nikolajevs/MicroGarden_V1/hardware/PCB_EU_LITE/DESIGN.md

# EU-LITE — решения, расчёты и открытые вопросы

Состояние на 26.10.2026: силовые пути L501/Q501/D501 перенесены на F.Cu, LED_OUT/LED_POS — на внешнюю медь; у F101 установлен массив 10 переходных 0,8/0,4 мм. Отверстия не пересекают окна пасты. Текущие проверки и ограничения — в [README](README.md#проверки). Gerber r2 предшествуют этим изменениям. Ток 9 А, тепловой режим, Kelvin-съёмы, работа LED-регулятора и корпус требуют стендового подтверждения.

## Решения владельца (24.10.2026)

| Вопрос | Решение |
|---|---|
| Контроллер | ESP32-WROOM-32E-N4 из базы (7,48 €), как у EU-0.1: те же GPIO; адаптация прошивки для INA238 и минимума nDIM находится в `firmware/`. ESP32-C3 Super Mini со склада не взят |
| LED-часть | **Один канал** LM3429, 69 Вт / ≈1,444 А при 48 В суммарно на трёх параллельных выходах. Линейки (0,465 А) этим каналом не питаются |
| Упрощения | Убраны тахометры вентиляторов. SD-карта, RTC и измерение мощности сохранены |
| Индикатор | **OPTOSUPPLY OSTAPA57E2A**, 5 мм, диффузный, общий анод; цена по карточке Electrobase, присланной владельцем 25.10.2026 |
| Результат | Текущая медь проверена полным профилем KiCad 10.0.7; после исправления подписи F103 осталось текстовое расхождение с платой. Статус выпуска — в README |
| Стороны монтажа (25.10.2026) | Высокие компоненты сверху; BT301 и 37 SMD, включая RTC с обвязкой, снизу; силовые детали сверху |
| Разъёмы (25.10.2026) | KF2510/KF2540 4P — угловые 90°. SHT4x сверху справа над вентиляторами; поплавок, PTC и помпа снизу; вход 24 В слева. UART на месте, microSD слева под ним |
| Плата | **100×100 мм, 4 слоя меди**, стек как у EU-0.1 (JLCPCB JLC04161H-7628) — решение владельца 25.10.2026. Размер не уменьшен, несмотря на меньшее число деталей (158 против 188+ у EU-0.1): проще уложить дроссель DTMSS-27 (≈35 мм стоймя) и силовую медь без риска |

Остальное (защита от переполюсовки, предохранители, INA, RTC, SD, SHT4x, поплавок, помпа, PTC, два вентилятора) сохранено по EU-0.1; каждое отличие — в таблице ниже.

## Отличия от EU-0.1

| Узел | EU-0.1 | EU-LITE | Уходит из закупки EU-0.1 |
|---|---|---|---:|
| 12 В | L7987 + электролит 1000 мкФ, дроссель 33 мкГн | **ST1S14PHR (склад)**, электролит 820 мкФ (склад), дроссель 22 мкГн JNRH1207 | 4,93 € |
| 3,3 В | AP63203 + SRN6045 | **ST1S10PHR и SRN2512-2R2M (склад)** | 1,52 € |
| LED | два LM3429, TK22E10N1 на радиаторе, CSD19534KCS, два SS8PH10, четыре дросселя, пять электролитов 63 В, радиатор с набором изоляции, четыре токовых шунта | **один LM3429**, BSC146N10LS5, SBRT15U100SP5, дроссель 47 мкГн/15 А, электролит 470 мкФ/63 В и шесть керамических 4,7 мкФ/100 В — всё со склада; без радиатора. Докупаются LM3429 (4,86 €), два шунта и мелочь (6,06 € вместе) | 18,29 € (24,35 € → 6,06 €) |
| Блокировка LED | LM2903 + BAT54 + делители (UVLO 19,7 В, PGOOD 12 В) | **нет**; EN2 регулятора 12 В отключает вспомогательное питание; точный порог с учётом тока EN2 не квалифицирован. При потере 3,3 В ESP32 сбрасывается, nDIM удерживает 10 кОм | 0,43 € (+ резисторы) |
| Переполюсовка | FDB5800 + делитель 5,6k/5,6k/10k | **IRL2505 (склад)** + 10 кОм + стабилитрон 12 В (предел Vgs у IRL2505 16 В) | 1,82 € (1,98 € → 0,16 €) |
| Ключ PTC | FDB5800 | **CSD19531KCS, TO-220** (Salvats, каталог), драйвер NPN+PNP как у EU-0.1 | 2,95 € |
| Измерение мощности | INA226 + два шунта 0R01 + стабилитрон 33 В + резистор | **INA238 (склад)** + два металлических шунта 7 мОм (склад); VBUS без резистора и стабилитрона (предел 85 В) | 4,55 €; другие регистры в прошивке |
| Вентиляторы | тахо на GPIO34/35, подтяжки, ESDA6V1L ×2 | **без тахо**, без ESD-диодов; контакт 3 разъёма свободен | 0,52 € |
| Поплавок | USBLC6 на входе | **без USBLC6** (1 кОм + 100 нФ + подтяжка) | 0,67 € |
| Предохранители | семь (F101–F106, F401) | **шесть**: F104 канала LED2 убран | 0,78 € |
| Входные электролиты | шесть UPW1H221MPD | два UPW1H221MPD + керамика 10 мкФ/50 В (склад) | 2,52 € |
| Клеммы и кнопки | DG301R/DG306, SMD-кнопки TACTB | **KF301-5.0-2P и кнопки 6×6×10 THT (склад)** | 2,97 € |
| Прочее | керамика и резисторы упаковками, SS510 | детали со склада, SS56 | ≈ 5,7 € |
| RGB-индикатор | нет | **D901 OSTAPA57E2A + три BC847B + 9 резисторов** (резисторы со склада) | +0,18 € + 0,85 € |
| Деталей на плате | 188 + 8 контрольных площадок | **158 + 5 контрольных площадок** | — |
| Закупка (деталь + НДС + доставка) | 81,17 € по строкам `BOM_allocated.csv` (в README EU-0.1 заявлено 81,25 €) | **38,49 €** (32,62 € + 5,87 €), включая OSTAPA57E2A и CSD19531KCS | **42,68 €** |

Закупка EU-LITE (38,49 €) включает OSTAPA57E2A по карточке Electrobase с ценой 0,85 € с НДС, присланной владельцем 25.10.2026, и CSD19531KCS по снимку локального каталога от 23.10.2026 (2,95 €, 7 шт.); наличие не проверялось через корзину. Остальные цены взяты из снимка каталога 23.10.2026; доставка 2,99 € + 2,88 € — из README EU-0.1 и не перепроверена. Это не оферта и не заказ.

## Питание

### 24 В → 12 В, ST1S14PHR

Вход 5,5–48 В, 3 А, 850 кГц, VFB 1,222 В, не синхронный (диод SS56). Выводы: 1 BOOT, 2 PG (не используется), 3 EN1 (активный низкий — на GND), 4 FB, 5 EN2 (активный высокий), 6 GND, 7 VIN, 8 SW, площадка — GND. Делитель 82 кОм + 6,2 кОм / 10 кОм: **12,00 В** номинально; оценка по VFB 1,196–1,245 В и резисторам 1 % — примерно **11,54–12,45 В**, без отдельного учёта тока FB и динамики.

EN2 питается от +24V_AUX через R104–R106 (3×150 кОм, 5 %) и R107 (47 кОм, 1 %). Расчёт без нагрузки делителя: 2,04 В при 21,6 В и 3,97 В при 42 В; худший резисторный угол при 21,6 В — около 1,94 В. **15,9 В — пересечение идеального делителя с уровнем гарантированного включения 1,5 В, а не гарантированный порог UVLO.** Эквивалентное сопротивление около 42,6 кОм делает напряжение чувствительным к току EN2. Даташит задаёт 2,7/5,8/10 мкА при EN2=12 В, но не гарантированный ток около 2 В; переносить эти числа в строгий расчёт порога нельзя. Включение и отключение на медленном изменении входа и под нагрузкой проверить на стенде. Источник: [ST1S14, Rev 3, таблицы 2/6](https://www.st.com/resource/en/datasheet/st1s14.pdf).

Дроссель 22 мкГн (JNRH1207-220M-A: Isat 5,6 А по названию карточки Electrobase) даёт пульсацию 0,33 А; выходной электролит 820 мкФ (ESR ≈60 мОм) с керамикой 10 мкФ. Устойчивость контура с таким электролитом **не рассчитана**: внутренняя компенсация, модели нет (как в cheap-version, проверка на макете).

### 12 В → 3,3 В, ST1S10PHR

Вход 2,5–18 В, синхронный, 900 кГц при SYNC на GND, VFB 0,8 В. Выводы: 1 VIN_A, 2 INH (к VIN — включён), 3 VFB, 4 AGND, 5 SYNC, 6 VIN_SW, 7 SW, 8 PGND, площадка — GND. Делитель 100 кОм / (47 кОм ‖ 100 кОм = 31,97 кОм): **3,30 В** номинально. Оценка по VFB 0,776–0,824 В (−25…+125 °C) и резисторам 1 % — примерно **3,16–3,45 В**, без отдельного учёта тока FB и динамики; прежние 3,24–3,37 В не были полным бюджетом допусков.

Дроссель — склад SRN2512-2R2M вместо 4,7 мкГн у cheap-version: пульсация 1,2 А (верхний край окна даташита 0,6–1,2 А для 3 А), пик 1,6 А при 1 А нагрузки при Isat 2,7 А; частота LC 19–22 кГц ближе к расчёту даташита (18,7 кГц), чем у 4,7 мкГн (11,6 кГц). Это выбор «из склада», а не рекомендация даташита: нагрев L201 и шум на +3V3 проверяются на макете.

Рабочий предел VIN ST1S10 — 18 В, абсолютный — 20 В: проверить выбросы +12V при пуске, сбросе и скачках нагрузки. По [ST1S10, Rev 7, разделу 5.3](https://www.st.com/resource/en/datasheet/st1s10.pdf) рекомендовано минимум 22 мкФ керамики с короткими соединениями; пример настройки LC — 3,3 мкГн / 22 мкФ. Для установленных 22 мкФ учитывать DC-bias и допуск; удалённые конденсаторы нельзя автоматически считать эквивалентными локальному на частоте переключения.

### Вход 24 В и измерение мощности

**Защита входа.** J101 (KF301) → F101 15 А → +24V_FUSED, TVS SMBJ26A (ограничение ≈42 В). Минус входа проходит через Q102 (IRL2505, TO-220 стоймя без радиатора, оценка до ≈1 Вт при проектных 9 А, нагрев требует проверки), затвор подтянут к +24V_FUSED через 10 кОм (1206) и ограничен стабилитроном 12 В: Vgs ≈11–12 В при 21,6–25 В и не выше 12,6 В при ограничении TVS. При обратной полярности Q102 закрыт. Ветви 24 В: F102 8 А (PTC), F103 6,3 А USI fast (LED, 3413.0224.11), F104 2 А (регулятор 12 В), F105 1 А (помпа); на шине 12 В — F401 2 А (вентиляторы). Избирательность и I²t не квалифицированы.

**Измерение мощности.** INA238 (VSSOP-10, выводы 1 A1, 2 A0, 3 ALERT, 4 SDA, 5 SCL, 6 VS, 7 GND, 8 VBUS, 9 IN−, 10 IN+) на 0x40; шунт — два MSMA1206R0070FCM параллельно = **3,5 мОм** в минусе между GND платы и истоком Q102 (IN+ Kelvin к GND-площадке R111). ADCRANGE=1 (±40,96 мВ): полная шкала **11,7 А** при расчётном токе платы до 8,7 А и проектном пределе 9 А; каждый шунт рассеивает 0,1–0,24 Вт. Напряжение +24V_FUSED подаётся на VBUS напрямую. Выводы, адрес и шкала INA238 сверены по первичному PDF TI 24.10.2026 (пункт 1 ниже); работа драйвера на плате не проверена.

## LED-канал

Один LM3429 (HTSSOP-14), выход **класса 69 Вт при 48 В**. R505=4,7 кОм и R506=1 кОм, оба 1% в 1206; RCSH=5,7 кОм, R503=R504=1 кОм, R502=0,15 Ом/2 Вт. По формуле ILED=VCSH×RHSP/(RCSH×RSNS): типовое VCSH=1,235 В из электрической таблицы даёт **1,444 А и 69,3 Вт** при 48 В; округлённое 1,24 В из формулы TI — 1,450 А/69,6 Вт. Это суммарный ток всех выходов. Прежняя комплектация R506=620 Ом (1,548 А / 74,3 Вт) заменена вместе с переходом частоты на 283,45 кГц: при меньшей частоте ток через дроссель растёт, и запас по порогу IS восстановлен снижением уставки LED.

**J501/J502/J503** — три параллельных KF301-2P справа: (94;61), (94;74), (94;87) мм, 90°, сверху. Pin 1 LED_POS подключён **после** R502, pin 2 — GND. Общий плюс разведен дорожкой 1 мм по F.Cu. Ток на каждый разъём отдельно не регулируется: подключаемые LED-ветви должны иметь согласованные Vf; распределение тока проверяется измерением.

**Запас по току.** По [TI LM3429 Rev. H, электрическая таблица и разделы 7.3.4/7.3.6](https://www.ti.com/lit/ds/symlink/lm3429.pdf): VCSH=1,21/1,235/1,26 В и IS=215/245/275 мВ min/typ/max. Старые 200 мВ для IS заменены данными первичного даташита. Модель верхнего тока с VCSH=1,26 В и тремя резисторными допусками 1% даёт 1,519 А. При 21,6 В, Vf=48 В, КПД 90%, L=43,5 мкГн и 283,45 кГц пик входного тока — **4,23 А**. Минимум IS с R501+1%: 0,215/(0,04×1,01)=**5,32 А**, отношение 1,26×, то есть около **25,8% запаса**; при L=42 мкГн (значение L501 под током 5 А) — 4,25 А и 25,3%. Это расчёт при указанных предположениях; полный разброс индуктивности, смещения усилителя, шум и нагрев не квалифицированы. Предохранитель F103 3413.0224.11 сохранён: это USI 1206 fast, а не time-lag; исправлена только подпись. Пуск и согласование I²t остаются непроверенными.

**Периодическая модель силового каскада.** [Воспроизводимый расчёт](review/LED_boost_simulation.md) интегрирует фазы PWM и решает периодическое состояние L501/C508 с уточнением шага примерно с 25 до 12,5 нс. Приняты L501 43,5 мкГн, DCR 30 мОм, R501 40,4 мОм, Q501 20,8 мОм, D501 0,60 В + 20 мОм и выходной банк 498,3 мкФ с условным ESR 60 мОм. LED-нагрузка заменена суммарным сопротивлением для 48 В после R502. При заданных 1,444 А и Vin 21,6/24/25 В пики L501 — 3,796/3,464/3,343 А; при 1,519 А и 21,6 В — 3,969 А (IS 160,4 мВ). Частота модели — номинал RCT 283,45 кГц. Ограничитель тока в модели отсутствует, 215 мВ используется только как справочный порог. Duty подбирается к току, поэтому регулирование LM3429 не подтверждено. Проверены баланс энергии и возврат состояния за период; идеальный boost и перегрузка проверяются независимыми тестами. Потери переключения, сердечника и нагрева не включены: модель не заменяет консервативную оценку 4,23 А с КПД 90%. Пуск, PRO/COMP, OVP/КЗ, nDIM, EMI, выбросы и токовое деление LED-ветвей остаются вне расчёта.

- **Дроссель** — Feryster DTMSS-27/0.047/15-V со склада (47 мкГн, 15 А, около 45,5 мкГн при 1 А и 42 мкГн при 5 А по cheap-version), тороид высотой около 35 мм. Реальную индуктивность, нагрев и корпус проверить физически.
- **Ключ Q501** — BSC146N10LS5. [Infineon Rev. 2.3](https://www.infineon.com/assets/row/public/documents/24/49/infineon-bsc146n10ls5-datasheet-en.pdf): 100 В; RDS(on) максимум 14,6 мОм при 10 В и 20,8 мОм при 4,5 В. Драйвер LM3429 около 7 В; прежняя оценка потерь 0,6 Вт для меньшего тока не применяется к 69 Вт. Ориентир при новой нагрузке — порядка 1 Вт с учётом переключения и роста RDS(on), требуется тепловая медь и измерение температуры. Силовой путь трёх истоков к R501 усилен до **0,8 мм по F.Cu без силовых vias**; измерительные ветви U501.12/TP04 сохранены у R501.1. Прямое соединение затвора с R512/R513 сохранено; ветвь подтяжки R514 перепроложена.
- **Диод** — SBRT15U100SP5, PowerDI5: pad 1 катод, pads 2 анод. Нагрев на 69 Вт проверить на стенде.
- **Выход:** 470 мкФ/63 В и шесть 4,7 мкФ/100 В X7R, 100 нФ/100 В — до R502. Потери R502 около 0,36 Вт номинально и 0,40 Вт в модели верхнего тока при номинале 2 Вт.
- **OVP** — около 54,6 В; RCT=82 кОм+6,2 кОм и CT=1 нФ: по формуле 6 LM3429 f=25/(88,2 кОм×1 нФ)=**283,45 кГц** (ранее 56 кОм = 402 кГц). COMP=22 мкФ, VCC=4,7 мкФ сохранены. Изготовитель L501 (Feryster DTMSS-27) указывает накопительные применения DC–300 кГц; номинал ниже 300 кГц не гарантирует верхнюю границу с полным разбросом таймера и RC — измерить.

**Минимальный PWM-импульс.** Модель старта 2×ILED×Vo×L/Vin² при верхнем токе, 48 В, 47 мкГн и 21,6 В даёт **14,69 мкс** (было 15,74 мкс при уставке 75 Вт). Для 1 кГц/8 бит установлен минимум **5 отсчётов = 19,53 мкс** в [прошивке](../../firmware/Board.h). До испытания малой яркости проверить импульсы осциллографом.

**Бюджет всей платы:** с PTC 100 Вт, помпой, 12-вольтовыми нагрузками и LED-моделью верхнего тока — около 8,69 А при 21,6 В и 8,67 А при 25 В. Принят проектный предел **9 А**, БП **24 В / 10 А**. Практический запас источника по току около 13–15%, токи пуска и фактический КПД требуют измерения. Существующие тепловые и Kelvin-узлы ещё дорабатываются.

## Нагреватель, помпа, вентиляторы

- **PTC 100 Вт (до 4,34 А при предельном входе 25 В).** GPIO32 → 10 кОм → NPN BC847B → PNP BC857B → 100 Ом → затвор CSD19531KCS (≈11,4 В). По [даташиту TI](https://www.ti.com/lit/ds/symlink/csd19531kcs.pdf): 100 В, TO-220, ±20 В затвор–исток, RDS(on) 7,7 мОм макс. при VGS=10 В; сток — вывод 2 и металлический фланец. Оценка проводимых потерь при 4,34 А — 0,15 Вт при комнатном RDS(on) и 0,22 Вт с запасом ×1,5 на нагрев. Это ниже прежнего BSC146N10LS5, но не заменяет измерение температуры на собранной плате. Фланец электрически соединён с PTC_DRAIN; заземлённый радиатор требует изоляционной прокладки. 4,7 кОм база–GND держит NPN закрытым даже при внутренней подтяжке ESP32 (0,40 В < 0,45 В). Драйвер IRS4427S со склада не используется: порог входа оставлял запас 0,14 В при 3,3 В (решение владельца в cheap-version от 04.10.2026). Внешний термовыключатель PTC обязателен.
- **Помпа.** AO3422 с 1 кОм и 100 кОм, SS56 — обратный диод.
- **Вентиляторы.** Два AO3422 на PWM (25 кГц, инверсия duty, как в EU-0.1), 12 В через F401. Контакт тахо (3) разъёма свободен.

## RGB-индикатор статуса

**Схема.** D901 — OPTOSUPPLY OSTAPA57E2A, 5 мм, диффузный RGB-светодиод с **общим анодом**. По даташиту выводы 1 G, 2 B, 3 общий анод, 4 R. Анод на шине +12V; каждый катод — через 2 кОм (1206, склад) на коллектор своего BC847B. База — через 4,7 кОм от GPIO (красный GPIO4, зелёный GPIO16, синий GPIO17), 100 кОм на GND держат светодиод тёмным при сбросе. Выбрана шина 12 В, а не 3,3 В: у зелёного и синего кристаллов Vf 3,0–3,3 В, и от 3,3 В через резистор ток не определён. Ток при Vf 2,0/3,1/3,1 В — **4,9/4,4/4,4 мА** (красный/зелёный/синий), резистор рассеивает 49 мВт, ток базы 0,55 мА насыщает ключ. Общая нагрузка на +12V — до 15 мА. Нагрузка на GPIO — 0,55 мА на канал.

GPIO4, GPIO16 и GPIO17 — не strapping-выводы и не заняты flash/PSRAM у WROOM-32E-N4 (модуль без PSRAM). Управление — LEDC PWM (рекомендация: 1–5 кГц, 8 бит), HIGH включает канал. Синий и зелёный кристаллы обычно ярче красного: яркость и гамма подбираются в прошивке; ориентир по току — до 20 мА на канал по даташиту типовых 5 мм RGB, здесь он в 4 раза ниже.

**Артикул и цена** — OSTAPA57E2A, Electrobase EB1854986288, 0,85 € с НДС за штуку и 99 шт. по карточке, присланной владельцем 25.10.2026. Источник изготовителя: [даташит OSTAPA57E2A](https://www.optosupply.com/uppic/2020811188683.pdf). В карточке магазина корпус назван выпуклым, даташит производителя указывает плоский верх; посадку следует делать по данным изготовителя.

**Индикация прошивки.** Один RGB-светодиод показывает фон состояния и короткие вспышки процессов. Реализация находится в `firmware/LiteControl.h`; приоритет фона сверху вниз:

Индикатор светится ровно, без мигания, и показывает только состояние платы.
Каждый канал либо полностью включён, либо выключен.

| Цвет (постоянный) | Условие |
|---|---|
| Синий | идёт инициализация в `setup()` |
| Красный | критическая ошибка: нет ответа SHT4x (прошивка уходит в аварийное отключение), RTC не выставлен или не отвечает |
| Фиолетовый | низкое напряжение питания (`bus_low`, ниже 21,6 В по INA238) |
| Жёлтый | предупреждение: нет SD-карты, INA238 не отвечает |
| Зелёный | норма |

Ход работы (PTC, помпа, запись на SD) и связь с роутером индикатором не
показываются — это видно в веб-интерфейсе.

Яркость индикатора и поведение ночью (вне расписания света: как днём, только неисправности или выключен) задаются на странице настроек платы, вкладка «Общее»; по умолчанию яркость прежняя (19 %, 48 из 255).

Индикатор гаснет вместе с шиной 12 В; точное входное напряжение отключения требует измерения EN2. Собственную потерю питания индикатор не показывает.

## GPIO

Раскладка EU-0.1 без тахо: I²C 21/22, SD SCK/MOSI/MISO/CS 18/23/19/13, LED nDIM 25, PWM вентиляторов 26/27, PTC 32, помпа 33, поплавок 14, UART 1/3, BOOT 0. **Добавлено: RGB-индикатор — красный GPIO4, зелёный GPIO16, синий GPIO17** (выводы модуля 26/27/28). GPIO34 и 35 (выводы модуля 6 и 7) — только подтяжки R206/R207.

GPIO34 и 35 подтянуты к +3V3 резисторами 10 кОм и ни с чем не соединены; тахометры прошивкой не опрашиваются. Драйвер INA238 и программное отключение LED при низком измеренном `bus_v` реализованы в `firmware/`. Это единственная защита LED при низком входном напряжении в диапазоне 16–19,7 В; она требует работоспособных ESP32 и INA238. Если INA238 не отвечает, свет по решению владельца (27.10.2026, 28.10.2026) не гасится, пока есть время; при молчащем SHT4x он идёт на минимальном уровне: в этом состоянии защиты нет. Остальные GPIO сохранены по EU-0.1.

## Склад: сколько осталось

Использованы 38 строк склада (115 шт.). Без запаса остаются: INA238, IRL2505, дроссель DTMSS-27, электролиты EEVFK1J471M и EEEFT1E821AP. Для BSC146N10LS5 (Q501) остаётся один экземпляр; Q703 теперь CSD19531KCS из каталога. Ошибка монтажа или повреждение позиций без остатка означает поиск замены. По остальным складским позициям запас есть (`BOM_allocated.csv`, колонка `Stock_left`).

## Текущее состояние платы

Kelvin-ветви INA238 геометрически изолированы от одноимённой меди до площадок R111. C107 находится на B.Cu у U101 (28,25;70,5 мм). Возвратный GND-переход U101 перенесён из вывода 6 в **(26,65;70,05 мм)**; прежнее замечание о переходном (26,65;67,95) закрыто. Под тепловыми площадками U101/U201 массива переходных нет; ближайший GND-переход U201 — (42;40,5 мм). Теплоотвод обоих регуляторов требует проверки и при необходимости доработки внешней GND-меди с переходными вне пасты.

Под U501 удалены четыре отверстия из окна пасты, GND-переходные расположены снаружи. +24V_RAW подключён к F101 через 10 переходных 0,8/0,4 мм с шагом 1,1 мм. Подача к L501 и LED_SW проходят по F.Cu; внутренний крючок LED_SW удалён, LED_OUT/LED_POS используют внешнюю медь. PSU_RTN усилен внешней заливкой, у ESP32 установлены 7 локальных GND-переходных. 32 переходных с кольцом 0,10 мм остаются в стеснённых местах. Площадка Q501 относится к LED_SW: соединять её с GND нельзя.

Подключения четырёх ключей в схеме и на плате совпадают; перенумерация и перестановка проводов не требуются:

| Деталь | Вывод 2 | Вывод 3 |
|---|---|---|
| Q102 IRL2505 | D → PSU_RTN | S → RTN_SHUNT |
| Q703 CSD19531KCS | D → PTC_DRAIN | S → GND |
| Q701 BC847B | E → GND | C → PTC_NPN_C |
| Q702 BC857B | E → +12V | C → PTC_DRV |

Последний полный профиль KiCad 10.0.7 и CAM-импорт — в [review/power-copper-2026-10-26/](review/power-copper-2026-10-26/). Он предшествует исправлению текста F103. Текущий `fabricate.py` останавливается на старом Value F103 в плате; старые Gerber r1/r2 не соответствуют текущей меди. Новый комплект требует согласования поля и полного повторного прогона. Статус и команды — в [README](README.md#проверки).

## Открытые вопросы

1. **Выводы по даташитам — сверено 24.10.2026 и 25.10.2026.** Для CSD19531KCS по [даташиту TI](https://www.ti.com/lit/ds/symlink/csd19531kcs.pdf) проверены TO-220, номера 1=G, 2=D, 3=S, VDS=100 В, VGS=±20 В и RDS(on) до 7,7 мОм при VGS=10 В. Остальные проверенные источники: ST1S14 (STMicroelectronics, DocID17977 Rev 3), ST1S10 (STMicroelectronics, DocID13844 Rev 7), INA238 (Texas Instruments, SLYS025B, Rev B), BSC146N10LS5 (Infineon, Rev 2.3) и SBRT15U100SP5 (Diodes Incorporated, DS36524 Rev 9-2). Для них совпали таблицы выводов и параметры, перечисленные выше: ST1S14 (1 BOOT, 2 PG, 3 EN1, 4 FB, 5 EN2, 6 GND, 7 VIN, 8 SW, площадка — GND; вход 5,5–48 В, предел тока 3,7–5,2 А); ST1S10 (1 VIN_A, 2 INH, 3 VFB, 4 AGND, 5 SYNC, 6 VIN_SW, 7 SW, 8 PGND, площадка — GND; вход 2,5–18 В, VFB 0,8 В, SYNC на GND → 900 кГц); INA238 (1 A1, 2 A0, 3 ALERT, 4 SDA, 5 SCL, 6 VS, 7 GND, 8 VBUS, 9 IN−, 10 IN+), адрес 0x40, полная шкала ADCRANGE=1: 40,96 мВ / 3,5 мОм = 11,70 А; BSC146N10LS5 RDS(on) 12,2 мОм тип. / 14,6 мОм макс. при VGS=10 В и Qg 7,6 нКл / Qgd 2,8 нКл; SBRT15U100SP5 (PowerDI5) — площадка катод, два боковых вывода анод. Расчёты устойчивости контуров и проверка фактического нагрева остаются открытыми.
2. **Выпуск файлов.** Согласовать только поле Value F103 платы с `6.3 A fast` в схеме, не меняя MPN, номинал, выводы и соединения, затем повторить полный профиль KiCad 10.0.7 и сформировать новый производственный комплект. В этой редакции документации плата оставлена без изменений. Сохранённые отчёты не считать свежим прогоном после исправления F103.
3. **Посадки.** Для деталей без чертежа в репозитории (SOIC-8-1EP для ST1S14/ST1S10, TDSON-8-1, 1008 для SRN2512, PowerDI5, DTMSS-27) назначены стандартные имена KiCad или посадки cheap-version; физическая примерка и сверка не выполнялись. Размеры DTMSS-27 взяты из cheap-version, реальный дроссель замерить.
4. **Карточка Electrobase.** Цена 0,85 € с НДС и наличие 99 шт. для OSTAPA57E2A взяты из карточки, присланной владельцем 25.10.2026; корзина магазина отдельно не проверялась. Формовка выводов до шага 2,54 мм ещё не опробована на образце (см. пункт 10).
5. **Устойчивость и нагрев.** Пуск и отключение EN2; контур ST1S14 с электролитом 820 мкФ; ST1S10 с 2,2 мкГн, эффективная ёмкость локальных MLCC и выбросы +12V; теплоотвод U101/U201 без массива тепловых переходных; нагрев Q501 BSC146N10LS5 без радиатора, нового ключа PTC Q703 и IRL2505, а также дросселя JNRH1207-220M-A (по названию карточки Electrobase Ioper 5,4 А, Isat 5,6 А, выше предела тока ST1S14 3,7–5,2 А; даташит Jantek не перечитывался) требуют проверки на макете ([чек-лист](review/Bench_checklist.md)).
6. **Потеря защиты.** Аппаратный UVLO 19,7 В и блокировка по PGOOD убраны. Прошивка запрещает LED при измеренном напряжении ниже 21,6 В и повторно разрешает его от 22,5 В (`firmware/LiteControl.h`). Если INA238 не отвечает совсем, свет по решению владельца (27.10.2026) остаётся включённым при известном времени (при молчащем SHT4x на минимальном уровне), а плата пишет об этом в журнал. Программная блокировка зависит от исправности ESP32 и INA238; она не заменяет аппаратную защиту, а без INA238 не действует вовсе. Проверить пороги, время реакции и поведение при brownout на стенде. При необходимости вернуть LM2903 + BAT54 из EU-0.1 (≈0,7 €).
7. **Терминалы и предохранители.** Для KF301 cheap-version приводит 17 А по данным LCSC; номинал купленной партии сверить. Расчётный ток платы с LED 69 Вт до 8,44 А (проектный предел 9 А) (9,3 А у EU-0.1 с двумя LED-каналами). F103 — USI fast 6,3 А; F101/F102 — UST time-lag 15/8 А, F104/F105/F401 — UMT time-lag. Селективность и I²t не проверены. PTC — нагреватель, F102 — одноразовый предохранитель; измерить холодный пусковой ток нагревателя и пуск LED, сопоставить с времятоковыми кривыми и I²t конкретных артикулов.
8. **Цены.** Каталог от 23.10.2026, доставка — из README EU-0.1; перед заказом перепроверить наличие (AO3422 продаётся пачками по 5, два лишних).
9. **Разводка платы и корпус.** Плата 100×100 мм, 163 позиции, четыре монтажных отверстия и четыре медных слоя. После обновления 26.10.2026 силовая подача F103–L501 и L501–Q501–D501 проходит по F.Cu; LED_OUT/LED_POS — по внешним слоям. У F101 установлен массив 10 переходных 0,8/0,4 мм. PSU_RTN усилен внешней медью, возле ESP32 добавлены GND-vias; переходные не пересекают окна пасты. 23 малых кольца увеличены до 0,15 мм, 28 с кольцом 0,10 мм оставлены для дальнейшей доработки. 28.10.2026 GND-сторона шунтов R111/R112 соединена с плоскостью 19 переходными. Коммутационная петля LED сжата: D501 стоит на стоке Q501, а C515/C514/C513 включены между катодом и землёй R501. Подробности — в README, раздел «Разводка (28.10.2026)». Сохраняются короткий LOGIC_SW, Kelvin-ветви INA238 и U501.12/TP04 у R501.1. Высота L501, батарейный держатель, корпус, тепловая медь и температурные испытания остаются открытыми. Полная проверка текущей меди и ограничения — в README; Gerber r2 устарели.
10. **Формовка выводов D901.** Даташит OSTAPA57E2A задаёт ширину вывода 0,5 ±0,1 мм и шаг 1,25 мм. Для ряда отверстий 2,54 мм сделана отдельная посадка с отверстиями 1,0 мм и площадками 1,8 мм. Перед пайкой нужно проверить формовку на фактическом светодиоде. Даташит изготовителя указывает плоский верх, карточка Electrobase — выпуклый корпус. DRC кольца D901 проходит без ошибок.
11. **3D-визуализация.** Пути общих моделей EU-0.1 исправлены для папки EU-LITE. Стандартная модель `SOIC-8-1EP_3.9x4.9mm_P1.27mm_EP2.41x3.3mm.step` для U101/U201 отсутствует в локальной KiCad 10.0.5; их вид в 3D не подтверждён. Посадки остаются в проекте и участвуют в проверке куртяров/DRC. Механическая примерка всех деталей и доступ для монтажа остаются стендовыми вопросами.

## Расположение внешних подключений

SHT4x J401 справа сверху над вентиляторами J411/J421; ниже расположены параллельные LED-выходы J501/J502/J503. Поплавок J403, PTC J701 и помпа J702 выведены вниз. Вход 24 В J101 находится слева. UART J201 не перемещался: x=4, y=9,75 мм, угол 0°. MicroSD J301: x=16,5, y=27,5 мм, угол −90°, выход влево под UART. Держатель батареи остаётся снизу платы. Координаты и проверяемые коридоры подключения — в `placement.json`; `check_placement.py` запрещает изменение UART, разворот портов внутрь и перекрытие доступа. Для кабелей и карты заложен проектный коридор 20 мм; конкретные ответные части и корпус ещё не проверены.

Посадка вентиляторов заменена с вертикальной Molex на локальную `KF2510_1x04_P2.54mm_RightAngle`. Она создана по габаритам [LHE A2543-WR04 / 2510-4AW, стр. 14](https://www.lhecn.com/wp-content/uploads/2019/01/a25432510.pdf); ряд отверстий 2,54 мм, площадки 1,8 мм, сверление 1,0 мм. Положение габаритного прямоугольника относительно ряда — по номинальным размерам чертежа, с запасом куртяра 0,5 мм. Условная VRML-модель показывает направление подключения и габарит, не заменяет модель изготовителя. Точная марка складской партии неизвестна: необходимо физически сверить угловое исполнение, выступы/ключ, нумерацию и выводы. Это не новая закупка и не подтверждение совместимости конкретной партии. Пины схемы сохранены (GND / +12V / NC / PWM).
