nikolajevs/MicroGarden_V1/hardware/PCB_EU_LITE/review/LED_frequency_283kHz.md

# Переход LED-канала на 283,45 кГц и 69,3 Вт

Записка описывает фактическое состояние исходников после перехода. Стендовых
измерений нет; всё ниже — расчёт и программные проверки.

## Что изменено

| Позиция | Было | Стало |
|---|---|---|
| R507 (RCT) | 56 кОм 1% 1206 | **82 кОм 1% 1206** (`CRCW120682K0FKTABC`, тот же артикул, что у R101) |
| R506 (уставка тока) | 620 Ом 1% 1206 | **1 кОм 1% 1206** (`SMD1206-1K-1%`) |
| Частота по формуле 6 LM3429 | 25/(62,2 кОм × 1 нФ) = 402 кГц | **25/(88,2 кОм × 1 нФ) = 283,45 кГц** |
| Ток LED (VCSH 1,235 В) | 1,548 А / 74,3 Вт при 48 В | **1,444 А / 69,3 Вт при 48 В** |

R505 4,7 кОм, R508 6,2 кОм, C506 1 нФ C0G, R501 0,040 Ом и R502 0,15 Ом не
менялись. На плате изменены только поля Value R506 и R507: геометрия, цепи и
шелкография не тронуты (шелкография несёт только обозначения).

Снижение уставки тока — не отдельное пожелание, а условие перехода: на меньшей
частоте пульсация тока дросселя растёт, и запас до порога IS восстановлен
уменьшением тока LED.

## Расчёт и запас по току

Консервативная модель `verify.py` (21,6 В, Vf 48 В, КПД 90%, VCSH 1,26 В,
допуски резисторов 1%): верхний ток 1,519 А, пик входного тока **4,23 А** при
L = 43,5 мкГн. Минимум порога IS: 0,215/(0,040 × 1,01) = **5,32 А**, запас
**25,8%** при требовании 20%. При L = 42 мкГн (значение L501 под током 5 А) —
пик 4,25 А и запас 25,3%.

Периодическая модель силового каскада (`tools/led_boost_simulation.py`,
частота взята из номинала RCT): пики L501 3,796/3,464/3,343 А при 21,6/24/25 В и
3,969 А в углу верхнего тока. Модель не включает потери переключения и
сердечника, динамику контроллера и нагрев.

Расчётный минимальный импульс старта стал 14,69 мкс (было 15,74 мкс). Минимум
nDIM в прошивке оставлен прежним — 5 отсчётов при 1 кГц/8 бит = 19,53 мкс, он
по-прежнему выше расчёта; `LED_MIN_PULSE_US` не менялся, обновлён только
комментарий.

## Закупка

Блокер снят без изменения итога: 82 кОм уже есть в снимке каталога от
23.10.2026 и теперь покупается в количестве 2 шт. (R101 + R507), строка 56 кОм
ушла. Строка 1 кОм 1206 добавлена в `procurement_lite.json` и в
`snapshot_prices.py` (`SITE_QUOTES`) по странице товара Salvats, прочитанной
27.10.2026: 0,03 EUR, остаток 490. Это не снимок `catalog.db`, цена и наличие
без подтверждения оформлением заказа. Итог закупки прежний: 32,62 EUR + 5,87
EUR доставки = **38,49 EUR**, непрайсованных позиций нет.

## Что прошло и что не прошло

Пройдено в этой среде: `generate.py` (схемы, `design.json`, BOM),
`verify.py` — 58 проверок, мутационные тесты `test_verify.py`,
`test_led_boost_simulation.py`, `test_snapshot_prices.py`,
`check_schematics.py` (447 выводов, 0 проблем), `tools/check_standalone.py`.

Не выполнялось: полный профиль KiCad 10.0.7 с `pcbnew`, Shapely 2 и gerbonara
(в среде их нет), поэтому DRC, паритет платы, `fabricate.py` и новый комплект
Gerber **не прогонялись**. Gerber r3 от 27.10.2026 относится к прежней
комплектации 402 кГц / 75 Вт и остаётся историческим.

Стендовая часть не закрыта: пуск при 21,6/24/25 В, устойчивость COMP, короткие
импульсы nDIM, OVP и КЗ, фактическая частота на SW, пульсации, нагрев Q501,
D501, R501/R502 и L501, деление тока между LED-ветвями. План — в
[Bench_checklist.md](Bench_checklist.md).

Источник: [TI LM3429 Rev. H](https://www.ti.com/lit/ds/symlink/lm3429.pdf)
