nikolajevs/MicroGarden_V1/IMPORT.md

# Импорт EU-LITE в MicroGarden_V1

Дата: 26.10.2026. Источник: [nikolajevs/PCB_EU, 7bdf28109dd0b46dcb12c7556a6aa5835d1a3d35](https://github.com/nikolajevs/PCB_EU/tree/7bdf28109dd0b46dcb12c7556a6aa5835d1a3d35).
Финальная документация включена из [PR №27](https://github.com/nikolajevs/PCB_EU/pull/27).

Схемы, проект KiCad, BOM, design.json и placement.json сохранены побайтово.
В плате изменены только пути локальных 3D-моделей; медь, цепи, площадки,
расположение компонентов и подписи сохранены. Имена PCB_EU_LITE и UUID оставлены
для совместимости схемы, платы, генераторов и сохранённых отчётов.

В комплект включены локальные зависимости: используемые общие посадки и модели,
контур с четырьмя отверстиями, функции стека/шелкографии/разбора KiCad и резервная
цена C1206C100J5GACTU. Сборка не обращается к соседнему PCB_EU или репозиторию ai.

Обновление цен дополнено тремя пропущенными позициями текущего BOM и защитой от
неполного снимка. Для Windows добавлен запуск скриптов через встроенный Python
KiCad с явным каталогом зависимостей. Результаты проверок — в [VALIDATION.md](VALIDATION.md).

Не включены: EU-0.1, его неадаптированная прошивка, старые производственные
архивы r1/r2, временные выгрузки, кэши и пользовательские настройки KiCad.
Исторические аппаратные отчёты оставлены как доказательства предыдущих прогонов;
они не заменяют проверку текущей версии. Архивы доступны через [индекс](hardware/PCB_EU_LITE/fabrication/README.md).

До нового производственного выпуска остаётся исправить текст Value F103 и
выполнить полный профиль на KiCad 10.0.7. Стендовые испытания и адаптация прошивки
под INA238 и минимальный nDIM остаются отдельными задачами.
