nikolajevs/MicroGarden_V1/firmware/README.md

# Прошивка MicroGarden V1 / EU-LITE

Адаптация прошивки контроллера EU-0.1 для автономного проекта MicroGarden V1.
Исходник скетча — `firmware.ino`; файлы веб-интерфейса и настроек лежат в `data/`.
Плата использует ESP32-WROOM-32E-N4 и совместимую с классическим ESP32 плату
Arduino ESP32.

## Изменения для Lite

- INA238 по I²C `0x40`; драйвер проверяет производителя/модель, конфигурацию и
  ошибку памяти регистра перед использованием измерений. Масштаб шунта — 3,5 мΩ.
- Только один LED канал на GPIO25. Минимум PWM — 5 отсчётов при 1 кГц/8 бит
  (19,53 мкс), чтобы соответствовать расчётному минимальному импульсу силового
  каскада (14,69 мкс при уставке 69 Вт и 283,45 кГц). Порог не менялся: он
  по-прежнему выше расчёта.
- Тахометров вентиляторов нет. API сохраняет поля `fan1_rpm` и `fan2_rpm` со
  значением `null` и сообщает `fan_tach_available: false`.
- RGB-индикатор на GPIO4/16/17 показывает неисправности самой платы: датчики,
  RTC, питание и SD. Светится ровно, без мигания; каждый канал либо полностью
  включён, либо выключен — смешанных оттенков и промежуточных яркостей нет.
  Ход работы (помпа, нагреватель, отправка телеметрии) и связь с роутером
  индикатором не показываются, это видно в веб-интерфейсе.

  | Цвет | Значение |
  |---|---|
  | Синий | идёт инициализация в `setup()` |
  | Красный | SHT4x не отвечает или времени RTC нет доверия |
  | Пурпурный | просадка шины: подача на LED заблокирована |
  | Жёлтый | нет SD-карты или нет данных INA238 |
  | Зелёный | норма |

  Проверки идут сверху вниз: более тяжёлая неисправность перекрывает более лёгкую.
  Синий гаснет, как только `loop()` впервые обновляет индикатор, поэтому
  задержавшийся синий означает, что плата не дошла до рабочего цикла.
  Та же расшифровка цветов есть на странице настроек (вкладка «Общее», под настройками индикатора);
  тест `tests/settings.test.cjs` следит, чтобы список цветов на странице совпадал с `StatusColor`
  в `LiteControl.h`.

  **Настройки** (страница настроек, вкладка «Общее», раздел «RGB-индикатор»), применяются сразу:
  - *Яркость, %* — от 0 до 100; 0 выключает индикатор совсем (неисправности тогда видны только на
    странице). По умолчанию 19 %, это прежняя постоянная яркость (48 из 255).
  - *Ночью* — «как днём» (по умолчанию), «только неисправности» (зелёный гаснет, красный,
    пурпурный и жёлтый остаются) или «выключен». Ночь — время вне расписания света на вкладке
    «Освещение»: индикатор светит в тёмный период растений, поэтому его можно приглушить.
    Синий при запуске (`setup()`) настройки не учитывает. Пока время не выставлено, день и ночь
    неизвестны, и ночной режим не действует: красный индикатор часов виден всегда.
- LED блокируется, если измеренное напряжение шины ниже 21,6 В. Повторное разрешение
  происходит при достоверном напряжении от 22,5 В. Одиночный пропущенный отсчёт INA238
  решение не меняет, а холодный пуск ждёт первого измерения. Если измеритель не отвечает
  совсем (не впаян, отказал, три чтения подряд неудачны), свет **не гасится**, пока плата
  знает время (RTC или программный таймер): без времени неизвестно, день сейчас или ночь,
  и свет выключается. Датчик SHT4x условием не является: если он тоже молчит, свет идёт на
  минимальном уровне (настройка «Мин. мощность лампы», по аварийному режиму климата).
  Решение владельца от 27.10.2026 и 28.10.2026: отказ измерителя и датчика не должен
  оставлять растения без света. Плата пишет в журнал «[Power] Нет связи с измерителем питания»,
  страница показывает предупреждение, RGB остаётся жёлтым.
  В Lite нет аппаратной UVLO/PGOOD-блокировки: **пока измеритель молчит, защиты от
  просадки питания нет**, она зависит от ESP32 и исправного INA238.

## Климат в Growing: лампа, вентиляторы и обогрев

Каждые 10 с плата пересчитывает лампу, вентиляторы и обогреватель от одной цели: днём (по расписанию
света) — дневной, ночью — ночной. Общая настройка «Гистерезис (Дельта ±)» задаёт обе стороны от цели.
По умолчанию днём 25 °C, ночью 17 °C, дельта 2 °C; в сушке цель 16 °C, гистерезис 0,5 °C.

| Температура | Лампа (днём) | Вентиляторы по температуре | Обогреватель |
|---|---|---|---|
| ниже цели − дельта | максимум | минимум | включается |
| от цели − дельта до цели | максимум | минимум | греет до цели |
| от цели до цели + дельта | плавно к минимуму | плавно к максимуму | выключен |
| выше цели + дельта | минимум | максимум | выключен |

Обогреватель лампу не приглушает, а только добавляет тепло, пока температура ниже цели. Вентиляторы
ниже цели не разгоняются, поэтому не выдувают тепло ни во время нагрева, ни сразу после него.
Решение владельца от 28.10.2026: днём лампа главная, и влажность при ней проблем не создаёт.
Раньше лампа и вентиляторы меняли мощность уже от «цели − дельта». При нагреве лампа тускнела, а в
момент выключения обогревателя вентиляторы выходили на середину диапазона.

**Ночью** вентиляторы следят и за влажностью. Выше настройки «Ночью: влажность» они разгоняются и к
верхней границе диапазона (не выше 100 %) выходят на максимум. Из требований по температуре и по
влажности берётся большее. Влажность учитывается и пока греет обогреватель: сырой воздух всё равно
нужно сменить, а нагрев сам снижает относительную влажность. По умолчанию 55 % и диапазон 10 %;
значение 100 % отключает слежение за влажностью. Днём влажность не учитывается.

Обогреватель включается только по расписанию на вкладке «Обогрев» и при 40 °C выключается при любых
настройках (программный предел, решение владельца от 28.10.2026; было 60 °C). Поэтому целевые
температуры (дневная, ночная и сушки) ограничены 40 °C. Значение выше, сохранённое прежней прошивкой,
при загрузке срезается до 40 °C. Внешний термовыключатель PTC остаётся обязательным.
При отказе SHT4x он выключен, вентиляторы стоят на середине диапазона, лампа днём на минимуме. В
сушке действует свой профиль: свет выключен, вентиляторы управляются по влажности сушки.

## Время: RTC и программный таймер

Свет и расписание полива работают, пока у платы есть время:
либо RTC отвечает и время в нём достоверно, либо **программный таймер** выставлен настоящим
источником с момента запуска: чтением RTC (потом RTC отказал) или временем, которое владелец ввёл
на странице настроек. Таймер идёт по `millis()` и уходит порядка секунд в сутки; до перезагрузки
этого хватает для света и полива. Дефолтная дата, с которой плата стартует при мёртвом RTC,
источником не считается. Пока время не выставлено, свет и полив выключены, климат держится по
ночным настройкам: без лампы в боксе ночь, а включать её по выдуманным часам нельзя. Решение
владельца от 28.10.2026: свету достаточно хотя бы введённого вручную времени. На главной странице
вместо «День»/«Ночь» показывается «Нет времени».

- RTC не отвечает, но время есть: RGB красный, в колокольчике на главной странице жёлтое оповещение
  «Часы RTC не отвечают: время идёт по программному таймеру до перезагрузки, свет и полив работают», в
  журнале при старте полива появляется пометка «(время по программному таймеру, RTC не отвечает)». Если
  времени нет совсем, оповещение красное: «свет и полив выключены, пока время не выставлено». Отдельной полосы про часы
  в шапке главной страницы больше нет, всё собрано в колокольчике.
- После перезагрузки при мёртвом RTC таймер теряется: время нужно ввести снова (вкладка
  «Общее»), иначе полив не начнётся. Замените или проверьте RTC: [стендовый список](../hardware/PCB_EU_LITE/review/Bench_checklist.md).
- Дата в шапке и карточках («День 160», день/ночь) считается по тому же времени. При невыставленном
  времени она не соответствует действительности.

## Оповещения на главной странице

Колокольчик в шапке главной страницы показывает число активных оповещений, по нажатию открывает
их список. Это **текущие неисправности**, а не журнал: оповещение пропадает, когда причина
устранена; история событий остаётся на вкладке «Консоль». Цвет колокольчика и счётчика — по
самому тяжёлому оповещению: серый (нет оповещений), жёлтый (предупреждения), красный
(что-то не работает); при росте числа оповещений колокольчик качается. В заголовке вкладки
браузера тоже стоит число, например «(2) MicroGarden V1».

| Оповещение | Уровень | Условие в `/api/status` |
|---|---|---|
| Датчик SHT4x не отвечает | красный | `sht_online = false` |
| Часы RTC не отвечают или не выставлены | красный без времени, жёлтый на программном таймере | `clock_trusted = false`, `clock_usable` |
| Свет выключен: питание ниже 21,6 В | красный | `power_ok` и `led_supply_blocked` |
| Свет выключен: нет данных питания и нет времени или датчика | красный | `power_ok = false` и `led_supply_blocked` |
| Измеритель питания не отвечает, свет работает без защиты | жёлтый | `power_ok = false`, свет не заблокирован |
| В баке нет воды | жёлтый | `water_sensor_enabled` и `water_present = false` |
| Последний полив пропущен | жёлтый | `last_water_skipped` |
| SD-карта не обнаружена | жёлтый | `sd_ok = false` |
| Нет связи с платой (показания страницы устарели) | красный | страница не получила ответ 10 с |

В режиме сушки оповещения про свет и полив не показываются. Правила лежат в
`firmware/data/alerts.js` и проверяются `tests/alerts.test.cjs`.

## Шапка главной страницы

Шапка занимает **одну строку на любой ширине экрана**. Слева время платы, значок цикла и адрес платы в сети
роутера, справа колокольчик оповещений и круглая кнопка-шестерёнка «Настройки» (у неё есть подпись для
чтения с экрана и подсказка, слова на кнопке нет).

| Значок цикла | Когда |
|---|---|
| ☀️ День 160 | выращивание, сейчас день; число — день цикла |
| 🌙 День 160 | выращивание, сейчас ночь |
| ☀️ или 🌙 Цикл не начат | на странице настроек не задана дата начала цикла |
| 🕓 Нет времени | время не выставлено: день и ночь неизвестны, номер дня не показывается |
| 🍂 Сушка | режим сушки |

Фазу суток передаёт сам значок (☀️ или 🌙), поэтому слово «День» в тексте всегда значит день цикла.
Подсказка при наведении расшифровывает значок («Сейчас день, день цикла 160»). Текст и значок выбирает
`Format.cycleView()` из `format.js`, его проверяет `tests/format.test.cjs`.

На телефоне (до 600 px) значки сжаты и выровнены по высоте, у адреса нет значка 📶. Контейнер значков высотой
в одну строку: если места не хватает, первым пропадает адрес платы, а значок цикла остаётся целым. Обычный адрес
вида `192.168.1.57` рядом с «День 160» виден от ширины около 350 px, длинный (`192.168.31.254`) от 360 px;
рядом с широкими значками ему нужно больше места: около 375 px при «Нет времени» и около 395 px при
«Цикл не начат». Адрес всегда есть на вкладке «WiFi» страницы настроек. Если страница перестала получать
ответы платы, вместо времени стоит красное «Нет связи», а адрес убирается. Ширины измерены в Edge на макете
платы, на настоящих телефонах не проверялись.

## Время работы обогревателя

Карточка «Обогреватель» на главной странице показывает, сколько нагреватель проработал **за сутки
платы** («Сегодня: 2 ч 05 мин», «не включался»). Счёт идёт на каждом проходе `loop()` по реальному
времени между проходами и начинается заново в полночь по часам платы (и при переводе часов на
другой день). Как и энергия за сутки, он не хранится в NVS: после перезагрузки платы или потери
питания счёт идёт заново с запуска, поэтому в середине суток значение может быть меньше настоящего.
Значение отдаёт `/api/status` в поле `heater_today_s`.

## Адрес платы в сети роутера

На странице настроек, вкладка «WiFi», раздел «WiFi роутера» показывает состояние подключения и
IP-адрес, который роутер выдал плате. Рядом ссылка «открыть интерфейс по этому адресу» и уровень
сигнала. Страница опрашивает плату раз в 4 секунды, пока открыта именно эта вкладка.

| Состояние | Точка | Что видно |
|---|---|---|
| Подключено | зелёная | «Подключено к роутеру», IP-адрес, сигнал: отличный (от −60 дБм и выше), хороший (до −70), слабый (до −80), плохой |
| Идёт попытка | жёлтая | «Подключаюсь к роутеру…», адреса пока нет |
| Нет связи | красная | «Нет подключения к роутеру»; плата повторяет попытку раз в 2 минуты, новые имя сети или пароль запускают её сразу |
| Сеть не задана | серая | «Сеть роутера не задана: введите имя сети и пароль ниже» |

- **Шапка главной страницы.** Тот же адрес стоит значком в шапке (см. раздел «Шапка главной страницы»), только
  пока плата подключена к роутеру: при попытке подключения, обрыве и незаданной сети его нет. Если страница
  перестала получать ответы платы, адрес тоже убирается (он мог смениться). Адрес выделяется целиком
  и без значка (`user-select: all`), чтобы его было удобно скопировать. Выбирает адрес
  `Format.routerAddress()` из `format.js`, его проверяет `tests/format.test.cjs`.
- Адрес платы **в её собственной сети** (точка доступа, по умолчанию `192.168.4.1`) показан в описании
  раздела «Точка доступа» там же.
- `/api/status` отдаёт `wifi_state` (`not_configured`, `connecting`, `connected`, `disconnected`),
  `wifi_ip` и `wifi_rssi` (оба `null`, пока нет подключения) и `ap_ip`. Состояние выбирает
  `wifiState()` из `LiteControl.h`, таблица истинности проверяется в `SafetyTests.h`. Адрес
  попадает в ссылку только после проверки, что это четыре числа через точки.
- Тот же адрес остаётся в журнале: «Роутер: подключено, веб-интерфейс на http://…/» (вкладка
  «Консоль» и USB).
- Роутер может выдать плате другой адрес после перезапуска или по окончании аренды. Чтобы
  адрес не менялся, закрепите его за платой в настройках роутера (резервирование DHCP по MAC).
- Страницы лежат в SPIFFS, поэтому после обновления нужно прошить и скетч, и образ `firmware/data`.

## Сила сигнала WiFi платы

На странице настроек, вкладка «WiFi», в форме «Точка доступа платы» есть список «Сила сигнала»: слабый,
средний, сильный. Он задаёт мощность передатчика ESP32, то есть как далеко и как уверенно телефон слышит
точку доступа платы.

| Уровень | Мощность | Значение `wifi_power` |
|---|---|---|
| Слабый | 7 дБм | 0 |
| Средний | 13 дБм | 1 |
| Сильный | 19,5 дБм | 2 (по умолчанию) |

Ступени отличаются примерно на 6 дБм: в свободном пространстве это около двух раз по дальности, в помещении
меньше. Сильный уровень равен значению SDK по умолчанию, поэтому у прошитых плат ничего не меняется, пока
настройку не тронули.

- **Радио одно.** ESP32 не умеет задавать мощность отдельно для точки доступа и для подключения к роутеру:
  выбранный уровень действует на обе. При слабом сигнале хуже может стать и связь платы с далёким роутером,
  а с ней отправка телеметрии. Разделить их нельзя.
- **Применяется сразу** после сохранения, без перезагрузки; точка доступа не перезапускается и клиенты не
  отключаются (пока не менялись имя сети или пароль). Плата сверяет мощность при запуске, при сохранении и
  в каждом проходе задачи WiFi (раз в 2 минуты и после попытки подключиться к роутеру): драйвер может вернуть
  своё значение при перезапуске точки доступа или подключении.
- **Как убедиться.** Под списком страница пишет «Сейчас на плате: 13 дБм» (поле `wifi_tx_dbm` из
  `/api/status`, это значение держит драйвер). Если там не то, что выбрано, драйвер настройку не принял.
  При смене уровня в журнале (вкладка «Консоль» и USB) появляется строка «WiFi: мощность средняя, 13.0 дБм.».
- **Если страница перестала открываться** после смены, подойдите ближе к плате или откройте её по адресу в
  сети роутера (раздел выше), если плата к нему подключена.
- **Не проверено на плате:** держит ли драйвер значение после подключения к роутеру, какая дальность и какой
  уровень сигнала на телефоне получаются на каждой ступени. Уровни взяты из таблицы мощностей SDK.
- **Где в коде.** `wifiPowerQuarterDbm()` и уровни в `LiteControl.h` (проверка `static_assert` в
  `SafetyTests.h` и сверка с `wifi_power_t` SDK в `firmware.ino`), `applyWifiPower()` в `firmware.ino`,
  настройка `wifi_power` в таблице `SETTING_DEFS` (ключ NVS `wifi_power`), тесты в `tests/settings.test.cjs`.

## Отправка телеметрии

Раз в минуту плата отправляет показания и новые строки журнала (то же, что идёт в Serial и во
вкладку «Консоль») на сервер панели из [dashboard/](../dashboard/README.md), по умолчанию
`https://dash.dvinsk.lat/api/ingest`. Формат запроса — в [dashboard/README.md](../dashboard/README.md#что-присылает-плата).

- **Включение.** Пока токен приёма не задан, плата ничего не отправляет. Адрес, имя платы и токен
  вводятся на странице настроек, вкладка «WiFi», раздел «Телеметрия». Плату нужно сначала
  зарегистрировать в панели: зарегистрируйтесь на сайте панели (страница `/register`, регистрация открыта
  для всех), затем на странице «Платы» кнопка «Добавить плату» один раз показывает адрес приёма, имя платы
  и токен (подробнее в [dashboard/README.md](../dashboard/README.md#люди-и-регистрация)). Плата и её
  токен принадлежат вашей записи: чужие люди их не видят.
  Имя платы в настройках должно совпадать с зарегистрированным, иначе сервер ответит отказом (403).
  Токен обратно через интерфейс платы не возвращается. Нужен WiFi роутера и выход в интернет.
- **Безопасность.** Только `https`. Сертификат сервера проверяется по закреплённому корню ISRG Root X1
  ([DashCA.h](DashCA.h), действует до 2035 года); для проверки срока сертификата плата получает время UTC
  по NTP (`pool.ntp.org`, `time.cloudflare.com`), RTC платы это не меняет. Пароли точки доступа и
  администратора печатаются только в USB и в журнал для отправки не попадают.
- **Журнал.** Плата отправляет только целые строки, а смещение в байтах и случайный номер запуска
  позволяют серверу принять повтор безопасно и пометить пропуск или перезагрузку. Если кольцевой
  буфер (4 КБ) переполнился между отправками, пропущенная часть помечается на странице.
- **Для колокольчика панели.** Кроме показаний плата присылает три поля, по которым панель считает
  те же оповещения, что и главная страница платы: `clock_usable` (есть время, которому можно верить),
  `water_skipped` (последний запланированный полив пропущен) и `op_mode` (0 выращивание, 1 сушка).
  Правила на плате (`firmware/data/alerts.js`) и на панели (`dashboard/static/alerts.js`) совпадают,
  это проверяет `tests/dashboard-alerts-parity.test.cjs`.
- **Влияние на работу.** Задача работает на Core 0 только на чтение снимков состояния и настроек.
  Недоступность сети, сервера или сертификата на свет, вентиляторы, нагрев и полив не влияет.
  Итог отправки пишется в журнал при смене результата и раз в полчаса при затянувшейся ошибке.
- **Память.** HTTPS (mbedTLS) возвращает в прошивку задачу со стеком 12 КБ и около 130 КБ флеша:
  образ вырос с 84 % до 94 % раздела приложения (1 237 230 из 1 310 720 байт, свободно около 73 КБ),
  оперативная память — с 17 % до 19 %. Для новых функций запас небольшой.

Остальные функции унаследованы от EU-0.1. Сохраняются имена настроек и NVS,
поэтому существующие параметры не нужно мигрировать.

## Настройки из панели

Страница «Настройки платы» на сервере панели ([dashboard/README.md](../dashboard/README.md#настройки-платы-из-панели))
позволяет изменить настройки платы из браузера. Плата принимает такие изменения, только если владелец
разрешил их на самой плате.

- **Разрешение.** Страница настроек платы, вкладка «WiFi», раздел «Телеметрия», галочка «Разрешить менять настройки
  платы из панели» и «Сохранить телеметрию». **По умолчанию выключено** (настройка `cloud_control`, ключ NVS
  `cloud_ctl`): у уже работающих плат после перепрошивки ничего не меняется, пока галочку не поставят. Снять её
  можно в любой момент. Саму галочку из панели изменить нельзя. Страницы платы (`firmware/data/*`) загружаются
  отдельно от прошивки: без новой страницы галочки не будет.
- **Обмен.** В каждой отправке телеметрии плата добавляет раздел `cfg`: разрешение, номер последнего
  обработанного запроса с итогом и текущие значения настроек. В ответе на отправку сервер может приложить запрос
  `"cfg":{"id":"1a2b3c4d","set":{"temp_target":24.5}}`. Формат — в
  [dashboard/README.md](../dashboard/README.md#что-присылает-плата). Запрос приходит с отправкой, то есть плата
  применяет его не позже чем через минуту.
- **Что можно менять.** `CLOUD_PARAMS` в [CloudSettings.h](CloudSettings.h): режим, климат, свет, вентиляторы,
  обогреватель, полив (длительность не больше 300 с, на плате до 3600 с), индикатор, дата начала цикла. Не входят WiFi
  и точка доступа, адрес и токен панели, имя платы, поправка тока, датчик уровня воды и сама галочка: из панели
  нельзя отрезать плату от сети, снять защиту насоса от пустого бака или исказить замеры.
- **Как проверяется запрос.** Разбор ответа строгий (`parseCloudReply()`): порядок полей, имена из строчных
  латинских букв, цифр и `_`, числа без порядка, не больше 32 настроек; любое отступление отклоняет запрос целиком.
  Значения проверяются по таблице `SETTING_DEFS` (границы те же, что у формы, у полива жёстче), целые настройки
  должны быть целыми, минимум не больше максимума (форма молча меняет перевёрнутые границы местами, запрос из
  панели с такой ошибкой отклоняется). Применяется всё или ничего. Тот же номер запроса дважды не применяется
  (номер применённого запроса хранится в NVS, ключ `cloud_id`).
- **Запись.** Принятый запрос идёт тем же путём, что сохранение формы: копия настроек, запись в NVS только
  изменившихся полей (`saveChangedSettings()`), публикация целиком (`publishSettings()`); `loop()` подхватывает новые
  значения не позже чем через секунду. Двое пишут настройки (форма `/save-settings` и задача телеметрии), поэтому
  оба берут общий замок `settingsWriteMutex`: изменения не затирают друг друга. Итог каждого запроса пишется в
  консоль и уходит на панель: `[Cloud] Настройки из панели применены (…)` или `… отклонён (…)`.
- **Где в коде.** [CloudSettings.h](CloudSettings.h) (список, разбор и проверка значений, тесты `static_assert` в
  `SafetyTests.h`), `handleCloudReply()`, `applyCloudPatch()` и `appendCloudReport()` в `firmware.ino`, галочка на
  странице платы в `firmware/data/settings.html` и `settings.js`.
- **Память.** Образ вырос примерно на 6 КБ: с 1 241 754 до 1 247 878 из 1 310 720 байт (95 % раздела приложения),
  свободно около 62 КБ; оперативная память 65 856 байт (20 %); сборка с `--warnings all` без предупреждений.
  Запас для новых функций ещё меньше прежнего.
- **Не проверено на плате.** Разбор и правила проверены при сборке и тестами на компьютере, а применение
  на настоящей плате не проверялось. Перед первым использованием загрузите новую прошивку и страницы (SPIFFS), поставьте
  галочку и начните с безопасной настройки, например яркости индикатора.

## Сборка

Установите Arduino CLI и ESP32 Arduino Core 3.x, затем из корня репозитория:

```sh
arduino-cli compile --fqbn esp32:esp32:esp32 firmware
```

Нужные сторонние библиотеки: `RTClib`, `Adafruit SHT4x`, `ESPAsyncWebServer`
и её зависимость `AsyncTCP`. Установите их через Library Manager или Arduino
CLI. Остальные компоненты в `#include` предоставляет ESP32 Arduino Core.
INA238 реализована локально в `Ina238.h` и внешней библиотекой не требует.

После прошивки скетча отдельно соберите и загрузите файловую систему SPIFFS из
каталога `firmware/data` для того же ESP32. В ней хранятся веб-страницы и
JavaScript; одна сборка скетча их не загружает. Перед выпуском проверьте объём
раздела файловой системы и выберите ту же схему разделов при загрузке.

В исходниках есть compile-time проверки минимального LED импульса и INA238;
запустите также host-регрессии:

```sh
node --test tests/settings.test.cjs
python tools/check_standalone.py
```

## Первое включение

Сборка исходника не является квалификацией устройства. До подключения LED,
нагревателя и помпы пройдите [стендовый список](../hardware/PCB_EU_LITE/review/Bench_checklist.md):
проверьте выходы без нагрузки, аварийное отключение, показания INA238,
просадку питания, RTC, SD и работу датчиков. Для проверки порога отключения
света используйте ограниченный лабораторный источник и безопасную тестовую
нагрузку. Физическую защиту и температурные пределы подтвердите измерениями.
