nikolajevs/MicroGarden_V1/hardware/PCB_EU_LITE/fabrication/README.md

# Производственные файлы

Актуальный выпуск: [2026-10-28-r4](2026-10-28-r4/README.md). Полный профиль `fabricate.py`
пройден на KiCad 10.0.5 (`--allow-other-version`); целевая 10.0.7 этим выпуском не перепроверена.
Gerber, сверловка, manifest и отчёты проверок находятся в каталоге выпуска.

[2026-10-27-r3](2026-10-27-r3/README.md) — исторический, **не заказывать**: в нём GND-сторона
шунтов R111/R112 не соединена переходными с плоскостью GND, а коммутационная петля LED больше.
