nikolajevs/MicroGarden_V1/hardware/PCB_EU_LITE/fabrication/2026-10-28-r4/README.md

# EU-LITE — Gerber для изготовления прототипа

Архив: [PCB_EU_LITE_Gerber_072590c3.zip](PCB_EU_LITE_Gerber_072590c3.zip). SHA-256: `0c4d6348f006c9b7151384b78108e41324ddecd1e1989330ac66d21927395df2`.
Исходная плата: `072590c3533815e9163235b8b2c22f88f5bc998bcb9561c395b8729297c56faf`; исходная ревизия: `d9dca763499d178fb58c650f2a04610f95fbd849`.

100 × 100 мм, четыре медных слоя: F.Cu → In1.Cu → In2.Cu → B.Cu.
FR-4, номинально 1,6 мм; внешняя медь 1 oz, внутренняя 0,5 oz;
зелёная маска, белая шелкография. Сквозные переходы, маска на обеих сторонах.
В архиве отдельные PTH/NPTH Excellon в мм и абсолютные координаты;
платы не панелизированы, контролируемый импеданс не заявлен.

Проверки: свежие ERC, DRC с паритетом схемы, netlist, размещение,
съёмы INA238 Kelvin и производственная геометрия. Электрических и
геометрических DRC-проблем, неподключённых цепей и расхождений со схемой: 0.
Сохранено 35 предупреждений о библиотеке: независимо проверено,
что они относятся исключительно к печатным контурам, обрезанным возле площадок.
Правила DRC не отключались. Полные исходные отчёты находятся в `checks/`.

Gerber и Excellon повторно прочитаны независимым CAM-парсером: 4 слоя,
контур 100.10 × 100.10 мм. Обзоры CAM_top.svg/CAM_bottom.svg получены
из производственных файлов. Контрольные суммы всех файлов — в manifest.json.

Часть позиционных надписей имеет высоту 0,8 мм при штрихе 0,15 мм — абсолютный
минимум из рекомендаций JLCPCB; рекомендуемая высота 1 мм. При заказе сверить
предпросмотр шелкографии. [Источник](https://jlcpcb.com/blog/character-design-specifications).

Это первый прототип. Корпус, формовка выводов RGB, фактические разъёмы,
нагрев, минимальный PWM и прошивка INA238 требуют стендовых проверок.
Плату подключать сначала к лабораторному БП с ограничением тока;
см. ../../review/Bench_checklist.md. Это не заказ и не оплата производства.

## Отличия от r3 и версия KiCad

- **Земля шунтов.** GND-сторона шунтов INA238 R111/R112 соединена с внутренней плоскостью 19 переходными. В r3 обратный ток платы поднимался на F.Cu через вывод кнопки SW201.
- **Коммутационная ячейка LED.** D501 стоит на стоке Q501. C515 и два 4,7 мкФ/100 В включены между катодом D501 и землёй R501.
- **C508.** Подводка увеличена с 0,25 мм до 1 мм.
- **Поля.** Поля R505/R506/R507 на плате совпадают со схемой.
- **Версия KiCad.** Профиль выполнен на KiCad 10.0.5 с явным `--allow-other-version`. В manifest записано `target_version_verified: false`; целевая 10.0.7 этим выпуском не перепроверена. При заказе выбрать покрытие ENIG: батарея CR2032 прижимается к открытой площадке BT301.
