nikolajevs/MicroGarden_V1/VALIDATION.md

# Проверка самостоятельного импорта

Дата: 26.10.2026. Проверен импорт из PCB_EU `7bdf28109dd0b46dcb12c7556a6aa5835d1a3d35`.
Среда: Windows, Python 3.14 для проверки спецификации; KiCad/pcbnew **10.0.5**,
Shapely 2.2.0 для аппаратных проверок. Целевой профиль 10.0.7 здесь не запускался.

| Проверка | Результат |
|---|---|
| Самостоятельность | Локальные таблицы библиотек, посадки и модели разрешаются внутри проекта; ссылок на соседний PCB_EU нет; Markdown-ссылки на файлы проверены |
| Сохранность аппаратных исходников | Схемы, `.kicad_pro`, design.json, placement.json и BOM совпадают с источником; в плате заменён только префикс путей 3D-моделей |
| Регенерация в отдельной копии | Генератор воспроизводит схемы, проект, design.json и BOM без содержательных изменений; таблица библиотек остаётся локальной и без повторов |
| Спецификация и BOM | 58 проверок пройдены |
| Мутации спецификации | 29 преднамеренных дефектов отклонены; исходный проект проходит |
| Записанные листы схемы | 173 символа с учётом флагов питания, 447 выводов, 1517 UUID; 0 проблем |
| Свежий netlist и ERC | Экспорт выполнен; ERC — 0 нарушений |
| DRC с паритетом | 0 электрических/геометрических проблем, 0 неподключённых цепей; 35 библиотечных предупреждений подтверждены независимой проверкой как отличия только шелкографии; **1 расхождение Value F103** |
| Проверка готовой платы по netlist | Ожидаемо отклонена: `F103: value differs`; проверка не ослаблена |
| Стек и производственная геометрия | Пройдены: четыре слоя, 100 × 100 мм, толщина 1,6062 мм; проверены обе изолированные Kelvin-ветви INA238 |
| Силовые пути | Пройдены: 10 входных переходных, внешняя силовая LED-медь, отсутствие переходных в пасте, 7 GND-переходных ESP32 |
| Шелкография | Пройдена проверка сохранённого файла, без перезаписи платы |
| Новая неразведённая заготовка | Собрана только из локальных библиотек и механического шаблона; 163 электрические/контрольные посадки и 4 крепёжных отверстия; 18 792 проверки размещения пройдены |
| Регрессионные тесты | 3 LED-модели, 3 Kelvin-изоляции, 1 ограничений переходных — пройдены |
| Обновление цен | 2 теста пройдены: все строки актуального BOM сохраняются, одинаковый SKU двух резисторов не смешивается; отсутствие строки каталога не портит существующий снимок |

Временные отчёты создавались вне публикуемого дерева. Исторический
`hardware/PCB_EU_LITE/review/` сохранён отдельно и не подменён новым частичным
прогоном. Полный `fabricate.py`, новый Gerber/CAM-выпуск и физические испытания
**не выполнены**. До изготовления требуется согласовать поле F103 и повторить
полный профиль на целевой версии; далее пройти [план первого включения](hardware/PCB_EU_LITE/review/Bench_checklist.md).

Команды проверки и требования к окружению — в [README](README.md).
