nikolajevs/MicroGarden_V1/hardware/PCB_EU_LITE/PCB_EU_LITE.kicad_pcb

## KiCad design hardware/PCB_EU_LITE/PCB_EU_LITE.kicad_pcb (2026-10-28)

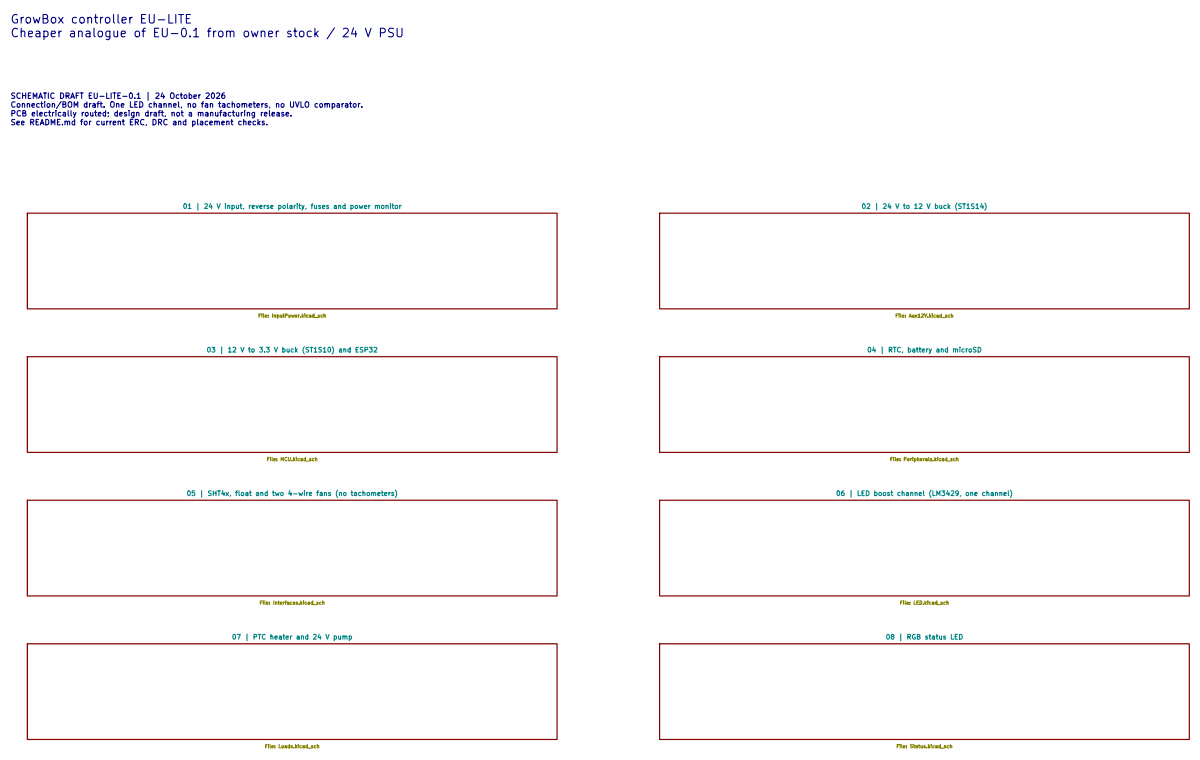
[picture p1: schematic PCB_EU_LITE.kicad_sch, GrowBox | EU-LITE | schematic review]

Notes on the sheet:
GrowBox controller EU-LITE Cheaper analogue of EU-0.1 from owner stock / 24 V PSU
SCHEMATIC DRAFT EU-LITE-0.1 | 24 October 2026 Connection/BOM draft. One LED channel, no fan tachometers, no UVLO comparator. PCB electrically routed; design draft, not a manufacturing release. See README.md for current ERC, DRC and placement checks.

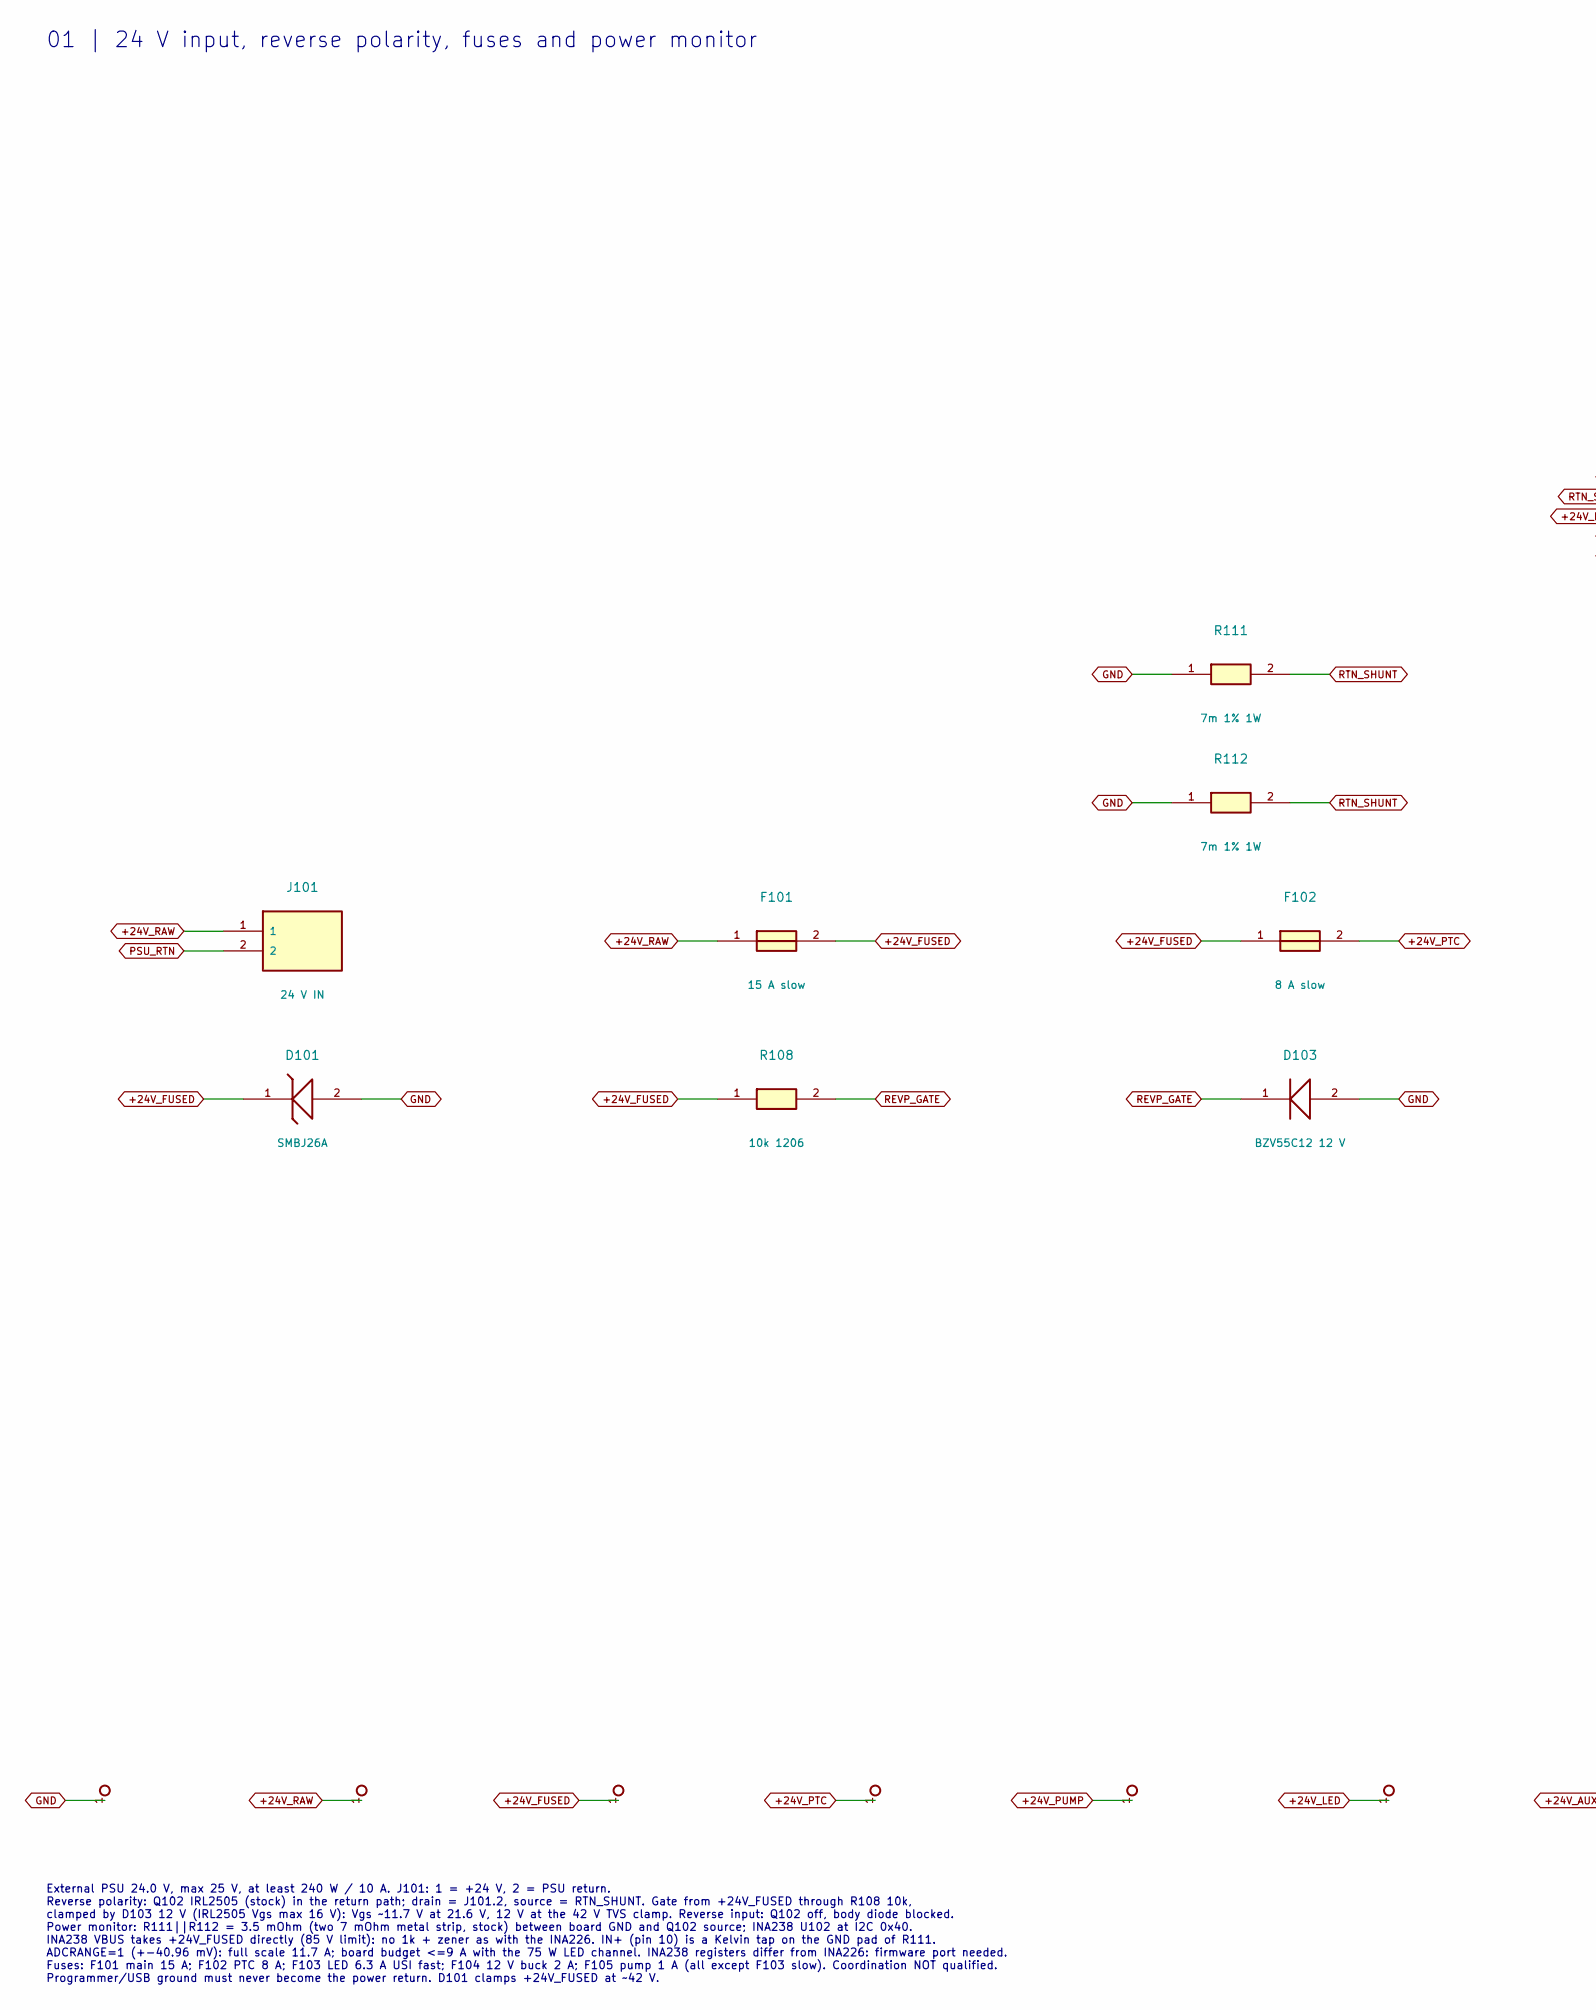
[picture p2: schematic InputPower.kicad_sch, 01 | 24 V input, reverse polarity, fuses and power monitor, part in row 1, column 1]

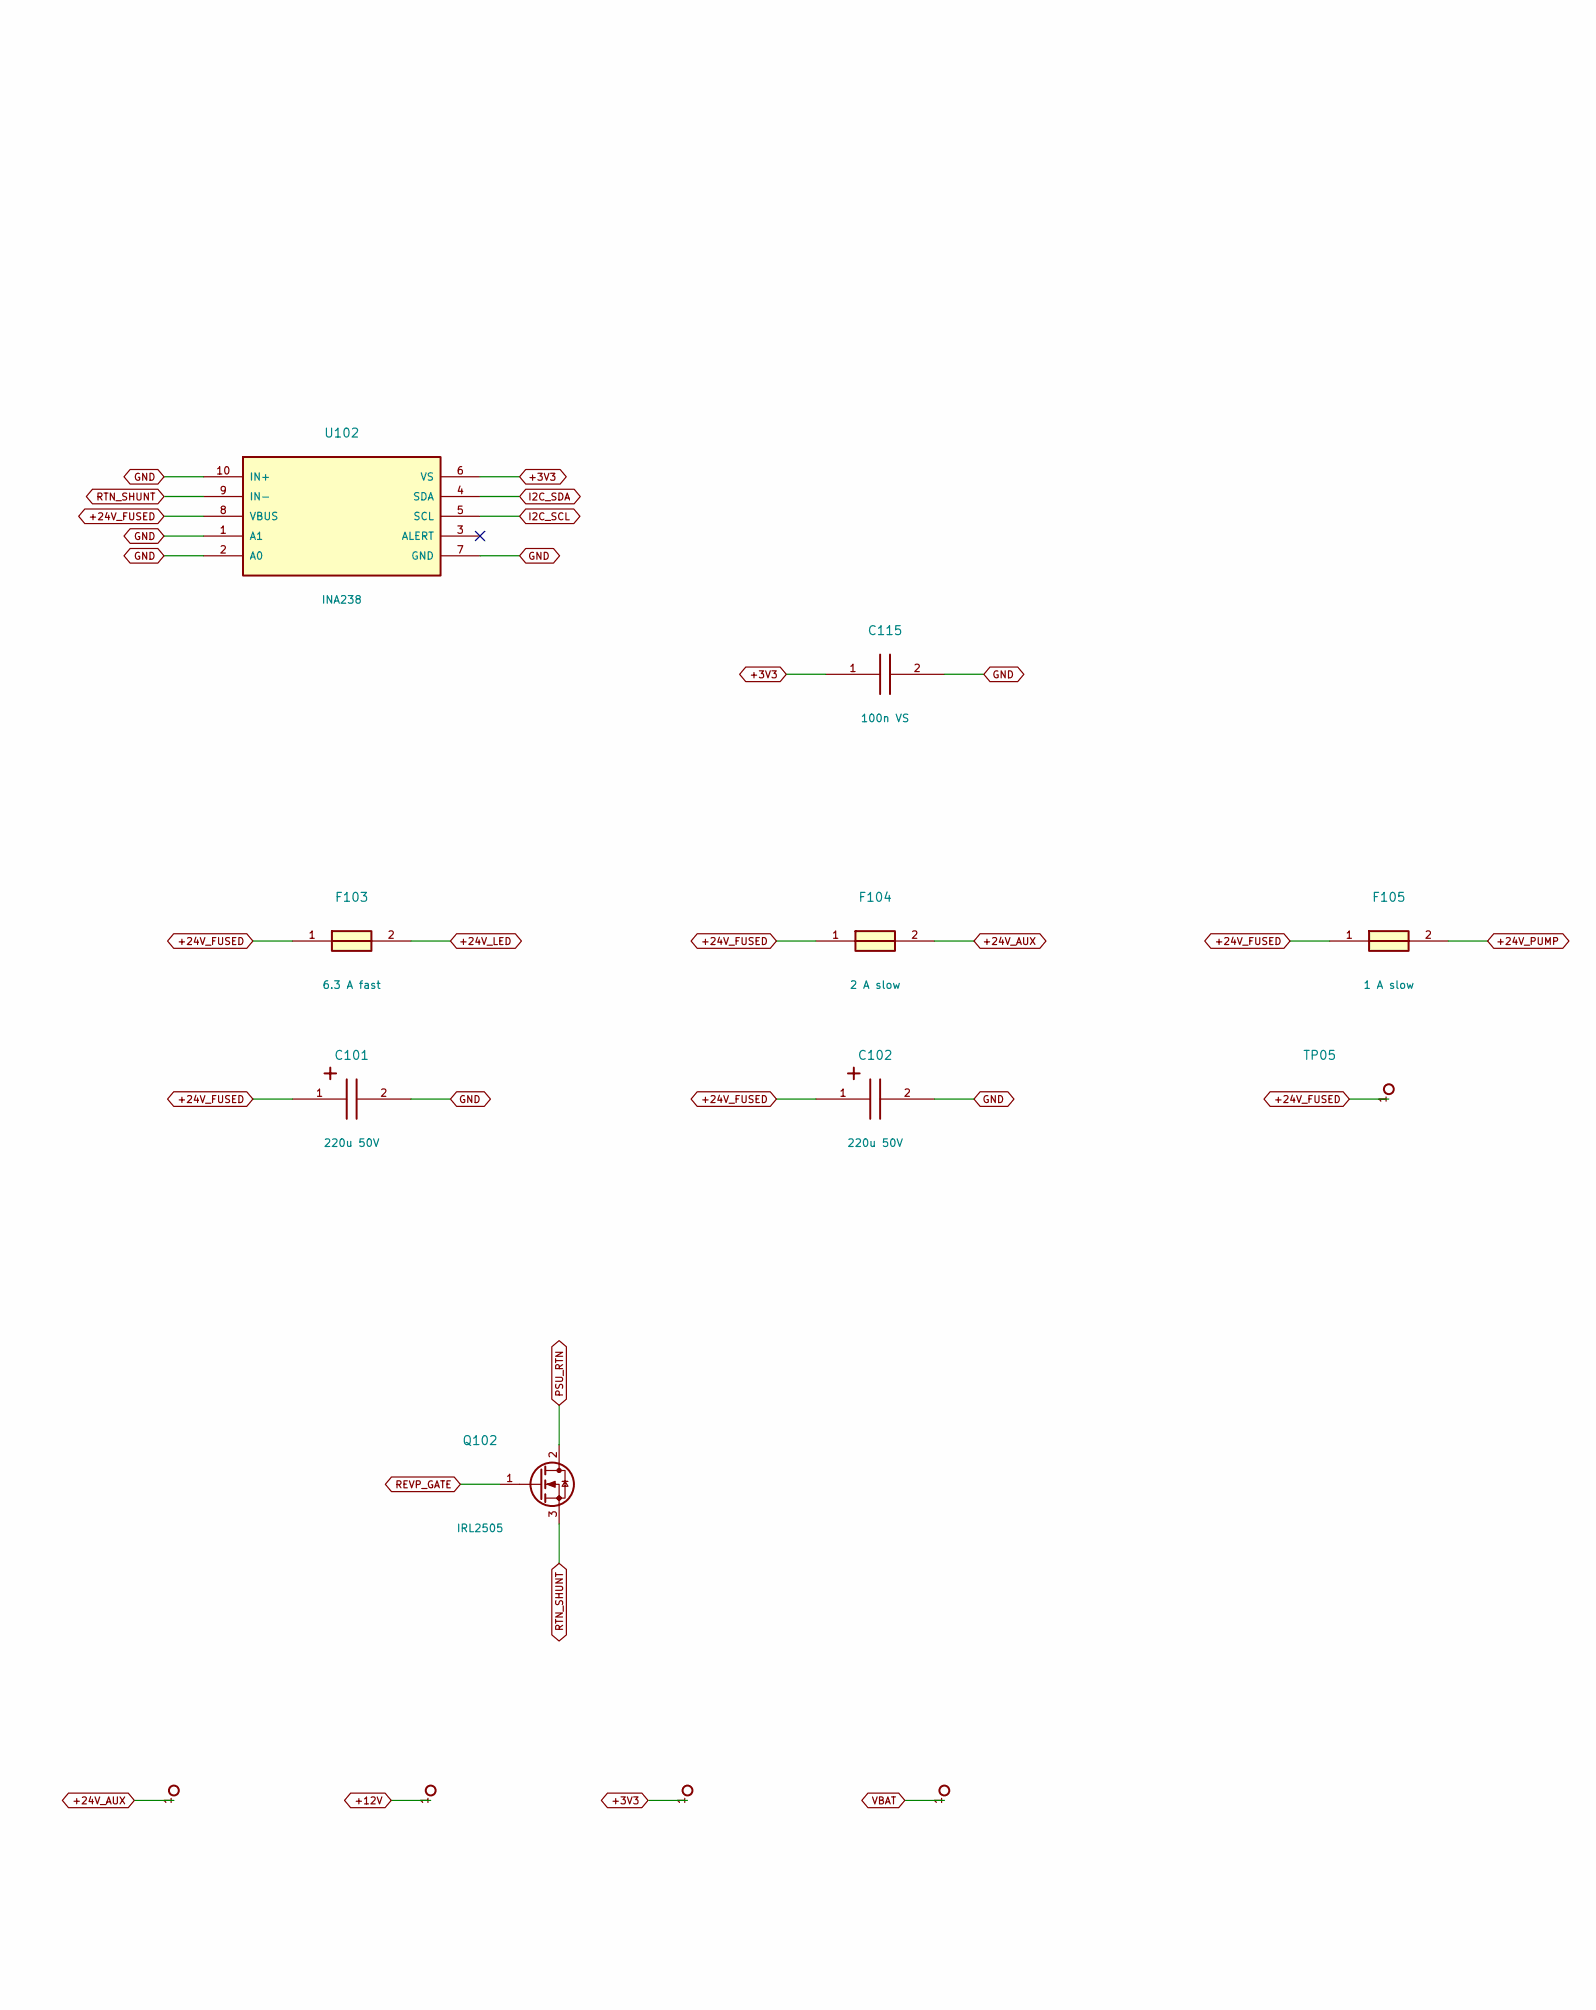
[picture p3: schematic InputPower.kicad_sch, 01 | 24 V input, reverse polarity, fuses and power monitor, part in row 1, column 2]

Parts:
C101, C102: 220u 50V; CP_Radial_D10.0mm_P5.00mm; MPN UPW1H221MPD
C115: 100n VS; C_0603_1608Metric; MPN CL10B104KB8NNNC
D101: SMBJ26A; D_SMB; MPN SMBJ26A-E3/52
D103: BZV55C12 12 V; D_MiniMELF; MPN BZV55C12
F101: 15 A slow; Fuse_Schurter_UST_USI1206_Reflow; MPN 3413.0330.11
F102: 8 A slow; Fuse_Schurter_UST_USI1206_Reflow; MPN 3413.0327.11
F103: 6.3 A fast; Fuse_Schurter_UST_USI1206_Reflow; MPN 3413.0224.11
F104: 2 A slow; Fuse_Schurter_UMT250; MPN 3403.0169.11
F105: 1 A slow; Fuse_Schurter_UMT250; MPN 3403.0166.11
J101: 24 V IN; TerminalBlock_Phoenix_MKDS-1,5-2_1x02_P5.00mm_Horizontal; MPN KF301-5.0-2P
Q102: IRL2505; TO-220-3_Vertical; MPN IRL2505
R108: 10k 1206; R_1206_3216Metric; MPN SMD1206-10K-1%
R111, R112: 7m 1% 1W; R_1206_3216Metric; MPN MSMA1206R0070FCM
TP05: +24V_FUSED; TestPoint_Pad_D1.0mm
U102: INA238; VSSOP-10_3x3mm_P0.5mm; MPN INA238AIDGSR

Connections:
+3V3: C115.1, U102.6 (VS); also elsewhere on the board
+24V_AUX: F104.2; also elsewhere on the board
+24V_FUSED: C101.1, C102.1, D101.1 (K), F101.2, F102.1, F103.1, F104.1, F105.1, R108.1, TP05.1, U102.8 (VBUS)
+24V_LED: F103.2; also elsewhere on the board
+24V_PTC: F102.2; also elsewhere on the board
+24V_PUMP: F105.2; also elsewhere on the board
+24V_RAW: F101.1, J101.1
GND: C101.2, C102.2, C115.2, D101.2 (A), D103.2 (A), R111.1, R112.1, U102.1 (A1), U102.2 (A0), U102.7 (GND), U102.10 (IN+); also elsewhere on the board
I2C_SCL: U102.5 (SCL); also elsewhere on the board
I2C_SDA: U102.4 (SDA); also elsewhere on the board
PSU_RTN: J101.2, Q102.2 (D)
REVP_GATE: D103.1 (K), Q102.1 (G), R108.2
RTN_SHUNT: Q102.3 (S), R111.2, R112.2, U102.9 (IN-)

Notes on the sheet:
01 | 24 V input, reverse polarity, fuses and power monitor
External PSU 24.0 V, max 25 V, at least 240 W / 10 A. J101: 1 = +24 V, 2 = PSU return. Reverse polarity: Q102 IRL2505 (stock) in the return path; drain = J101.2, source = RTN_SHUNT. Gate from +24V_FUSED through R108 10k, clamped by D103 12 V (IRL2505 Vgs max 16 V): Vgs ~11.7 V at 21.6 V, 12 V at th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

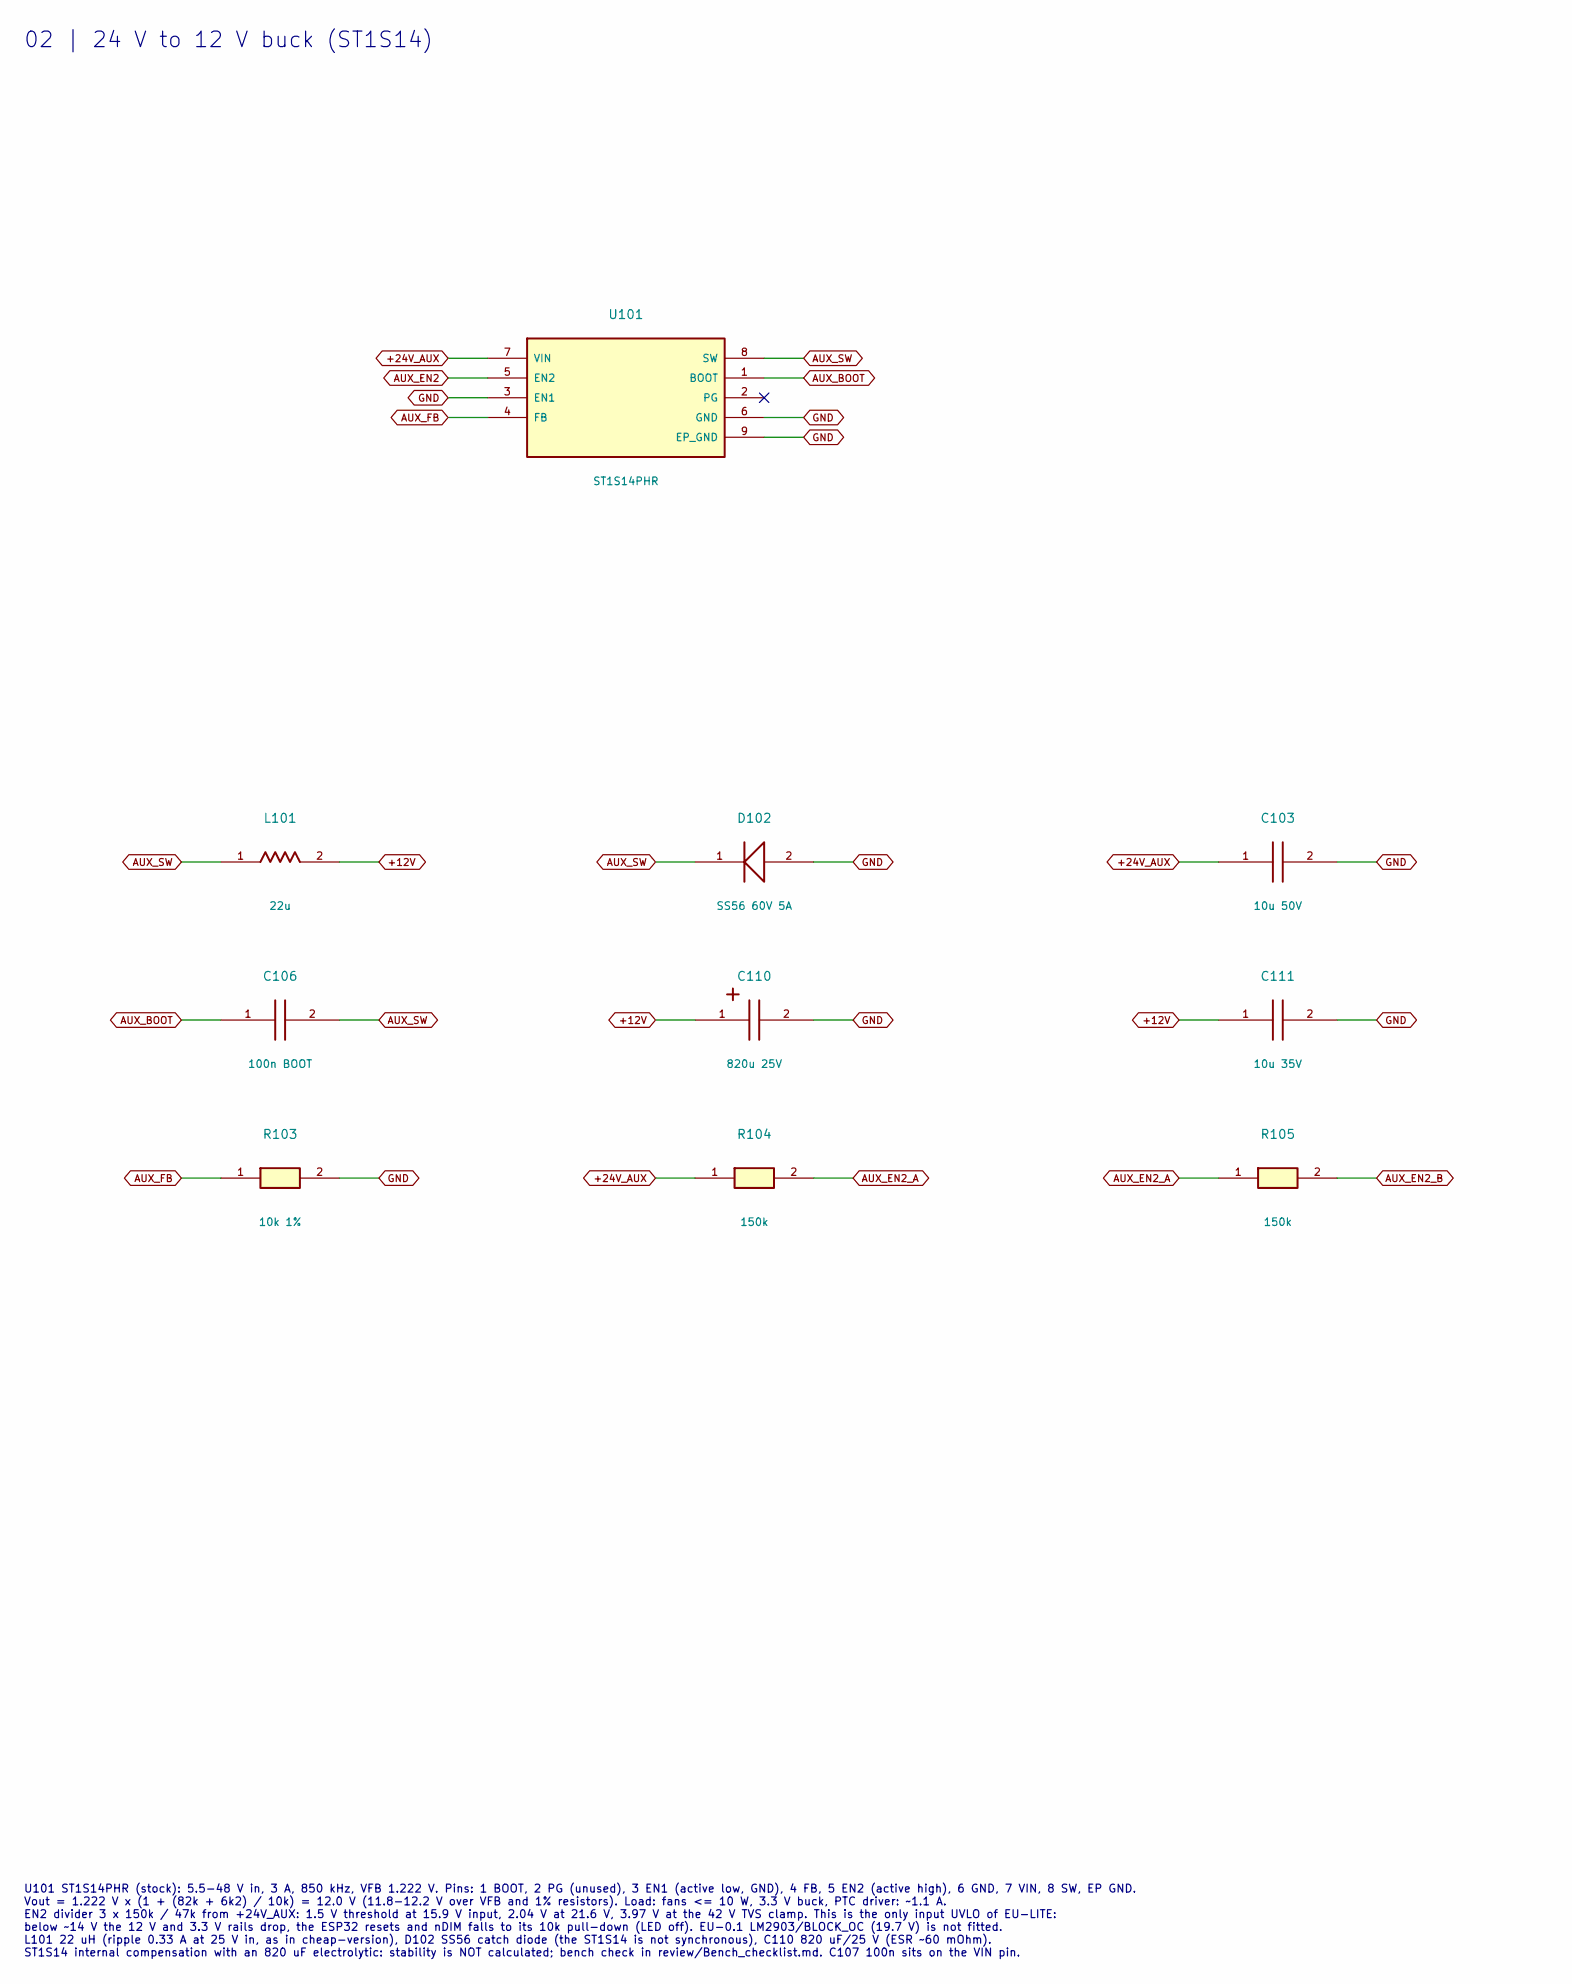
[picture p4: schematic Aux12V.kicad_sch, 02 | 24 V to 12 V buck (ST1S14), part in row 1, column 1]

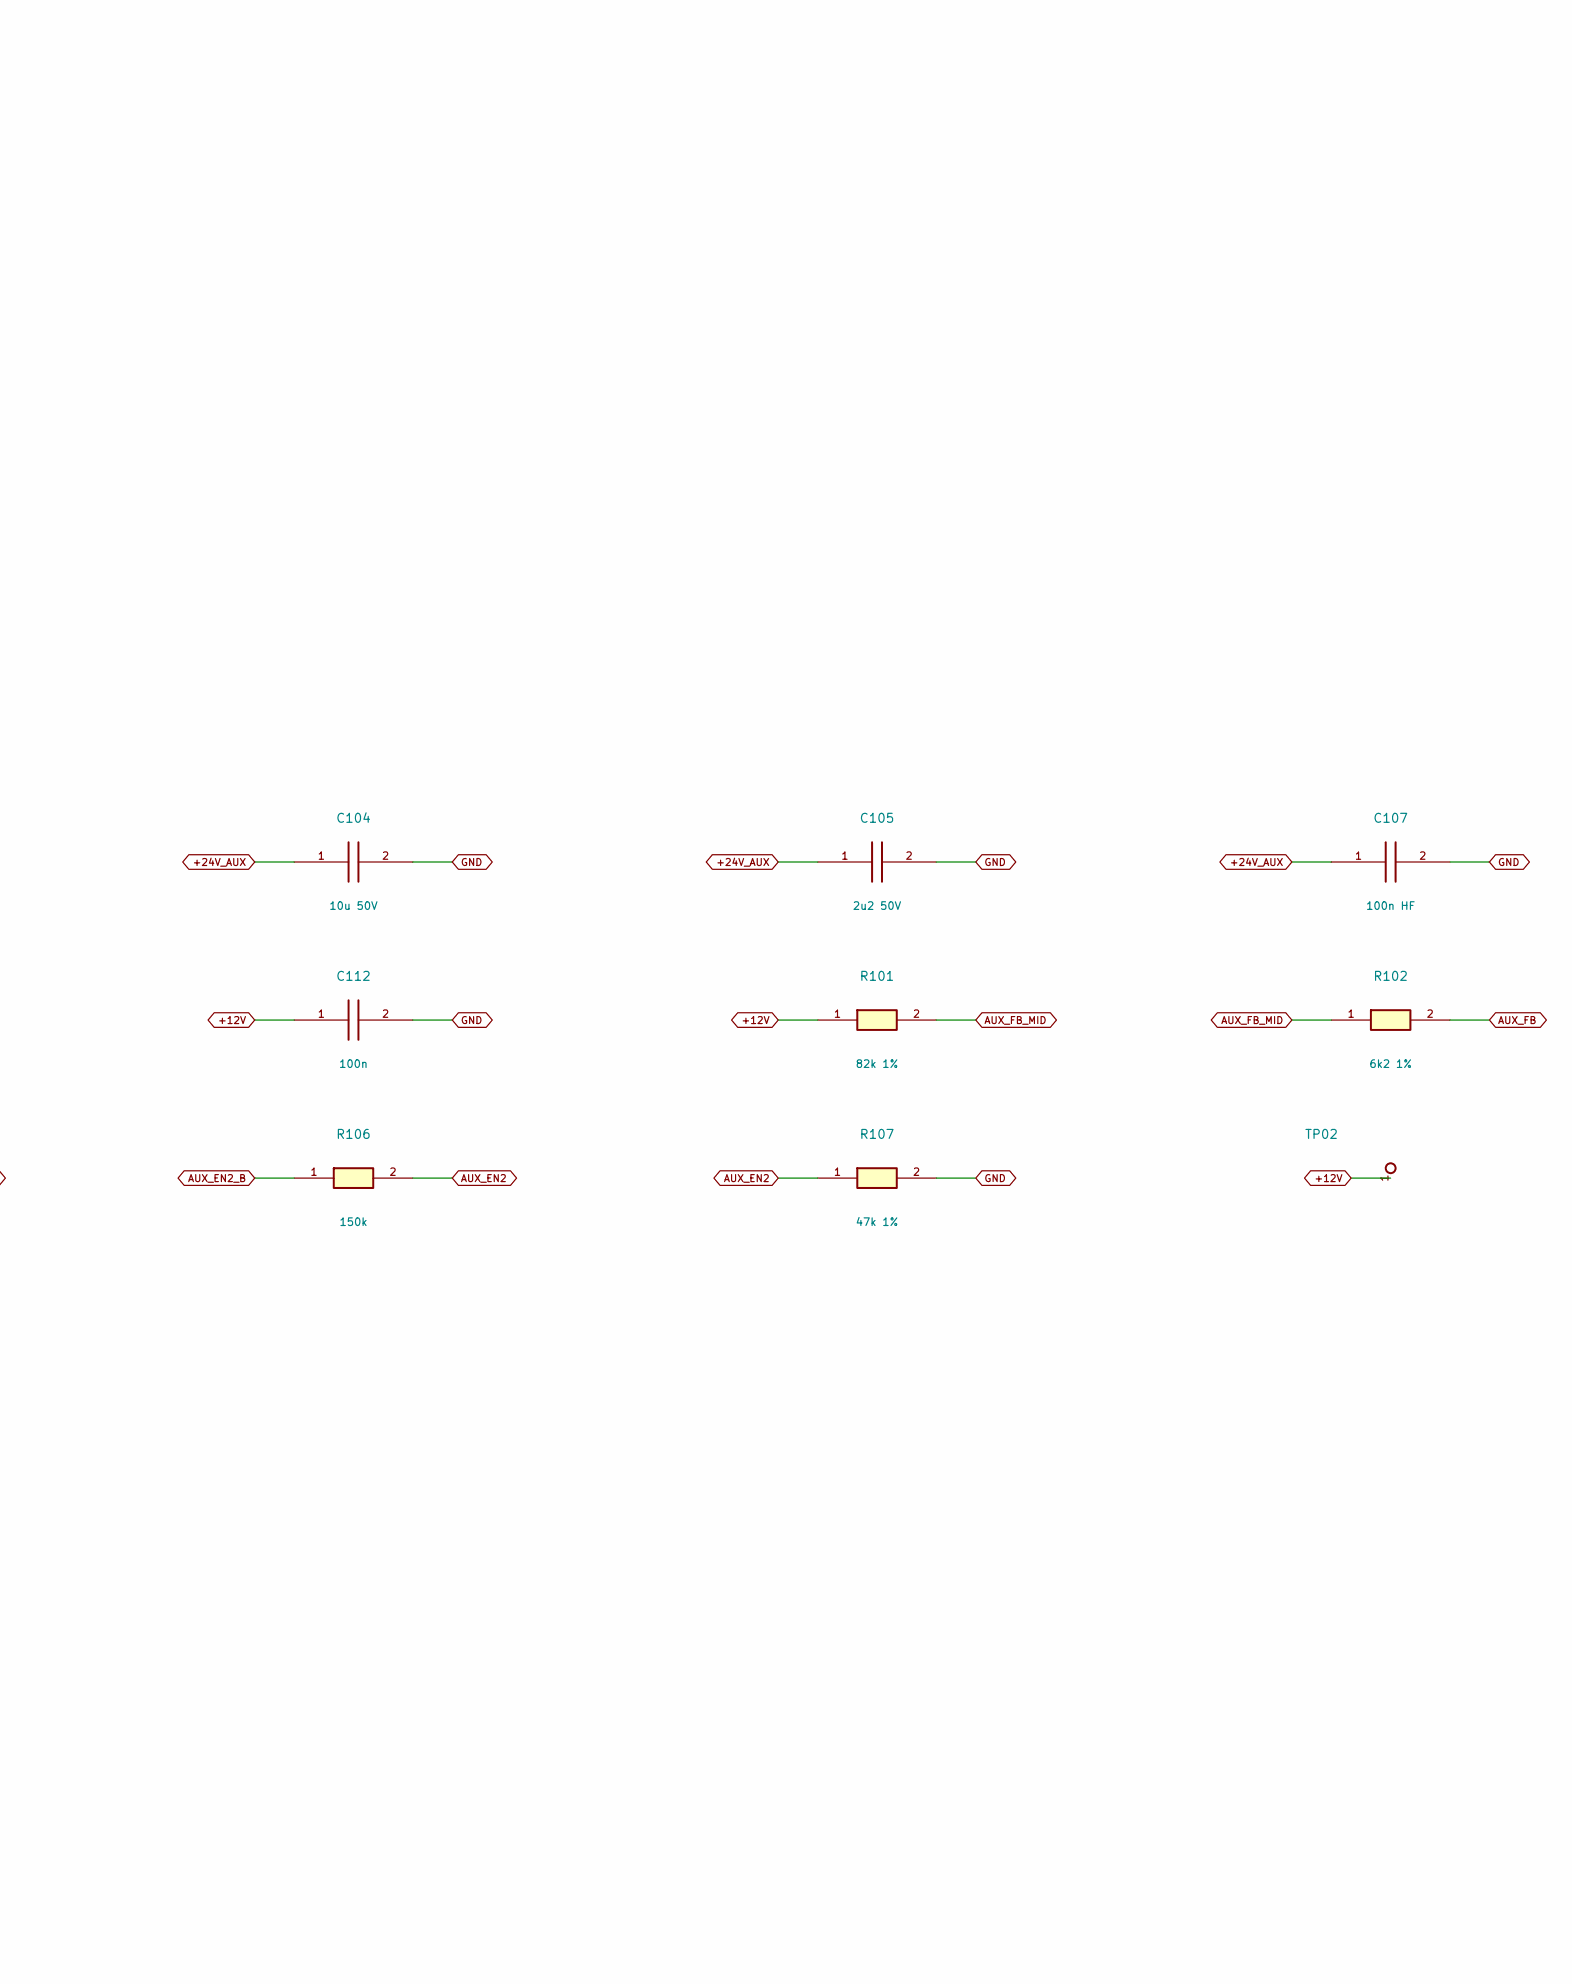
[picture p5: schematic Aux12V.kicad_sch, 02 | 24 V to 12 V buck (ST1S14), part in row 1, column 2]

Parts:
C103, C104: 10u 50V; C_1210_3225Metric; MPN CL32B106KBJNNNE
C105: 2u2 50V; C_1206_3216Metric; MPN 12065C225KATM-HW
C106: 100n BOOT; C_0603_1608Metric; MPN CL10B104KB8NNNC
C107: 100n HF; C_0603_1608Metric; MPN CL10B104KB8NNNC
C110: 820u 25V; CP_Elec_10x10.5; MPN EEEFT1E821AP
C111: 10u 35V; C_1210_3225Metric; MPN CL32A106KLULNNE
C112: 100n; C_0603_1608Metric; MPN CL10B104KB8NNNC
D102: SS56 60V 5A; D_SMC; MPN SS56
L101: 22u; L_Jantek_JNRH1207; MPN JNRH1207-220M-A
R101: 82k 1%; R_1206_3216Metric; MPN CRCW120682K0FKTABC
R102: 6k2 1%; R_1206_3216Metric; MPN SMD1206-6K2-1%
R103: 10k 1%; R_0805_2012Metric; MPN Резистор SMD 10 кОм, ±1%
R104, R105, R106: 150k; R_0805_2012Metric; MPN Резистор SMD 150 кОм, ±5%
R107: 47k 1%; R_1206_3216Metric; MPN Резистор SMD 47 кОм, ±1%
TP02: +12V; TestPoint_Pad_D1.0mm
U101: ST1S14PHR; SOIC-8-1EP_3.9x4.9mm_P1.27mm_EP2.41x3.3mm; MPN ST1S14PHR

Connections:
+12V: C110.1, C111.1, C112.1, L101.2, R101.1, TP02.1; also elsewhere on the board
+24V_AUX: C103.1, C104.1, C105.1, C107.1, R104.1, U101.7 (VIN); also elsewhere on the board
AUX_BOOT: C106.1, U101.1 (BOOT)
AUX_EN2: R106.2, R107.1, U101.5 (EN2)
AUX_EN2_A: R104.2, R105.1
AUX_EN2_B: R105.2, R106.1
AUX_FB: R102.2, R103.1, U101.4 (FB)
AUX_FB_MID: R101.2, R102.1
AUX_SW: C106.2, D102.1 (K), L101.1, U101.8 (SW)
GND: C103.2, C104.2, C105.2, C107.2, C110.2, C111.2, C112.2, D102.2 (A), R103.2, R107.2, U101.3 (EN1), U101.6 (GND), U101.9 (EP_GND); also elsewhere on the board

Notes on the sheet:
02 | 24 V to 12 V buck (ST1S14)
U101 ST1S14PHR (stock): 5.5-48 V in, 3 A, 850 kHz, VFB 1.222 V. Pins: 1 BOOT, 2 PG (unused), 3 EN1 (active low, GND), 4 FB, 5 EN2 (active high), 6 GND, 7 VIN, 8 SW, EP GND. Vout = 1.222 V x (1 + (82k + 6k2) / 10k) = 12.0 V (11.8-12.2 V over VFB and 1% resistors). Load: fans <= 10 W, 3.3 V buck, PTC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
