nikolajevs/MicroGarden_V1/hardware/PCB_EU_LITE/PCB_EU_LITE.kicad_pcb

## KiCad design hardware/PCB_EU_LITE/PCB_EU_LITE.kicad_pcb (continued)

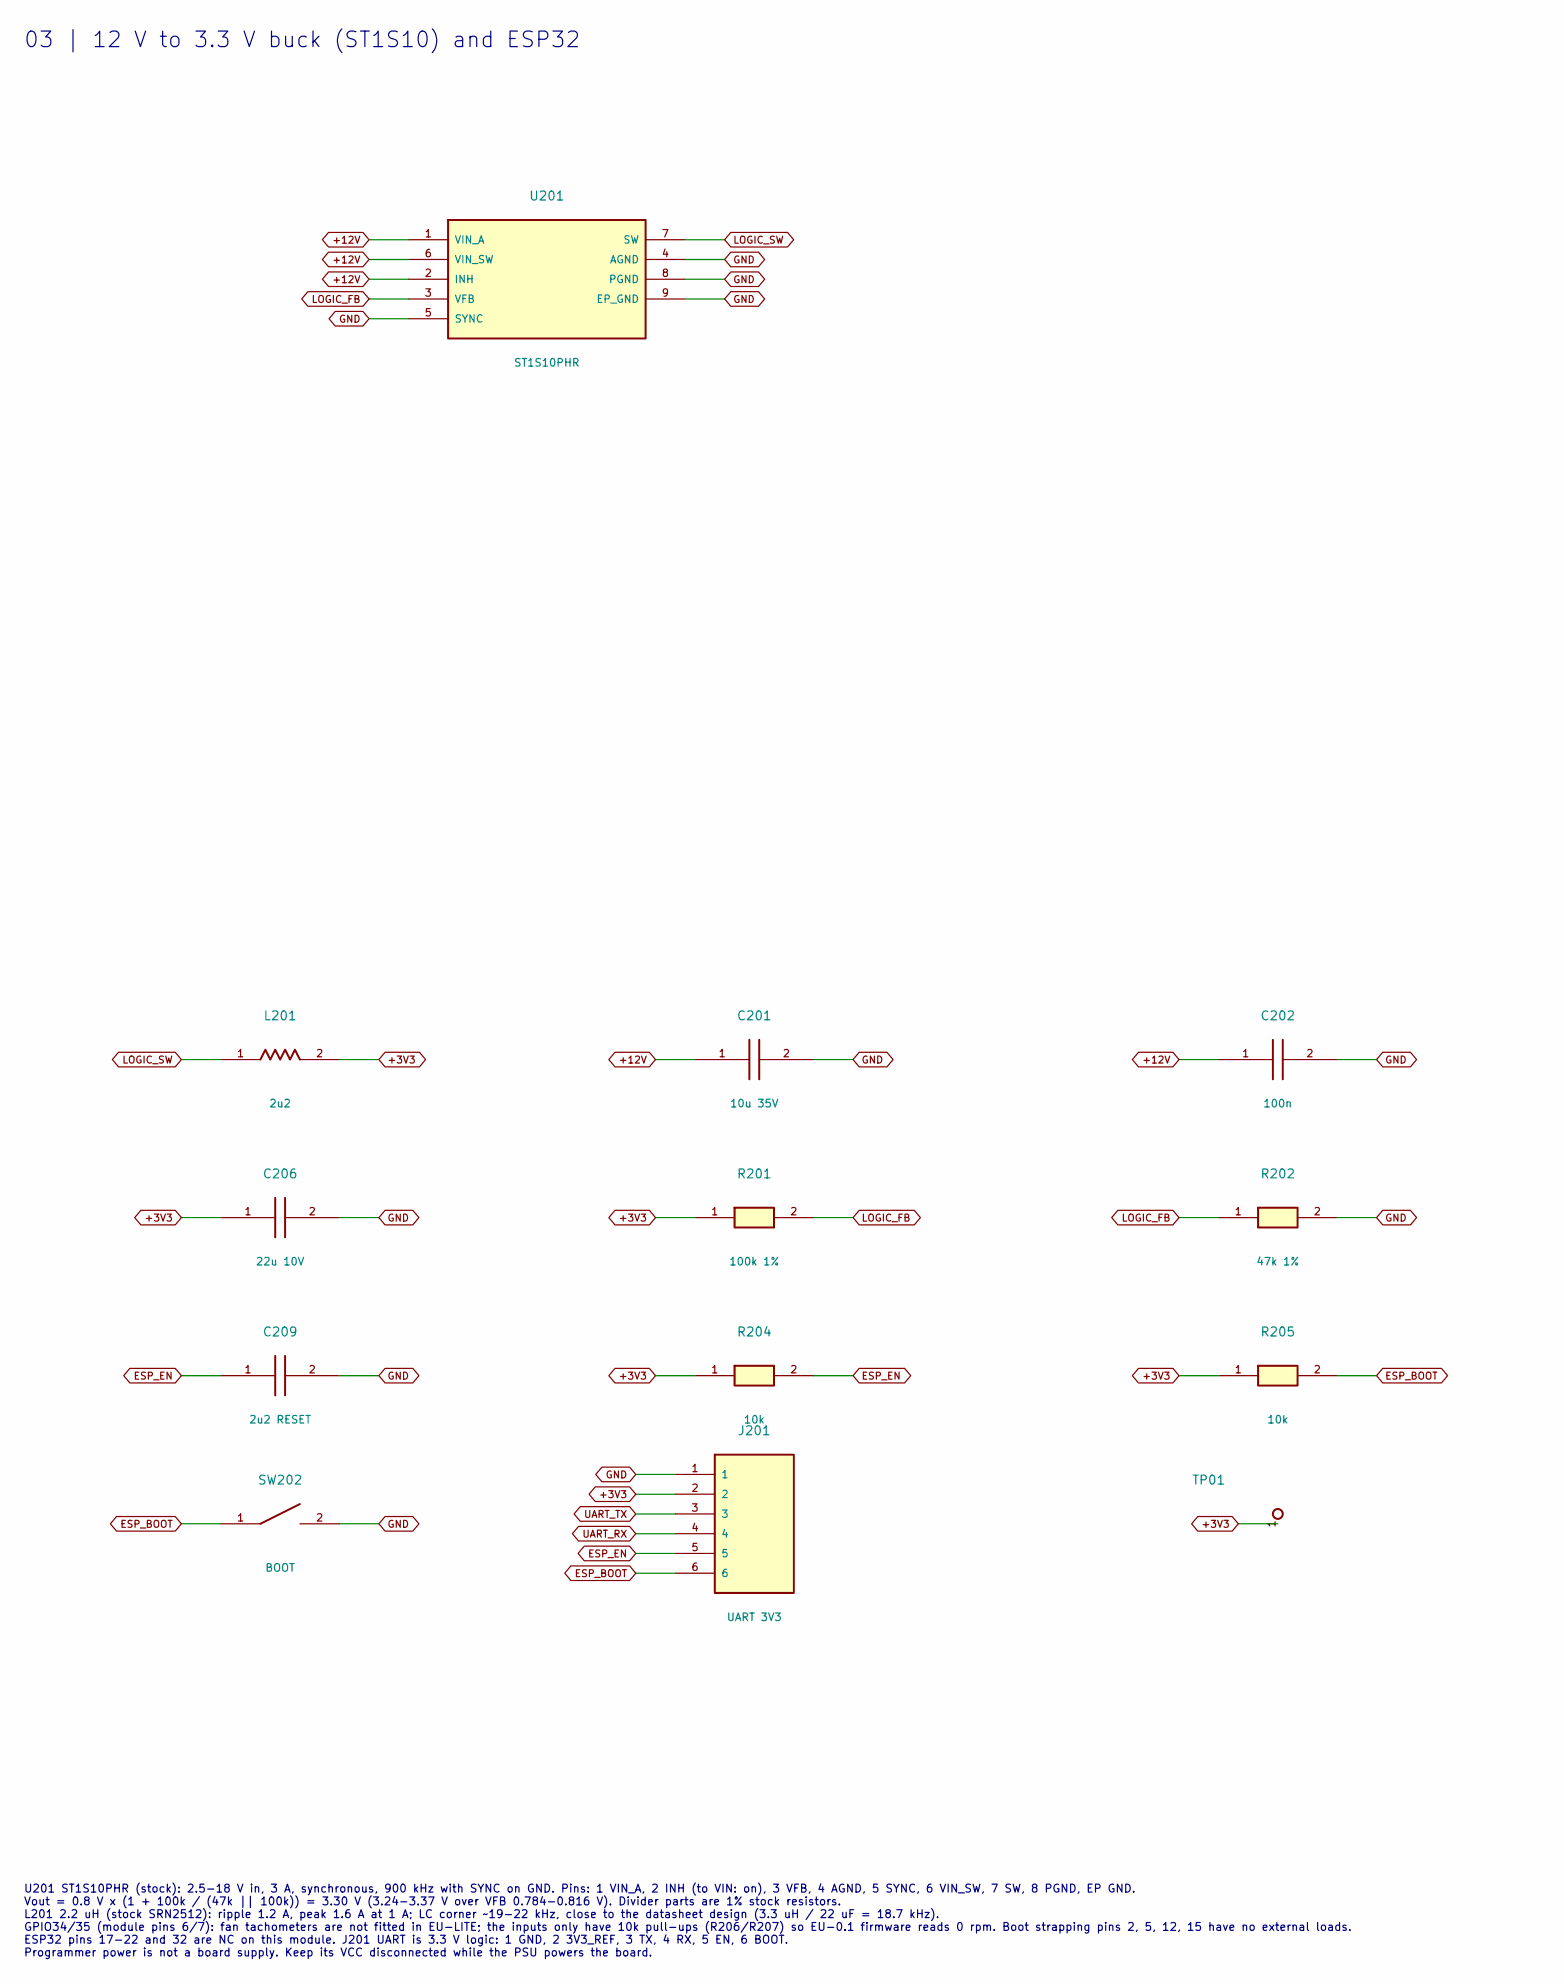
[picture p6: schematic MCU.kicad_sch, 03 | 12 V to 3.3 V buck (ST1S10) and ESP32, part in row 1, column 1]

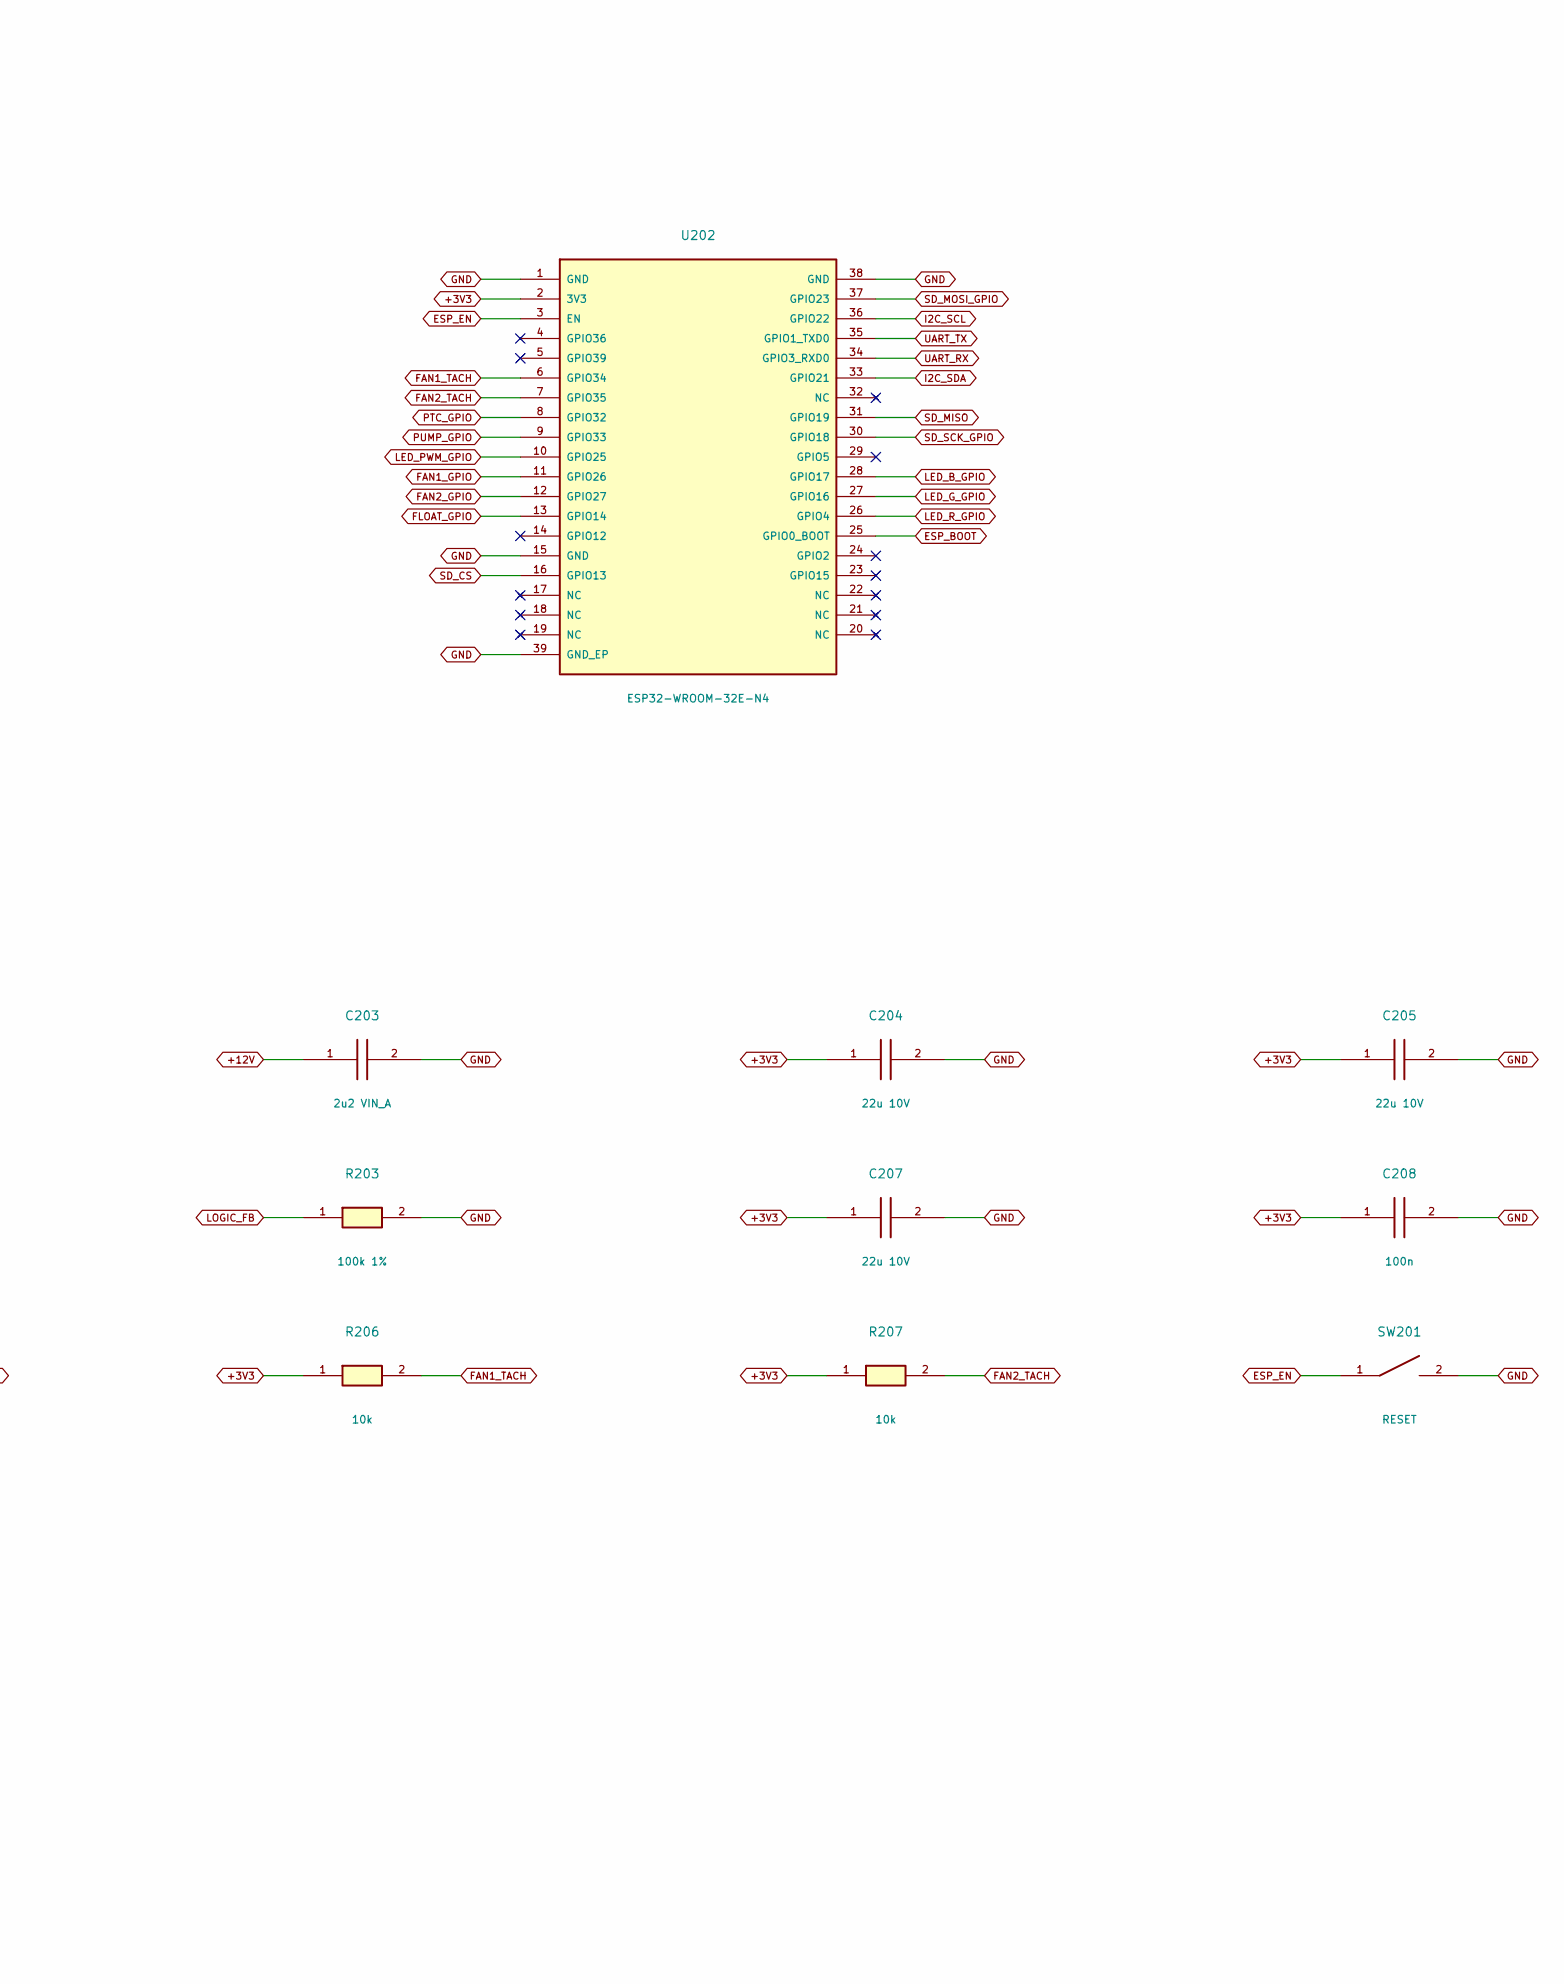
[picture p7: schematic MCU.kicad_sch, 03 | 12 V to 3.3 V buck (ST1S10) and ESP32, part in row 1, column 2]

Parts:
C201: 10u 35V; C_1210_3225Metric; MPN CL32A106KLULNNE
C202, C208: 100n; C_0603_1608Metric; MPN CL10B104KB8NNNC
C203: 2u2 VIN_A; C_0805_2012Metric; MPN CL21A225KOFNNNE
C204, C205, C206, C207: 22u 10V; C_0805_2012Metric; MPN CL21A226KPCLRNC
C209: 2u2 RESET; C_0805_2012Metric; MPN CL21A225KOFNNNE
J201: UART 3V3; PinHeader_1x06_P2.54mm_Vertical; MPN ZL201-10G
L201: 2u2; L_1008_2520Metric; MPN SRN2512-2R2M
R201, R203: 100k 1%; R_0603_1608Metric; MPN RC0603FR-07100KL
R202: 47k 1%; R_1206_3216Metric; MPN Резистор SMD 47 кОм, ±1%
R204, R205, R206, R207: 10k; R_0805_2012Metric; MPN Резистор SMD 10 кОм, ±5%
SW201: RESET; SW_PUSH_6mm_H9.5mm; MPN 6X6X10MM Tact Switch
SW202: BOOT; SW_PUSH_6mm_H9.5mm; MPN 6X6X10MM Tact Switch
TP01: +3V3; TestPoint_Pad_D1.0mm
U201: ST1S10PHR; SOIC-8-1EP_3.9x4.9mm_P1.27mm_EP2.41x3.3mm; MPN ST1S10PHR
U202: ESP32-WROOM-32E-N4; ESP32-WROOM-32E_NoVias; MPN ESP32-WROOM-32E-N4

Connections:
+3V3: C204.1, C205.1, C206.1, C207.1, C208.1, J201.2, L201.2, R201.1, R204.1, R205.1, R206.1, R207.1, TP01.1, U202.2 (3V3); also elsewhere on the board
+12V: C201.1, C202.1, C203.1, U201.1 (VIN_A), U201.2 (INH), U201.6 (VIN_SW); also elsewhere on the board
ESP_BOOT: J201.6, R205.2, SW202.1, U202.25 (GPIO0_BOOT)
ESP_EN: C209.1, J201.5, R204.2, SW201.1, U202.3 (EN)
FAN1_GPIO: U202.11 (GPIO26); also elsewhere on the board
FAN1_TACH: R206.2, U202.6 (GPIO34)
FAN2_GPIO: U202.12 (GPIO27); also elsewhere on the board
FAN2_TACH: R207.2, U202.7 (GPIO35)
FLOAT_GPIO: U202.13 (GPIO14); also elsewhere on the board
GND: C201.2, C202.2, C203.2, C204.2, C205.2, C206.2, C207.2, C208.2, C209.2, J201.1, R202.2, R203.2, SW201.2, SW202.2, U201.4 (AGND), U201.5 (SYNC), U201.8 (PGND), U201.9 (EP_GND), U202.1 (GND), U202.15 (GND), U202.38 (GND), U202.39 (GND_EP); also elsewhere on the board
I2C_SCL: U202.36 (GPIO22); also elsewhere on the board
I2C_SDA: U202.33 (GPIO21); also elsewhere on the board
LED_B_GPIO: U202.28 (GPIO17); also elsewhere on the board
LED_G_GPIO: U202.27 (GPIO16); also elsewhere on the board
LED_PWM_GPIO: U202.10 (GPIO25); also elsewhere on the board
LED_R_GPIO: U202.26 (GPIO4); also elsewhere on the board
LOGIC_FB: R201.2, R202.1, R203.1, U201.3 (VFB)
LOGIC_SW: L201.1, U201.7 (SW)
PTC_GPIO: U202.8 (GPIO32); also elsewhere on the board
PUMP_GPIO: U202.9 (GPIO33); also elsewhere on the board
SD_CS: U202.16 (GPIO13); also elsewhere on the board
SD_MISO: U202.31 (GPIO19); also elsewhere on the board
SD_MOSI_GPIO: U202.37 (GPIO23); also elsewhere on the board
SD_SCK_GPIO: U202.30 (GPIO18); also elsewhere on the board
UART_RX: J201.4, U202.34 (GPIO3_RXD0)
UART_TX: J201.3, U202.35 (GPIO1_TXD0)

Notes on the sheet:
03 | 12 V to 3.3 V buck (ST1S10) and ESP32
U201 ST1S10PHR (stock): 2.5-18 V in, 3 A, synchronous, 900 kHz with SYNC on GND. Pins: 1 VIN_A, 2 INH (to VIN: on), 3 VFB, 4 AGND, 5 SYNC, 6 VIN_SW, 7 SW, 8 PGND, EP GND. Vout = 0.8 V x (1 + 100k / (47k || 100k)) = 3.30 V (3.24-3.37 V over VFB 0.784-0.816 V). Divider parts are 1% stock resistors. L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

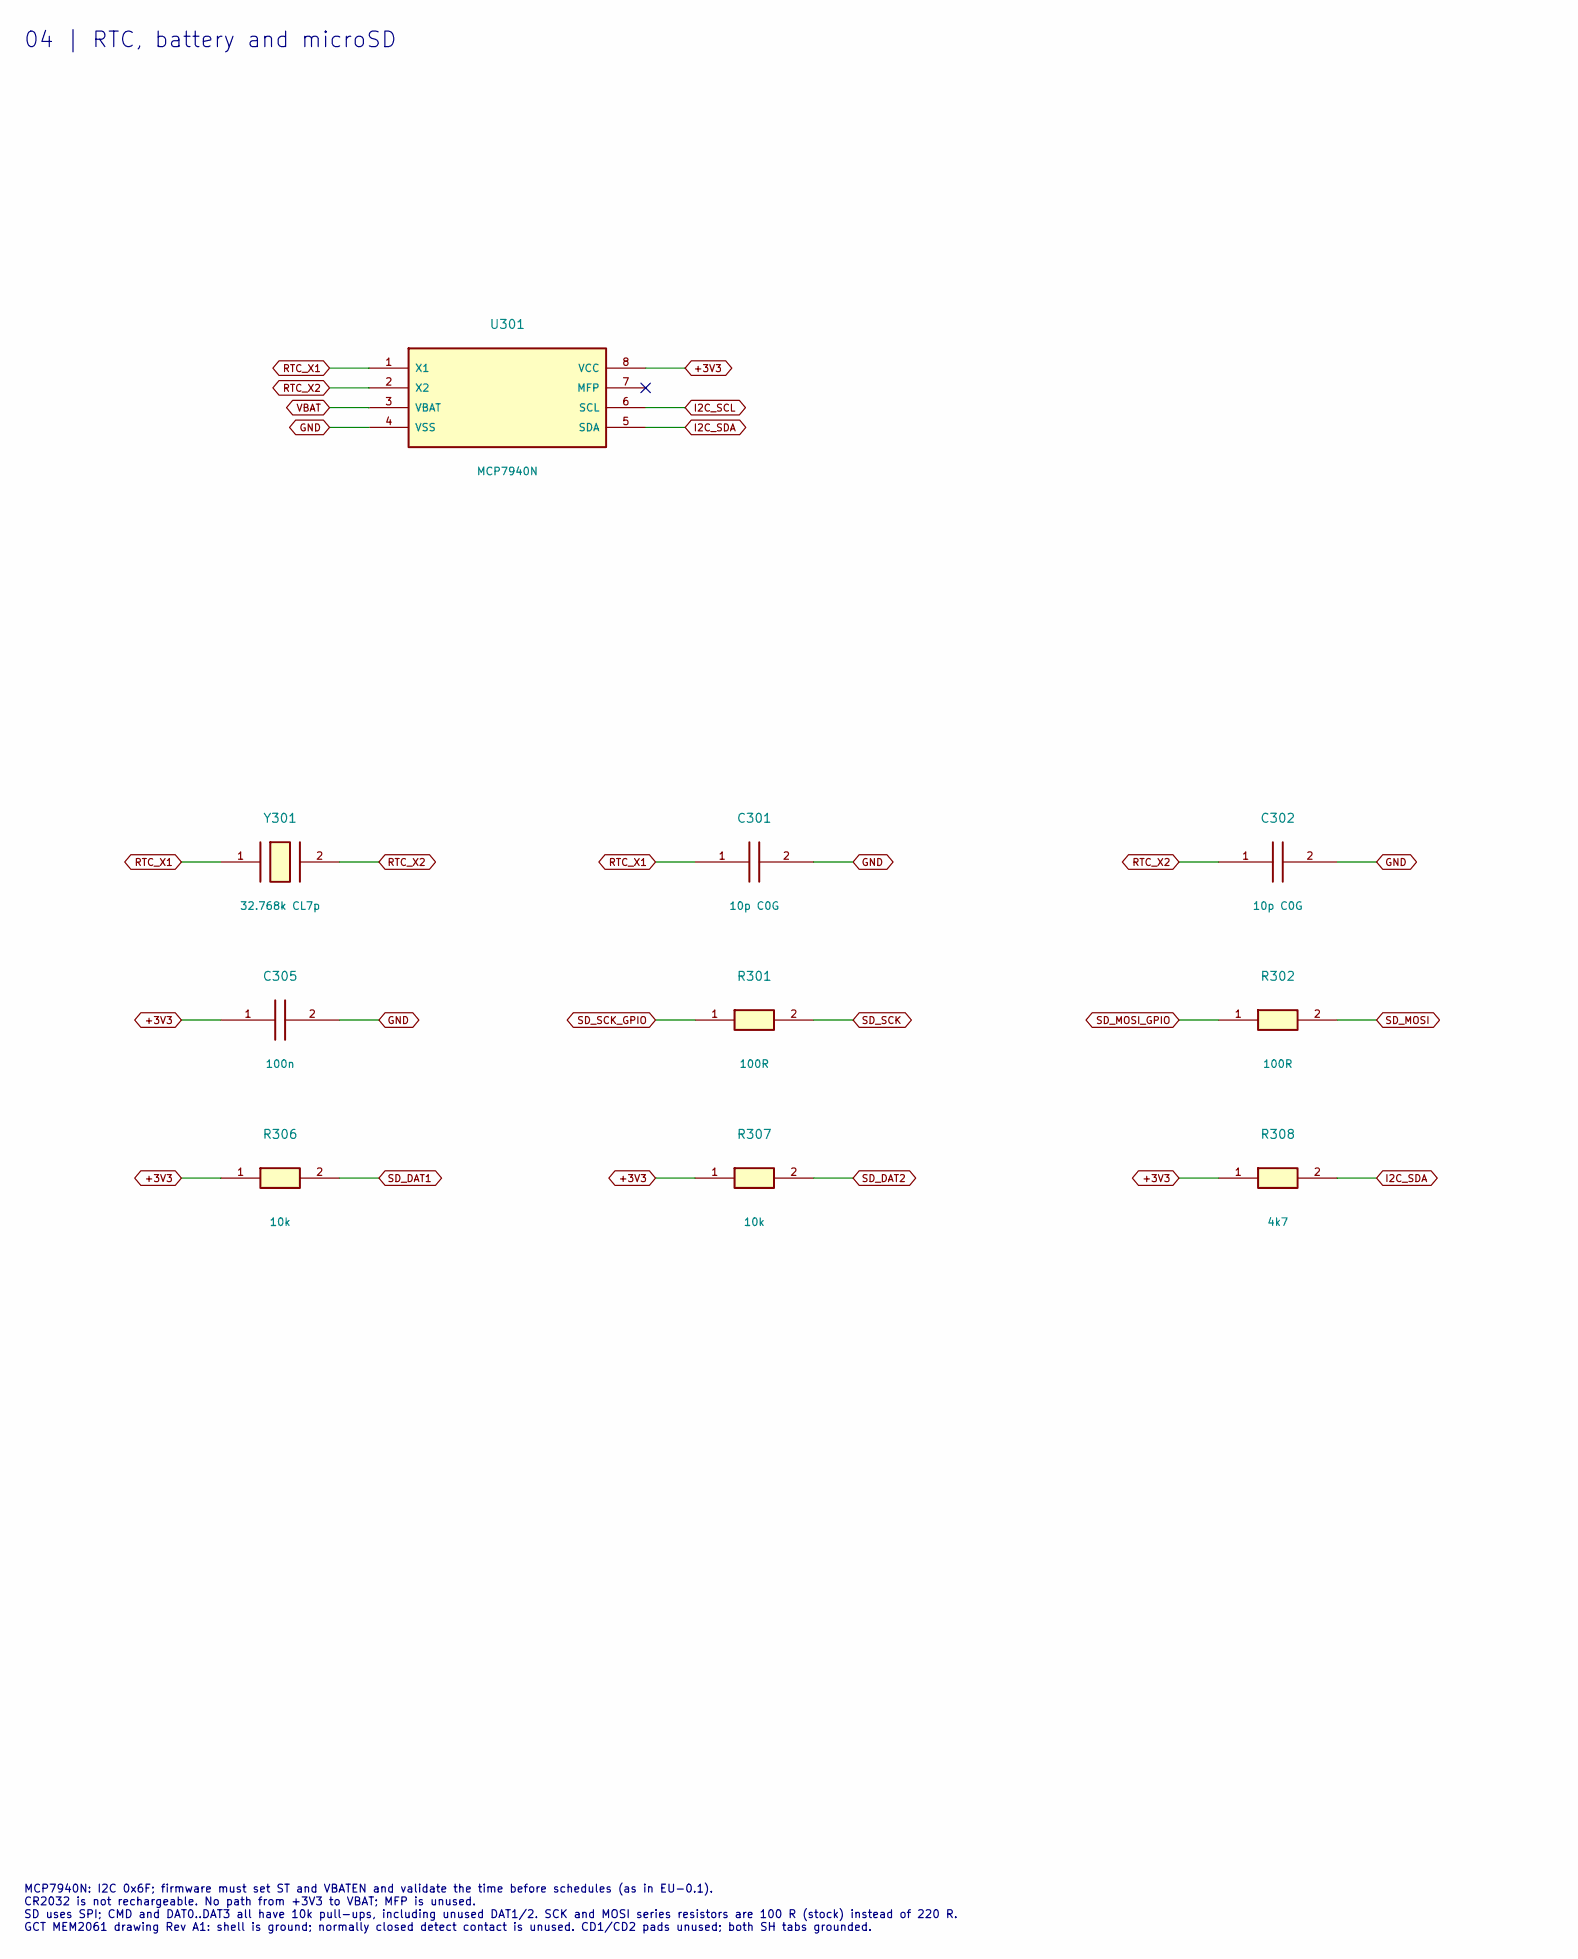
[picture p8: schematic Peripherals.kicad_sch, 04 | RTC, battery and microSD, part in row 1, column 1]

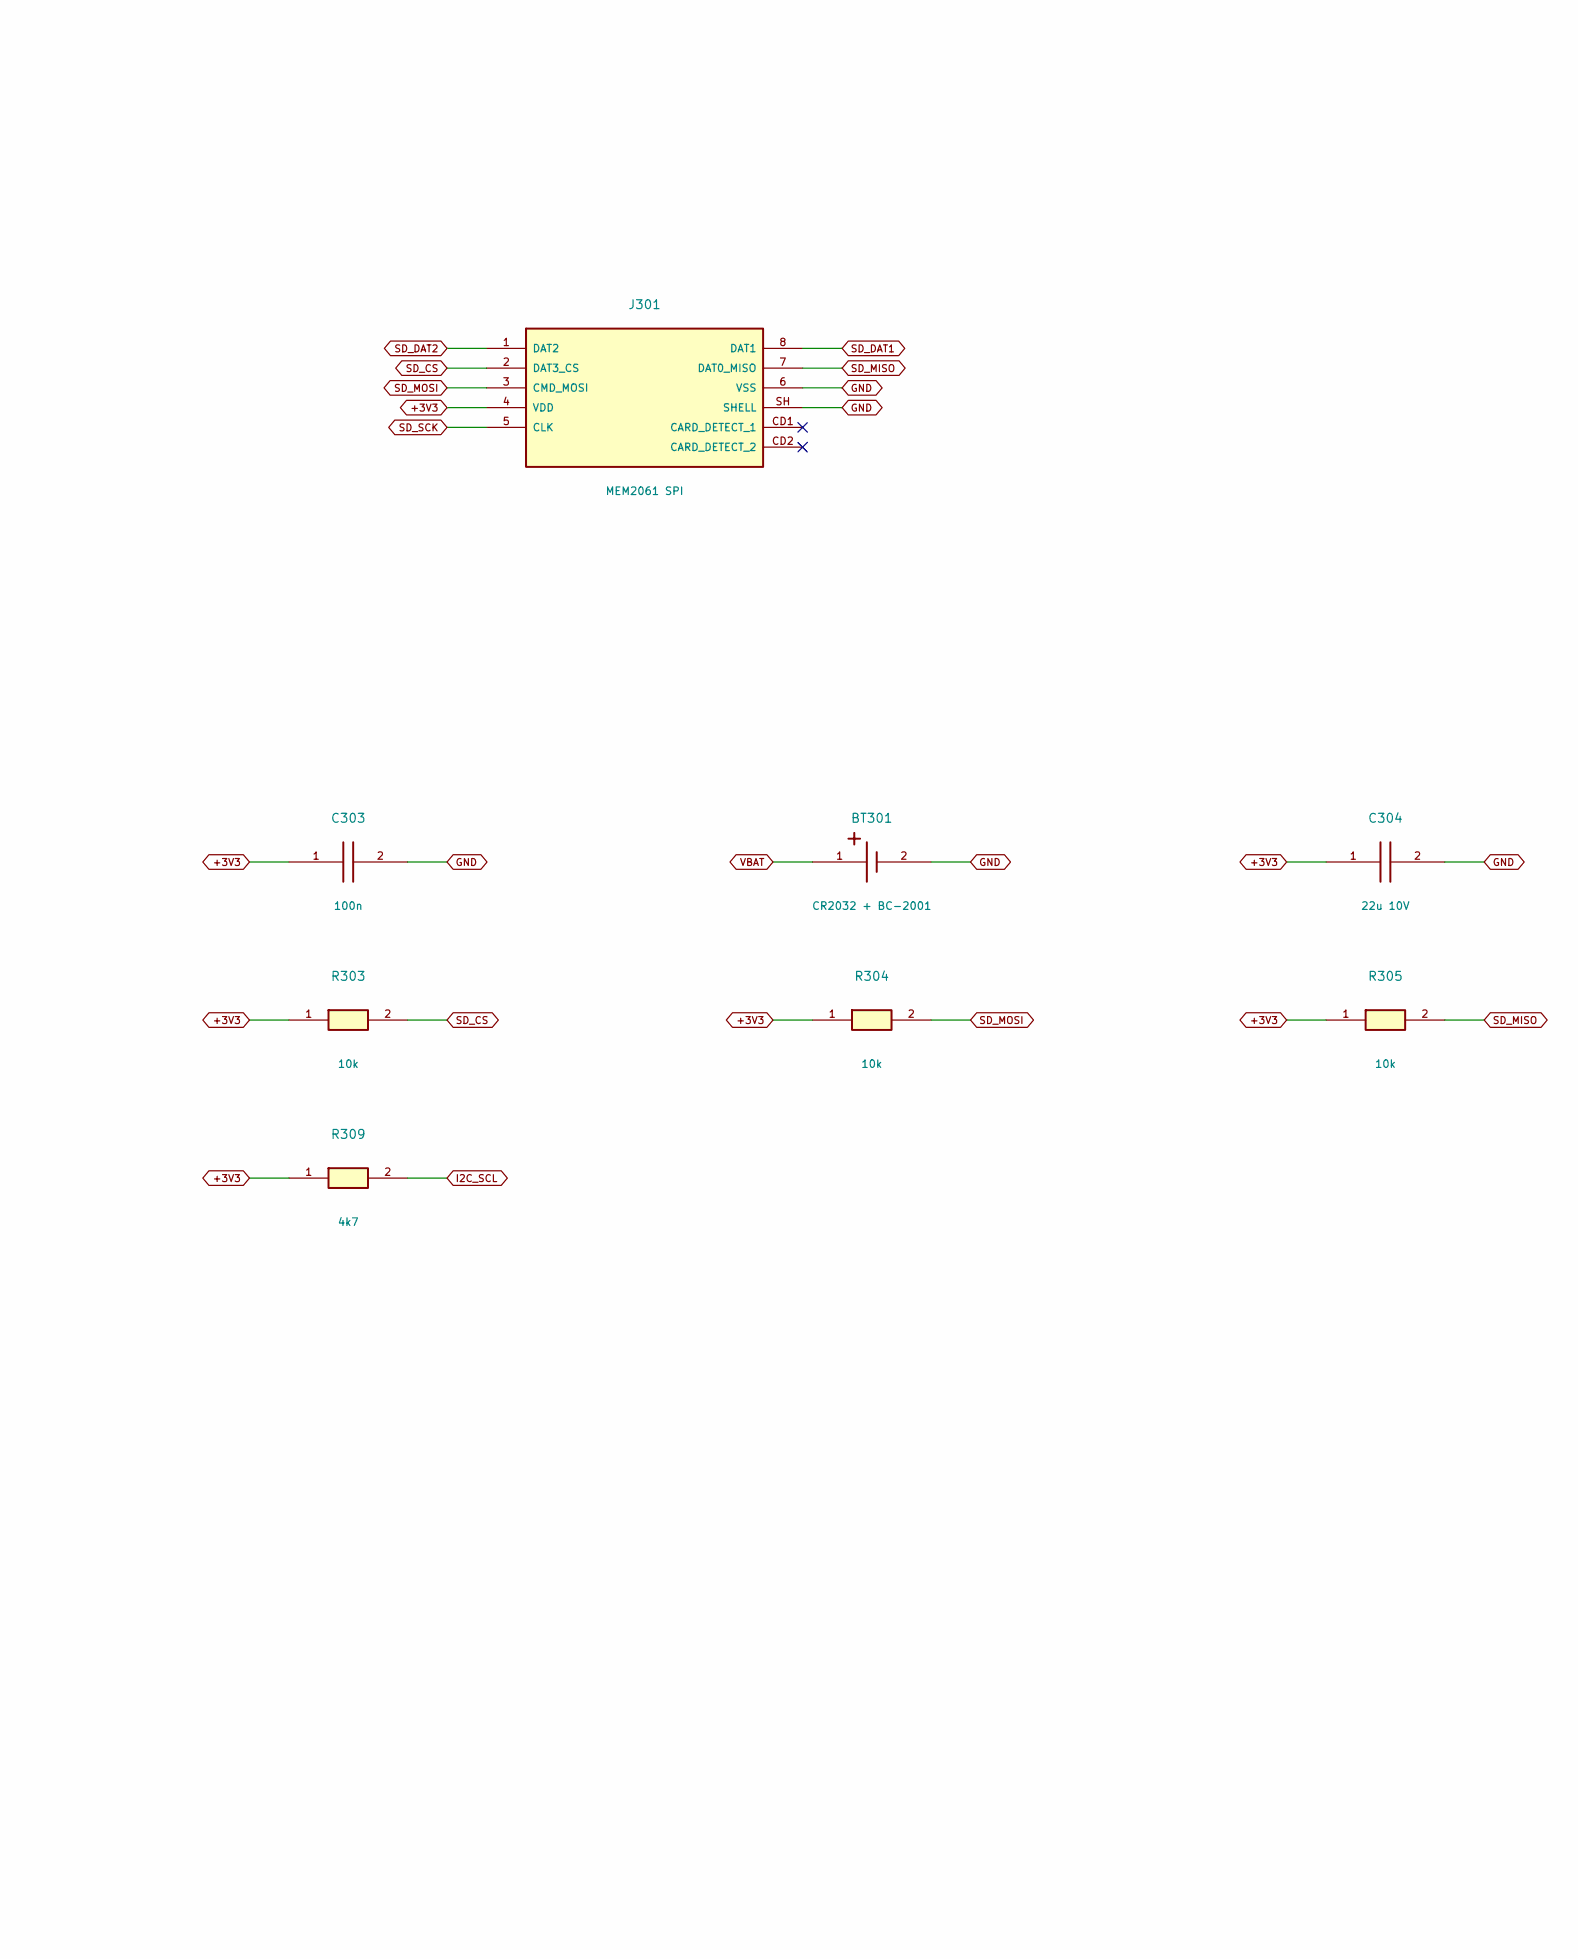
[picture p9: schematic Peripherals.kicad_sch, 04 | RTC, battery and microSD, part in row 1, column 2]

Parts:
BT301: CR2032 + BC-2001; Battery_COMF_BC-2001; MPN BC-2001
C301, C302: 10p C0G; C_1206_3216Metric; MPN C1206C100J5GACTU
C303, C305: 100n; C_0603_1608Metric; MPN CL10B104KB8NNNC
C304: 22u 10V; C_0805_2012Metric; MPN CL21A226KPCLRNC
J301: MEM2061 SPI; microSD_GCT_MEM2061-01-188-00-A; MPN MEM2061-01-188-00-A
R301, R302: 100R; R_0805_2012Metric; MPN Резистор SMD 100 Ом, ±5%
R303, R304, R305, R306, R307: 10k; R_0805_2012Metric; MPN Резистор SMD 10 кОм, ±5%
R308, R309: 4k7; R_0805_2012Metric; MPN Резистор SMD 4,7 кОм, ±5%
U301: MCP7940N; SOIC-8_3.9x4.9mm_P1.27mm; MPN MCP7940N-I/SN
Y301: 32.768k CL7p; Crystal_Abracon_ABS07; MPN ABS07-32.768KHZ-7-T

Connections:
+3V3: C303.1, C304.1, C305.1, J301.4 (VDD), R303.1, R304.1, R305.1, R306.1, R307.1, R308.1, R309.1, U301.8 (VCC); also elsewhere on the board
GND: BT301.2, C301.2, C302.2, C303.2, C304.2, C305.2, J301.6 (VSS), J301.SH (SHELL), U301.4 (VSS); also elsewhere on the board
I2C_SCL: R309.2, U301.6 (SCL); also elsewhere on the board
I2C_SDA: R308.2, U301.5 (SDA); also elsewhere on the board
RTC_X1: C301.1, U301.1 (X1), Y301.1
RTC_X2: C302.1, U301.2 (X2), Y301.2
SD_CS: J301.2 (DAT3_CS), R303.2; also elsewhere on the board
SD_DAT1: J301.8 (DAT1), R306.2
SD_DAT2: J301.1 (DAT2), R307.2
SD_MISO: J301.7 (DAT0_MISO), R305.2; also elsewhere on the board
SD_MOSI: J301.3 (CMD_MOSI), R302.2, R304.2
SD_MOSI_GPIO: R302.1; also elsewhere on the board
SD_SCK: J301.5 (CLK), R301.2
SD_SCK_GPIO: R301.1; also elsewhere on the board
VBAT: BT301.1, U301.3 (VBAT)

Notes on the sheet:
04 | RTC, battery and microSD
MCP7940N: I2C 0x6F; firmware must set ST and VBATEN and validate the time before schedules (as in EU-0.1). CR2032 is not rechargeable. No path from +3V3 to VBAT; MFP is unused. SD uses SPI; CMD and DAT0..DAT3 all have 10k pull-ups, including unused DAT1/2. SCK and MOSI series resistors are 100 R (s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

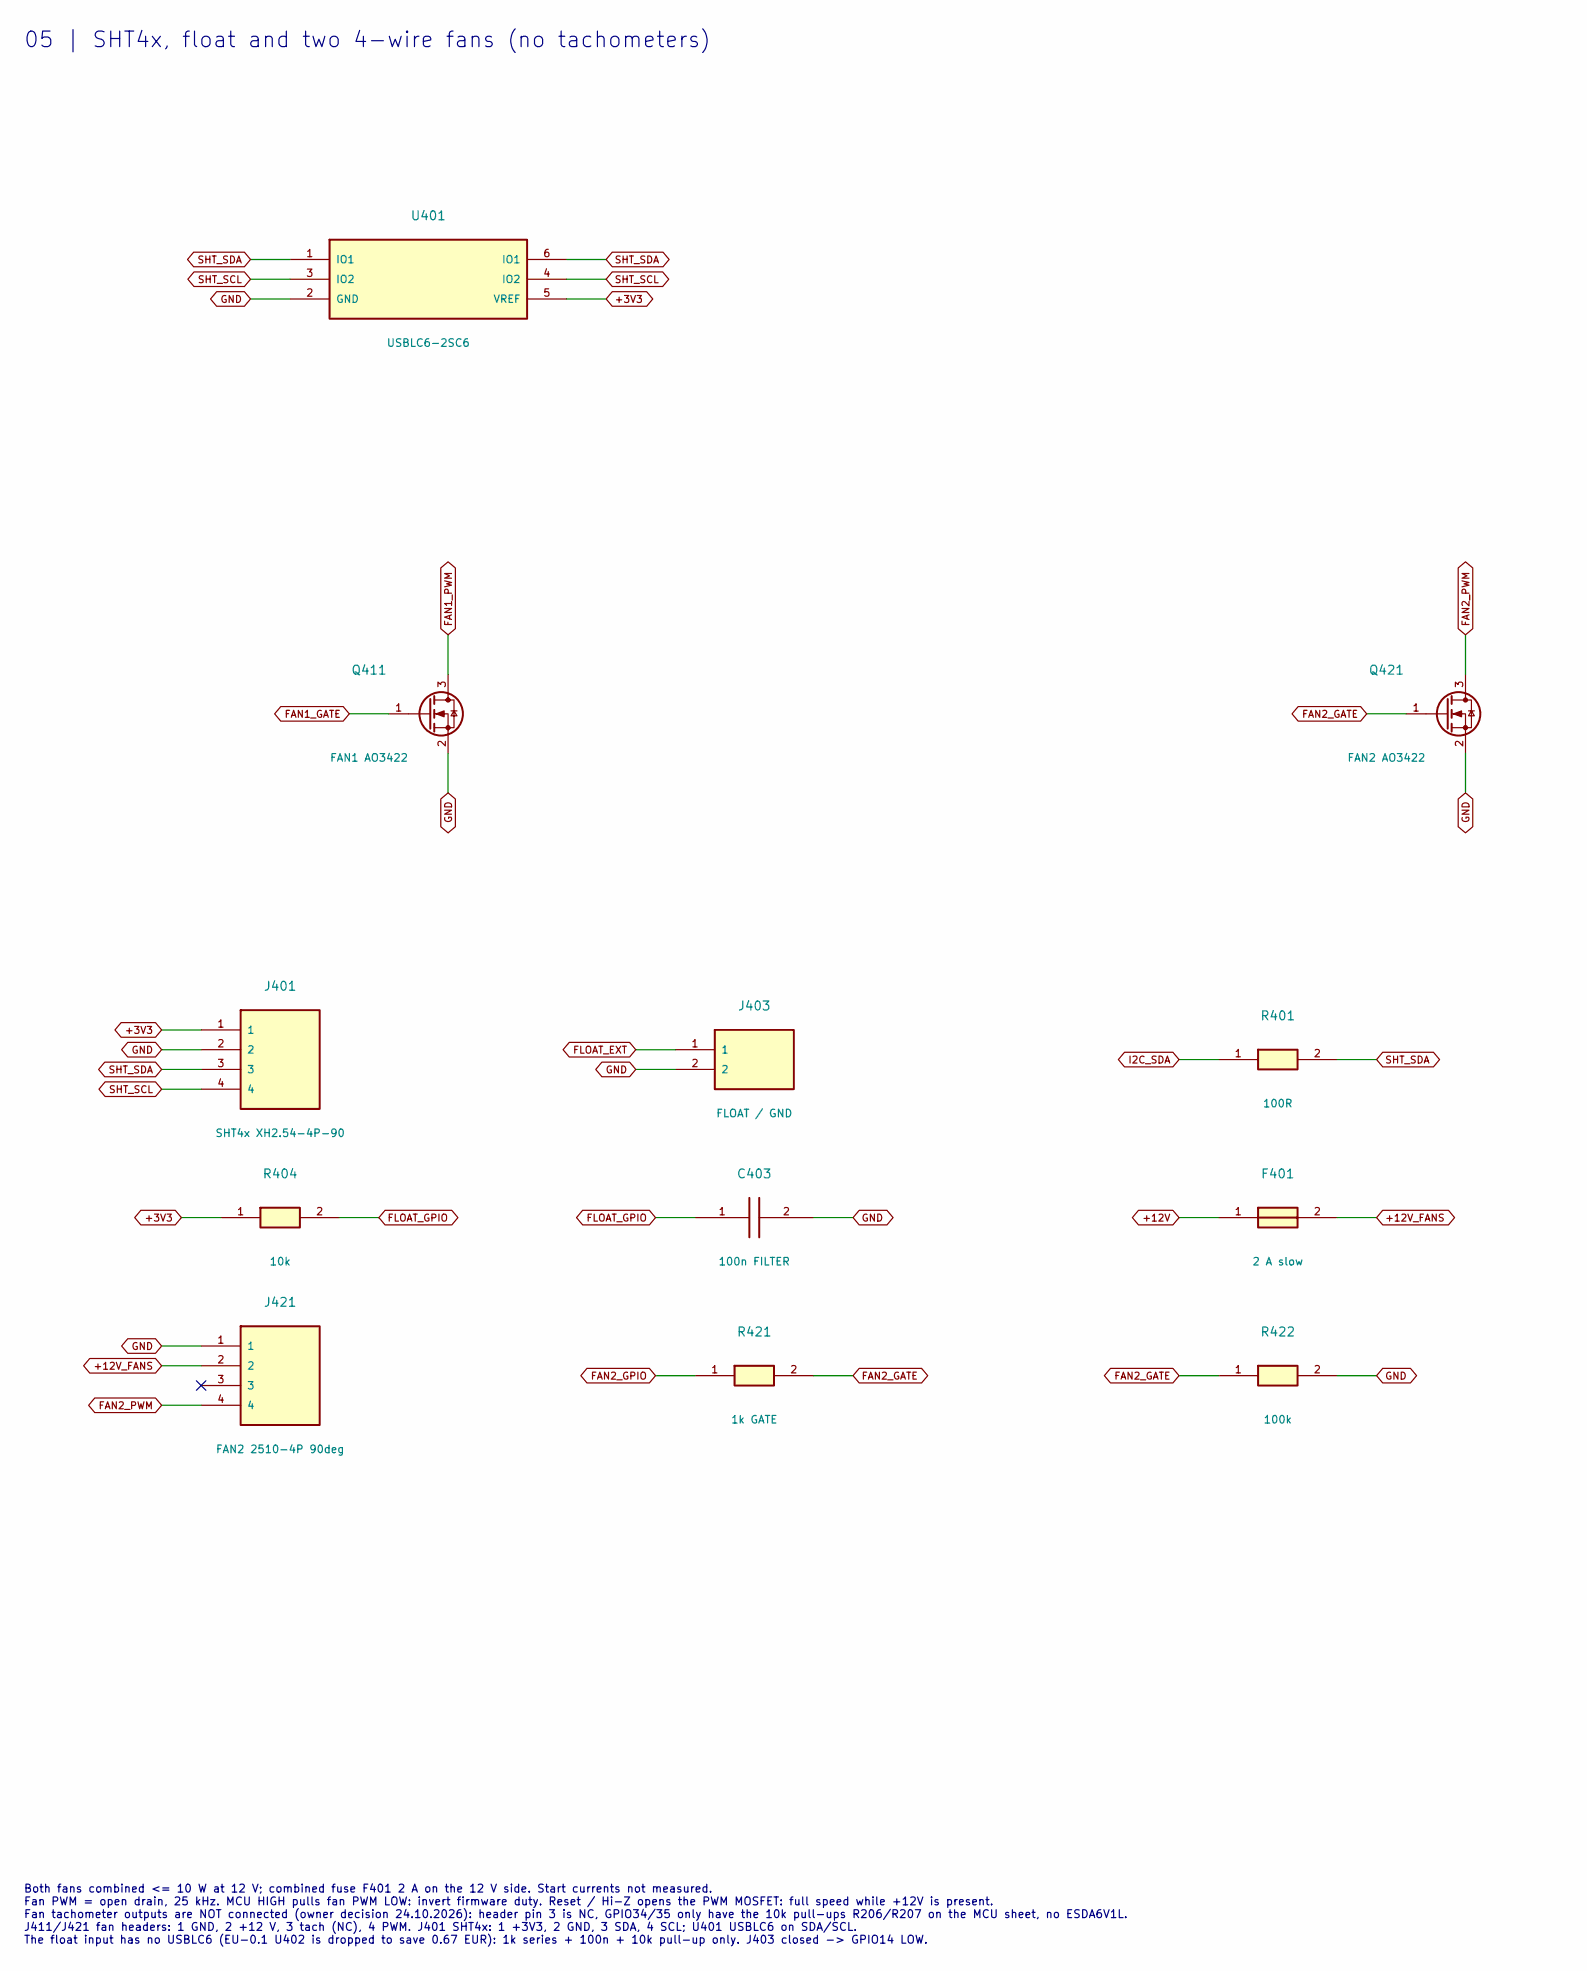
[picture p10: schematic Interfaces.kicad_sch, 05 | SHT4x, float and two 4-wire fans (no tachometers), part in row 1, column 1]

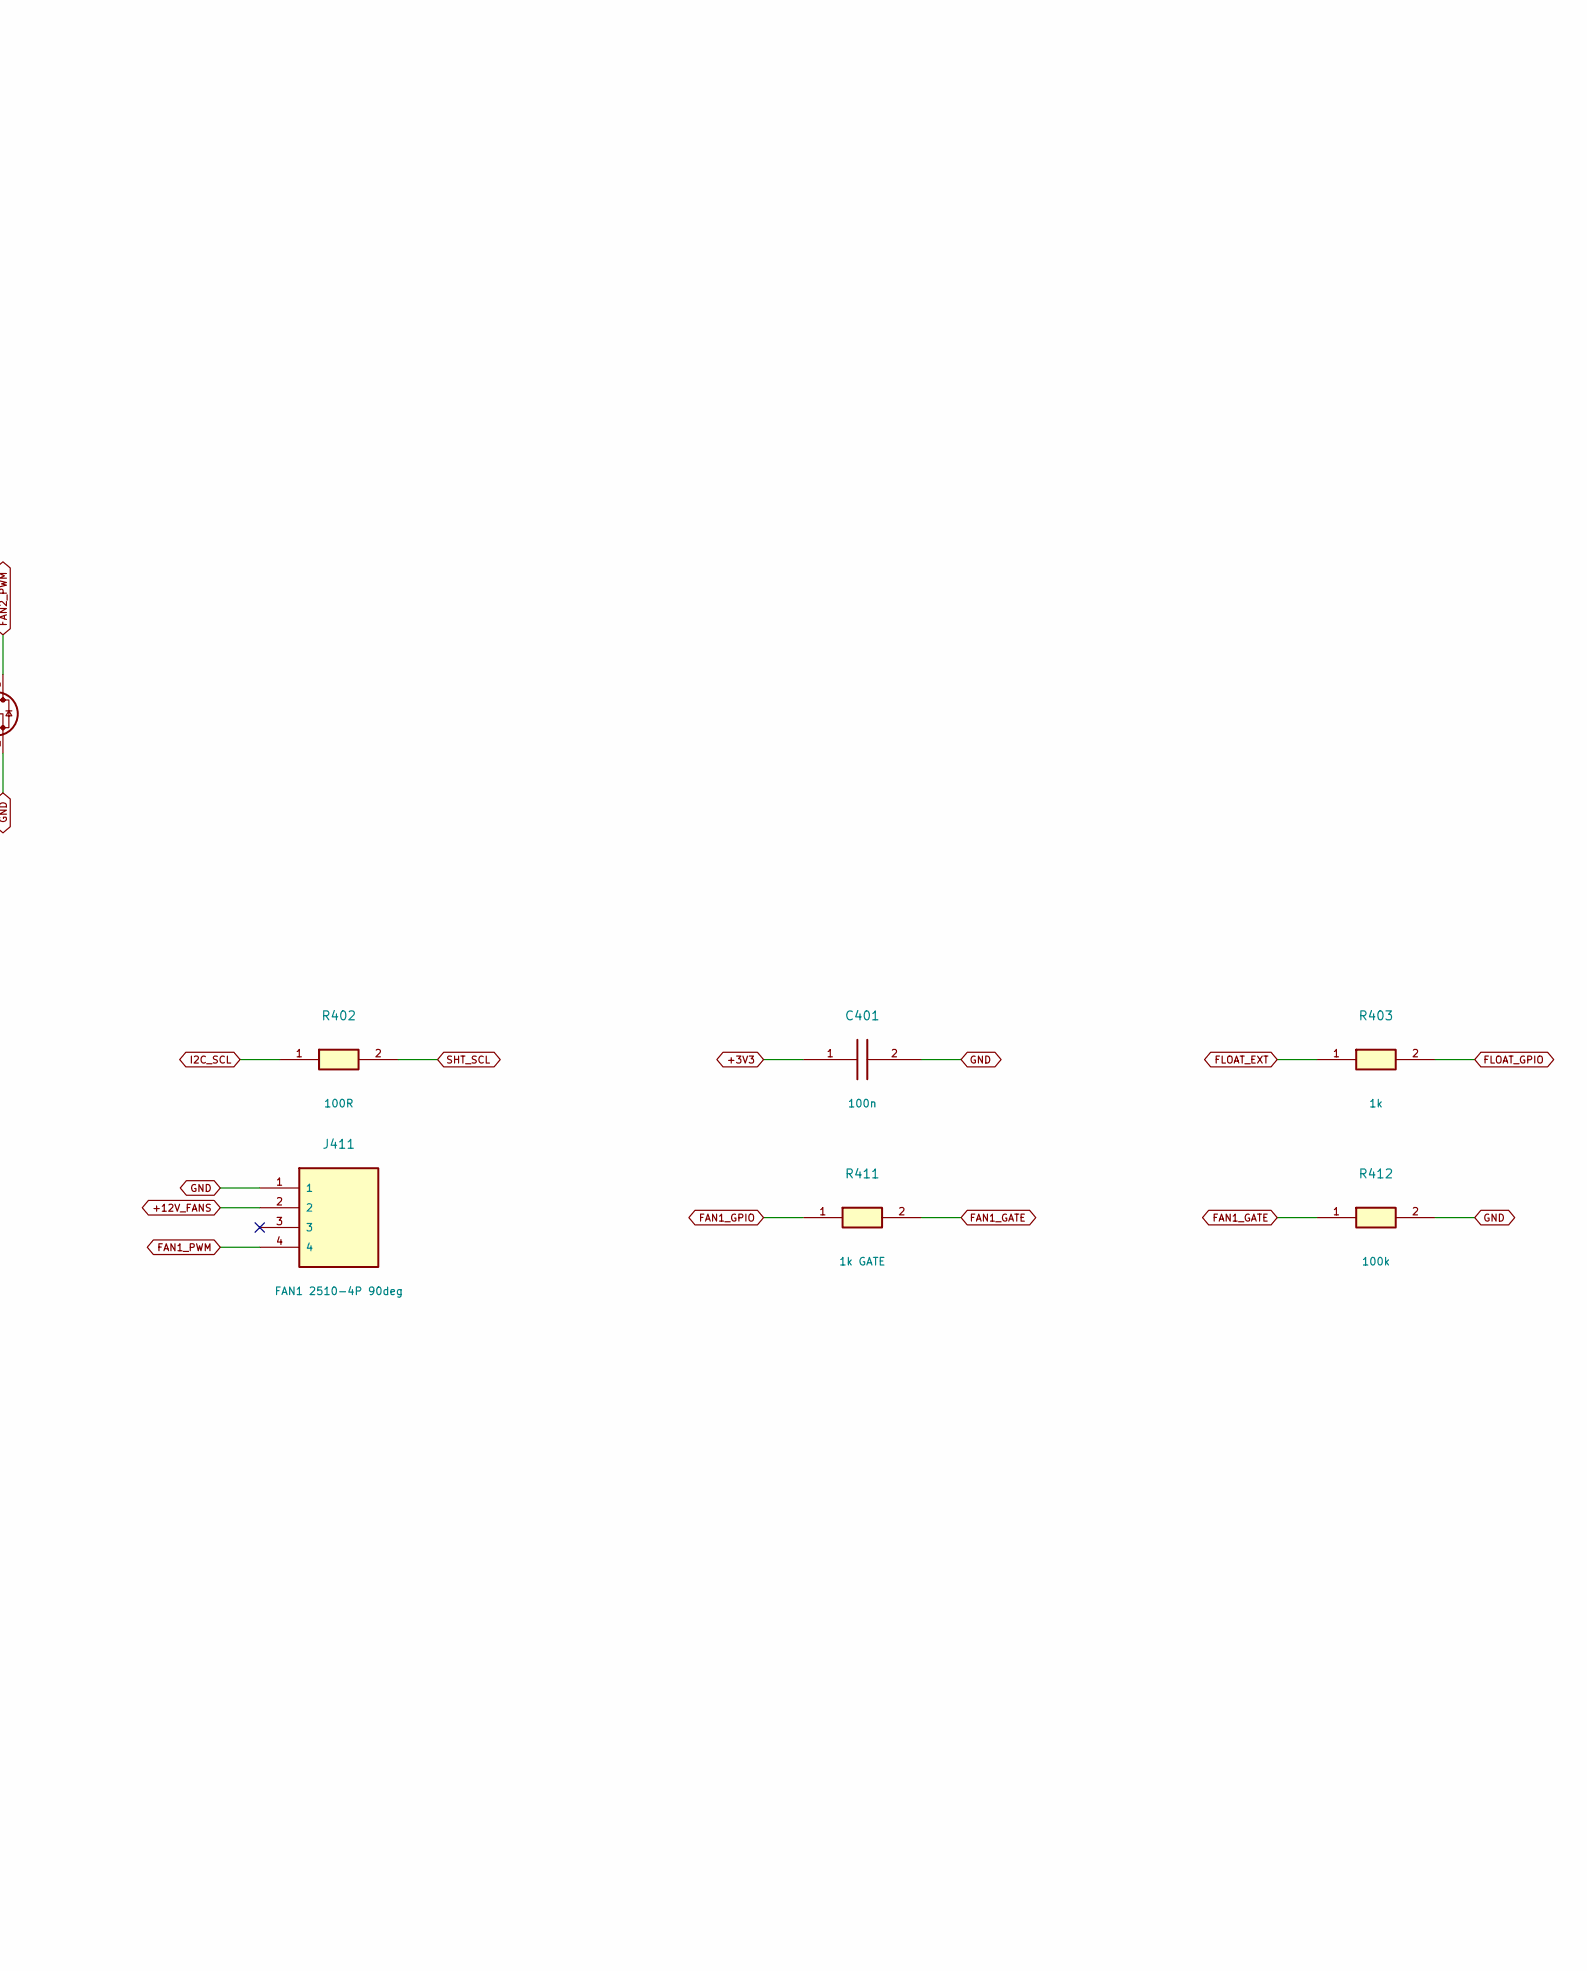
[picture p11: schematic Interfaces.kicad_sch, 05 | SHT4x, float and two 4-wire fans (no tachometers), part in row 1, column 2]

Parts:
C401: 100n; C_0603_1608Metric; MPN CL10B104KB8NNNC
C403: 100n FILTER; C_0603_1608Metric; MPN CL10B104KB8NNNC
F401: 2 A slow; Fuse_Schurter_UMT250; MPN 3403.0169.11
J401: SHT4x XH2.54-4P-90; JST_XH_S4B-XH-A_1x04_P2.50mm_Horizontal; MPN XH2.54-4P Right Angle
J403: FLOAT / GND; TerminalBlock_Phoenix_MKDS-1,5-2_1x02_P5.00mm_Horizontal; MPN KF301-5.0-2P
J411: FAN1 2510-4P 90deg; KF2510_1x04_P2.54mm_RightAngle; MPN KF2510 / KF2540 4P
J421: FAN2 2510-4P 90deg; KF2510_1x04_P2.54mm_RightAngle; MPN KF2510 / KF2540 4P
Q411: FAN1 AO3422; SOT-23; MPN AO3422
Q421: FAN2 AO3422; SOT-23; MPN AO3422
R401, R402: 100R; R_0805_2012Metric; MPN Резистор SMD 100 Ом, ±5%
R403: 1k; R_0603_1608Metric; MPN RC0603FR-071KL
R404: 10k; R_0805_2012Metric; MPN Резистор SMD 10 кОм, ±5%
R411, R421: 1k GATE; R_0603_1608Metric; MPN RC0603FR-071KL
R412, R422: 100k; R_0603_1608Metric; MPN RC0603FR-07100KL
U401: USBLC6-2SC6; SOT-23-6; MPN USBLC6-2SC6

Connections:
+3V3: C401.1, J401.1, R404.1, U401.5 (VREF); also elsewhere on the board
+12V: F401.1; also elsewhere on the board
+12V_FANS: F401.2, J411.2, J421.2
FAN1_GATE: Q411.1 (G), R411.2, R412.1
FAN1_GPIO: R411.1; also elsewhere on the board
FAN1_PWM: J411.4, Q411.3 (D)
FAN2_GATE: Q421.1 (G), R421.2, R422.1
FAN2_GPIO: R421.1; also elsewhere on the board
FAN2_PWM: J421.4, Q421.3 (D)
FLOAT_EXT: J403.1, R403.1
FLOAT_GPIO: C403.1, R403.2, R404.2; also elsewhere on the board
GND: C401.2, C403.2, J401.2, J403.2, J411.1, J421.1, Q411.2 (S), Q421.2 (S), R412.2, R422.2, U401.2 (GND); also elsewhere on the board
I2C_SCL: R402.1; also elsewhere on the board
I2C_SDA: R401.1; also elsewhere on the board
SHT_SCL: J401.4, R402.2, U401.3 (IO2), U401.4 (IO2)
SHT_SDA: J401.3, R401.2, U401.1 (IO1), U401.6 (IO1)

Notes on the sheet:
05 | SHT4x, float and two 4-wire fans (no tachometers)
Both fans combined <= 10 W at 12 V; combined fuse F401 2 A on the 12 V side. Start currents not measured. Fan PWM = open drain, 25 kHz. MCU HIGH pulls fan PWM LOW: invert firmware duty. Reset / Hi-Z opens the PWM MOSFET: full speed while +12V is present. Fan tachometer outputs are NOT connected (ow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
