nikolajevs/MicroGarden_V1/hardware/PCB_EU_LITE/PCB_EU_LITE.kicad_pcb

## KiCad design hardware/PCB_EU_LITE/PCB_EU_LITE.kicad_pcb (continued)

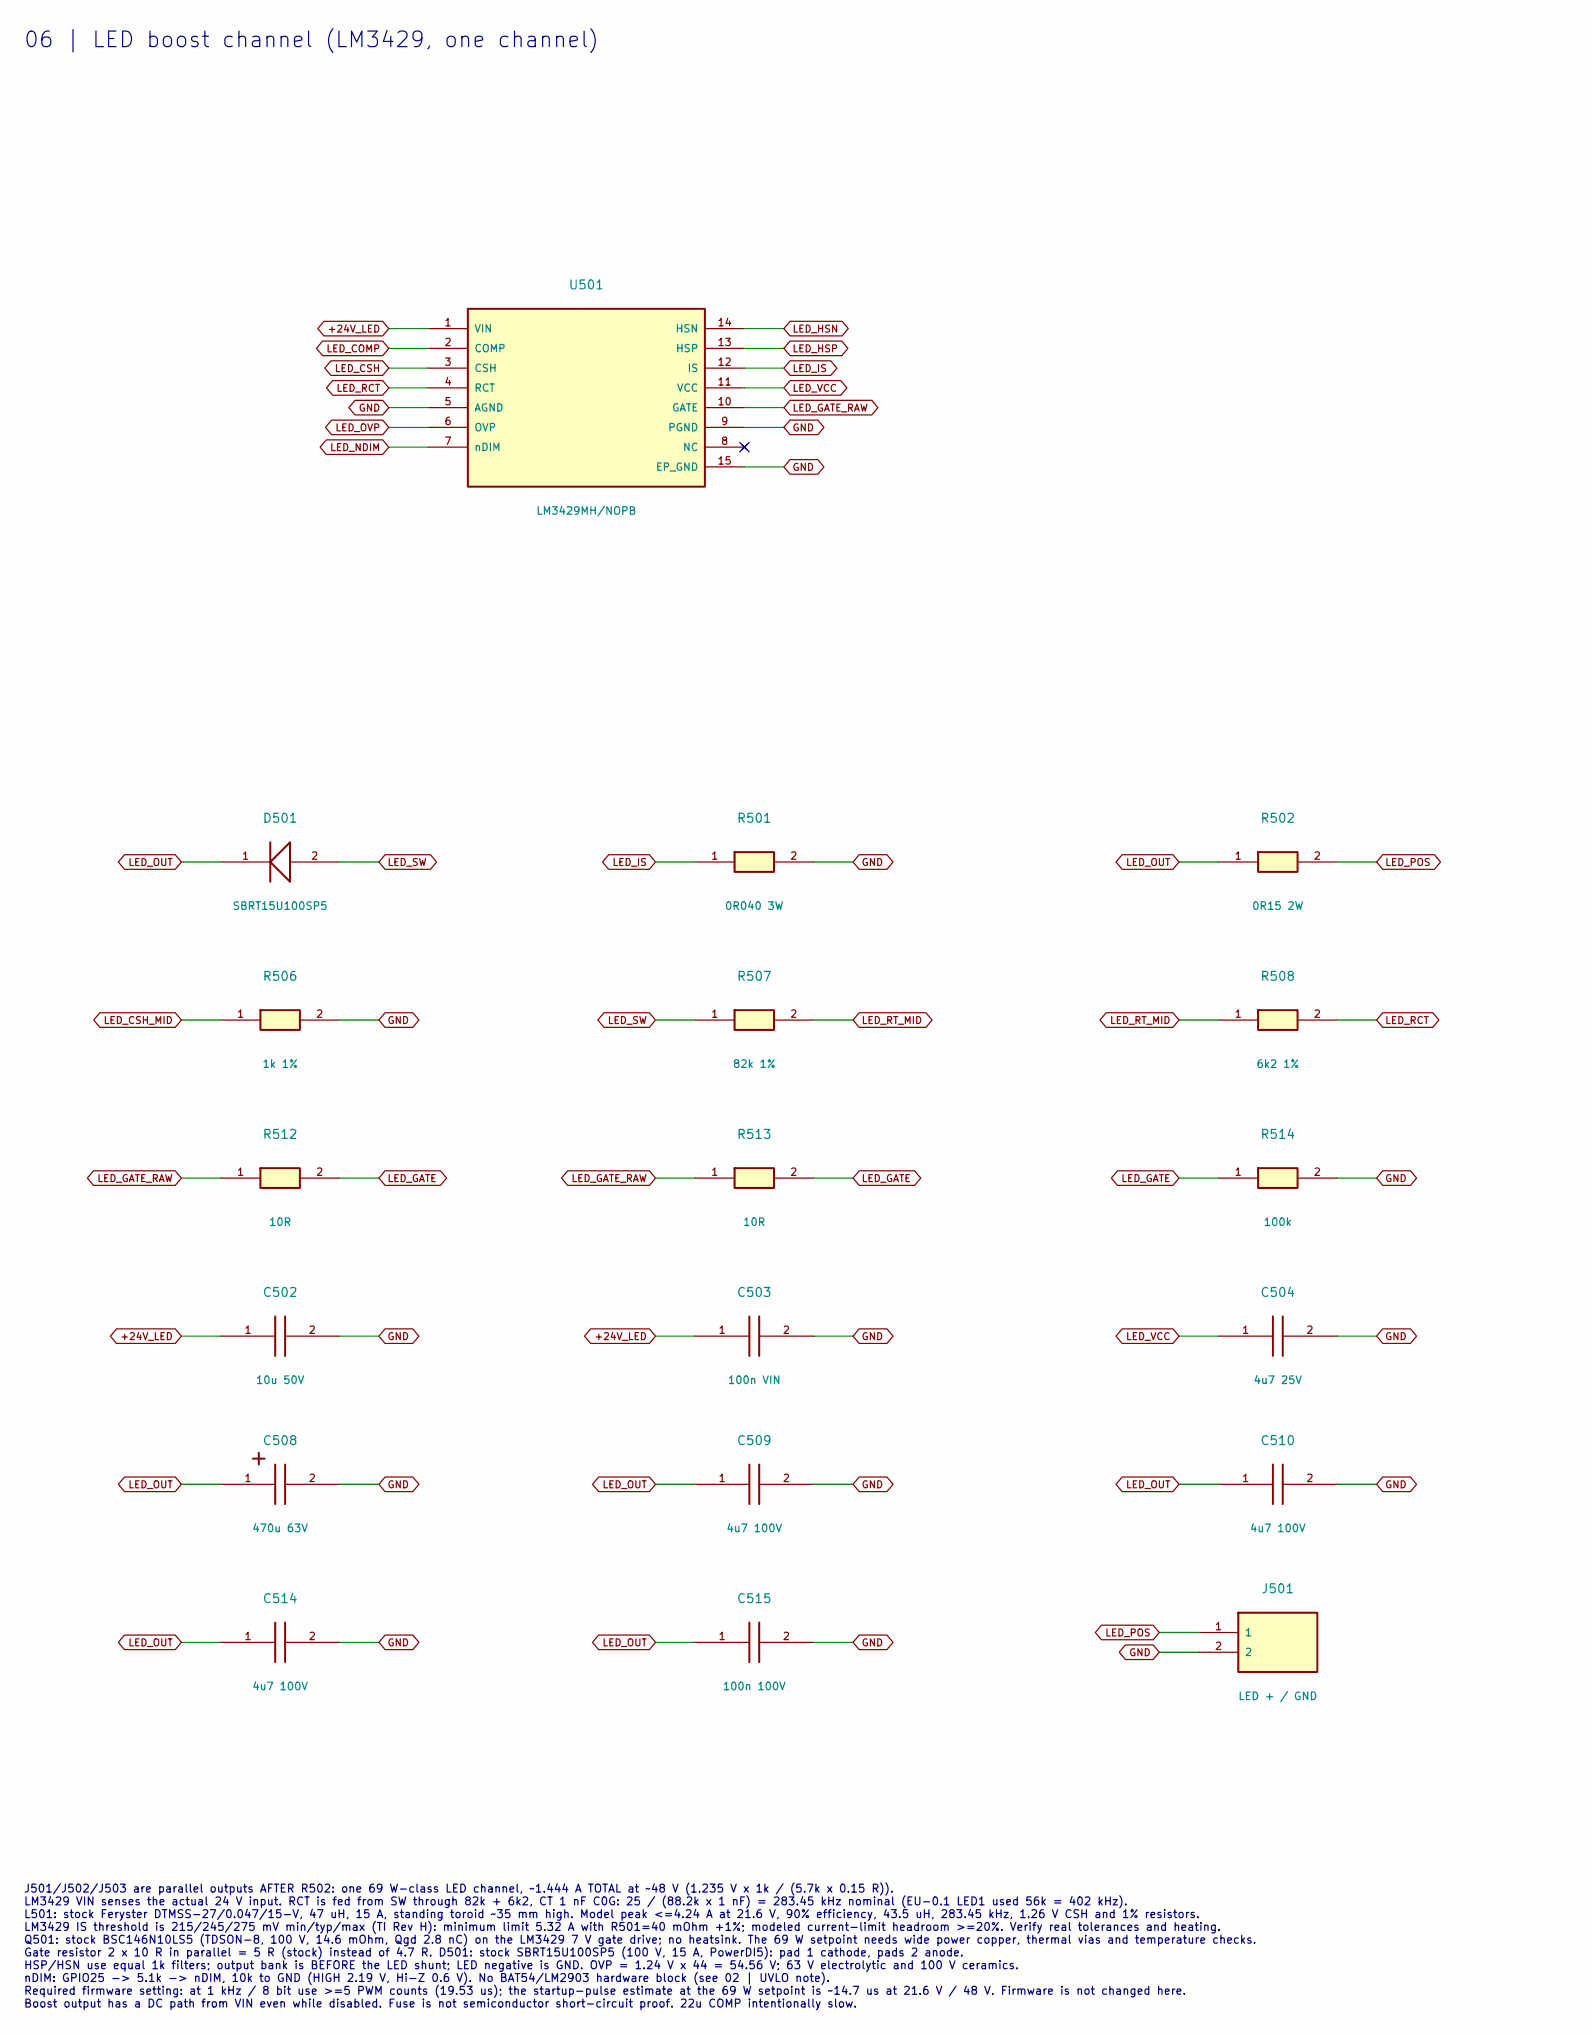
[picture p12: schematic LED.kicad_sch, 06 | LED boost channel (LM3429, one channel), part in row 1, column 1]

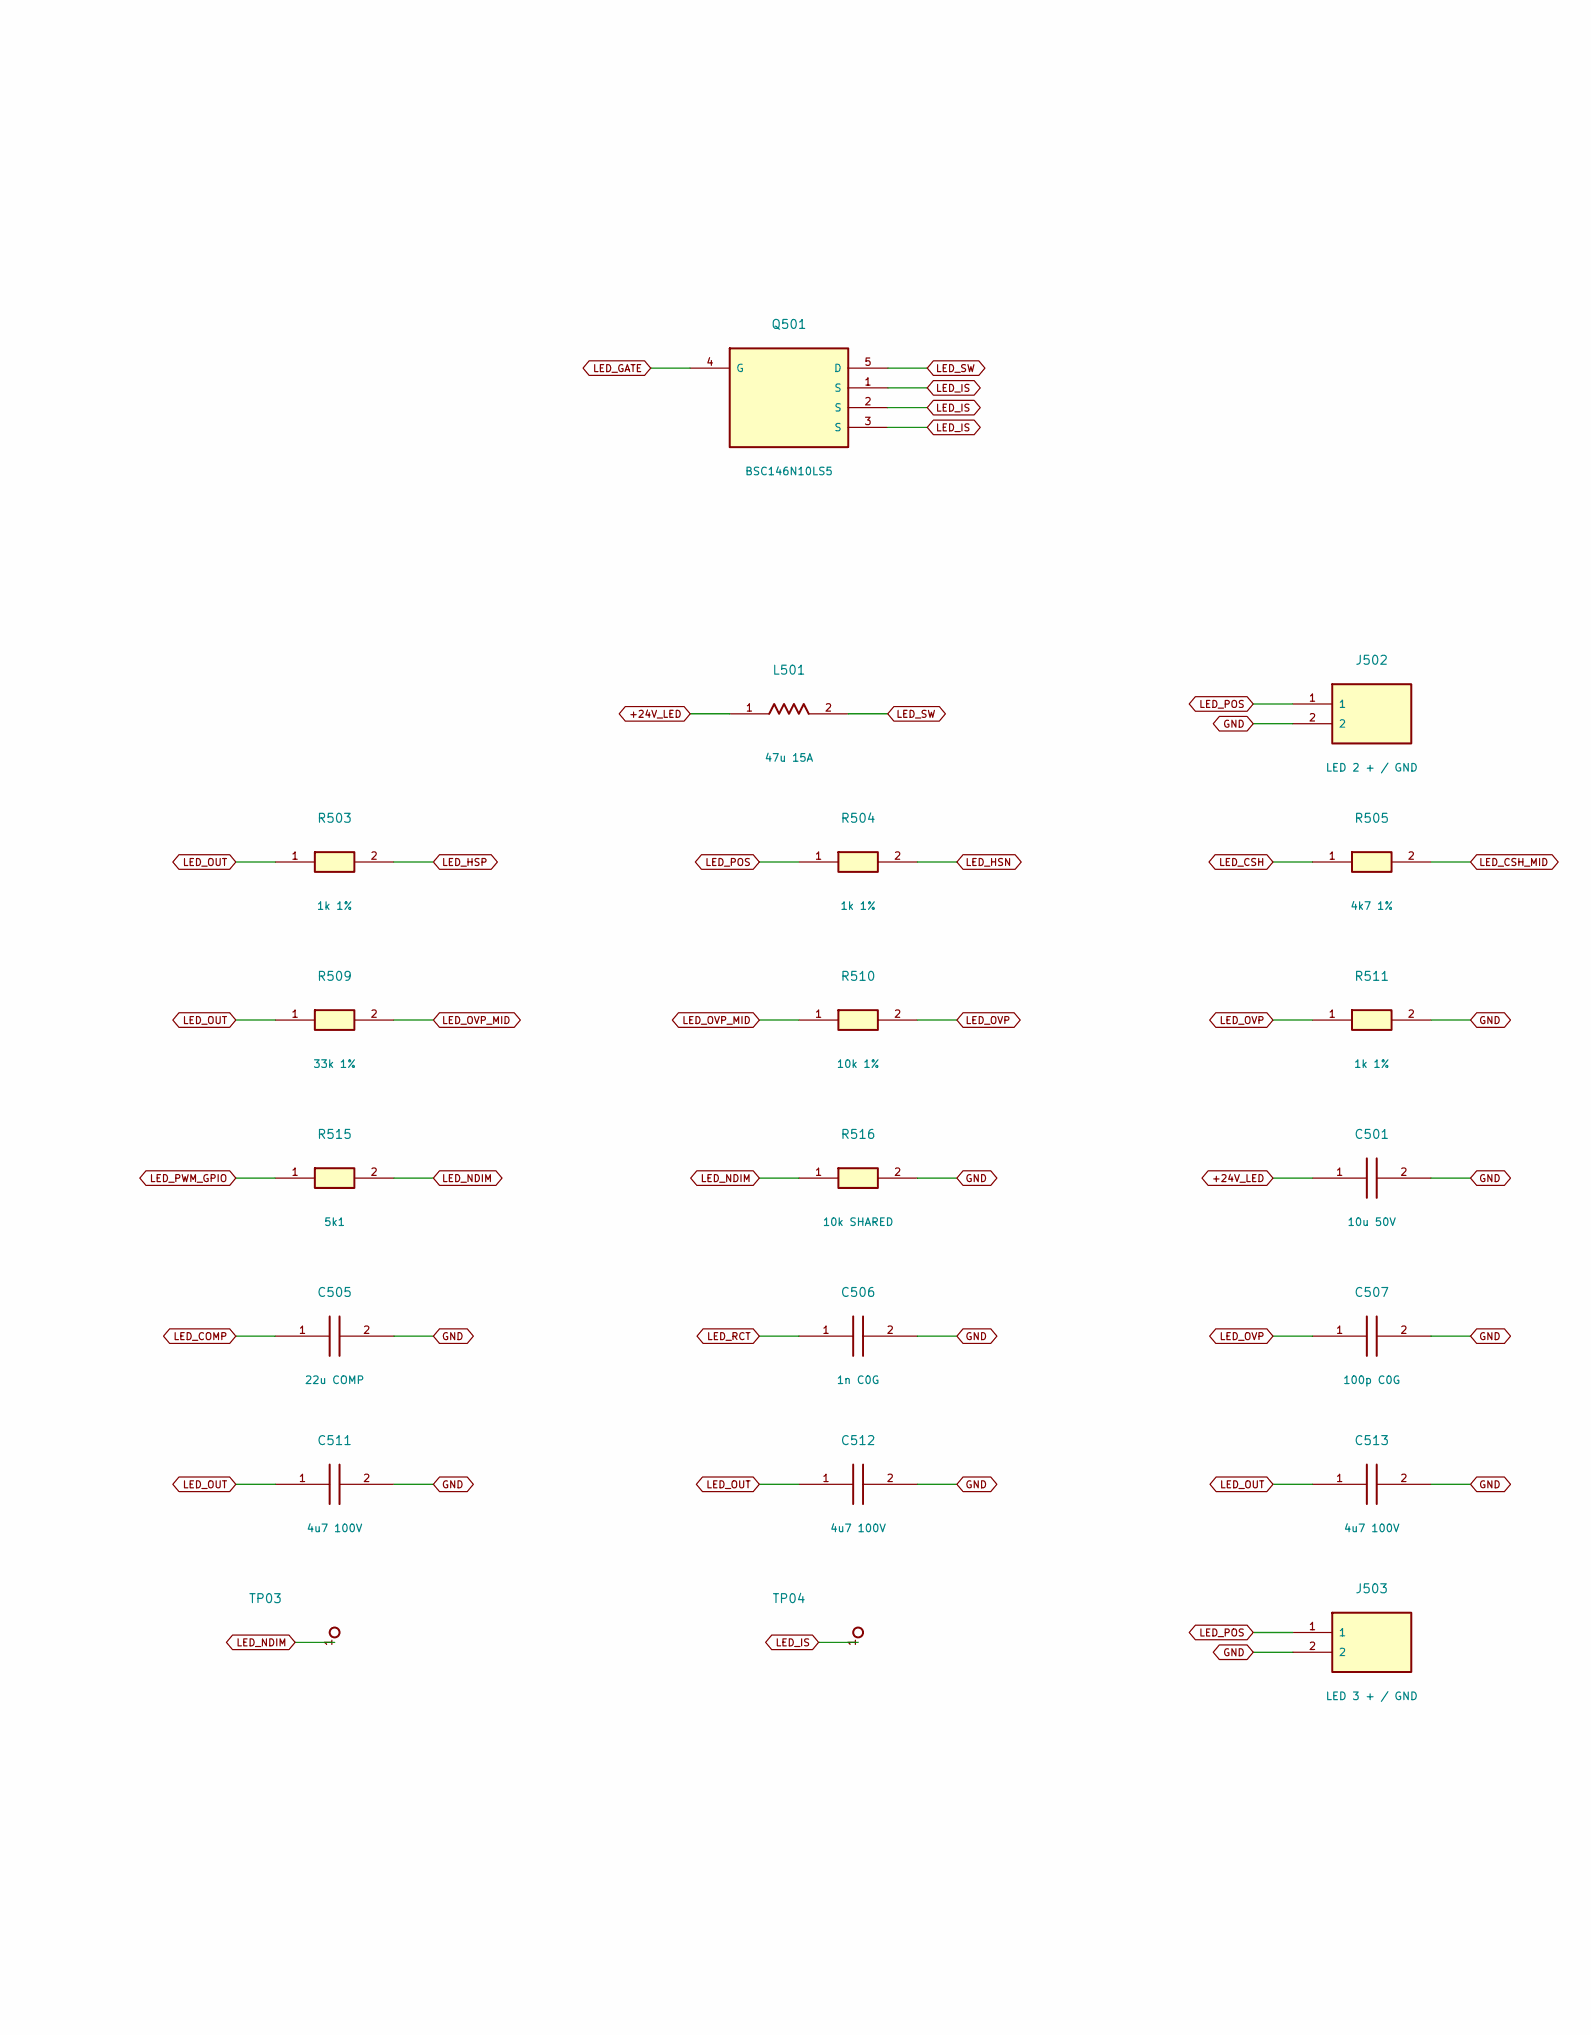
[picture p13: schematic LED.kicad_sch, 06 | LED boost channel (LM3429, one channel), part in row 1, column 2]

Parts:
C501, C502: 10u 50V; C_1210_3225Metric; MPN CL32B106KBJNNNE
C503: 100n VIN; C_0603_1608Metric; MPN CL10B104KB8NNNC
C504: 4u7 25V; C_0805_2012Metric; MPN CL21A475KAQNNNG
C505: 22u COMP; C_0805_2012Metric; MPN CL21A226KPCLRNC
C506: 1n C0G; C_1206_3216Metric; MPN C1206C102JCGACTU
C507: 100p C0G; C_1206_3216Metric; MPN CL31C101JBCNNNC
C508: 470u 63V; CP_Elec_16x17.5; MPN EEVFK1J471M
C509, C510, C511, C512, C513, C514: 4u7 100V; C_1210_3225Metric; MPN CL32B475KCI6PJE
C515: 100n 100V; C_0805_2012Metric; MPN KAF21KR72A104KL
D501: SBRT15U100SP5; Diodes_PowerDI5; MPN SBRT15U100SP5
J501: LED + / GND; TerminalBlock_Phoenix_MKDS-1,5-2_1x02_P5.00mm_Horizontal; MPN KF301-5.0-2P
J502: LED 2 + / GND; TerminalBlock_Phoenix_MKDS-1,5-2_1x02_P5.00mm_Horizontal; MPN KF301-5.0-2P
J503: LED 3 + / GND; TerminalBlock_Phoenix_MKDS-1,5-2_1x02_P5.00mm_Horizontal; MPN KF301-5.0-2P
L501: 47u 15A; L_Feryster_DTMSS-27_V; MPN Дроссель силовой 47 мкГн, 15 А
Q501: BSC146N10LS5; TDSON-8-1; MPN BSC146N10LS5
R501: 0R040 3W; R_2512_6332Metric; MPN LRP2512-R040-1%
R502: 0R15 2W; R_2512_6332Metric; MPN CS2512-0R15-1%-HP
R503, R504, R511: 1k 1%; R_0603_1608Metric; MPN RC0603FR-071KL
R505: 4k7 1%; R_1206_3216Metric; MPN SMD1206 4K7 1%
R506: 1k 1%; R_1206_3216Metric; MPN SMD1206-1K-1%
R507: 82k 1%; R_1206_3216Metric; MPN CRCW120682K0FKTABC
R508: 6k2 1%; R_1206_3216Metric; MPN SMD1206-6K2-1%
R509: 33k 1%; R_1206_3216Metric; MPN SMD1206-33K-1%
R510: 10k 1%; R_0805_2012Metric; MPN Резистор SMD 10 кОм, ±1%
R512, R513: 10R; R_1206_3216Metric; MPN Резистор SMD 10 Ом, ±5%
R514: 100k; R_0603_1608Metric; MPN RC0603FR-07100KL
R515: 5k1; R_1206_3216Metric; MPN Резистор SMD 5,1 кОм, ±5%
R516: 10k SHARED; R_0603_1608Metric; MPN RC0603J10K
TP03: LED_NDIM; TestPoint_Pad_D1.0mm
TP04: LED_IS; TestPoint_Pad_D1.0mm
U501: LM3429MH/NOPB; TI_PWP0014A_LM3429; MPN LM3429MH/NOPB

Connections:
+24V_LED: C501.1, C502.1, C503.1, L501.1, U501.1 (VIN); also elsewhere on the board
GND: C501.2, C502.2, C503.2, C504.2, C505.2, C506.2, C507.2, C508.2, C509.2, C510.2, C511.2, C512.2, C513.2, C514.2, C515.2, J501.2, J502.2, J503.2, R501.2, R506.2, R511.2, R514.2, R516.2, U501.5 (AGND), U501.9 (PGND), U501.15 (EP_GND); also elsewhere on the board
LED_COMP: C505.1, U501.2 (COMP)
LED_CSH: R505.1, U501.3 (CSH)
LED_CSH_MID: R505.2, R506.1
LED_GATE: Q501.4 (G), R512.2, R513.2, R514.1
LED_GATE_RAW: R512.1, R513.1, U501.10 (GATE)
LED_HSN: R504.2, U501.14 (HSN)
LED_HSP: R503.2, U501.13 (HSP)
LED_IS: Q501.1 (S), Q501.2 (S), Q501.3 (S), R501.1, TP04.1, U501.12 (IS)
LED_NDIM: R515.2, R516.1, TP03.1, U501.7 (nDIM)
LED_OUT: C508.1, C509.1, C510.1, C511.1, C512.1, C513.1, C514.1, C515.1, D501.1 (K), R502.1, R503.1, R509.1
LED_OVP: C507.1, R510.2, R511.1, U501.6 (OVP)
LED_OVP_MID: R509.2, R510.1
LED_POS: J501.1, J502.1, J503.1, R502.2, R504.1
LED_PWM_GPIO: R515.1; also elsewhere on the board
LED_RCT: C506.1, R508.2, U501.4 (RCT)
LED_RT_MID: R507.2, R508.1
LED_SW: D501.2 (A), L501.2, Q501.5 (D), R507.1
LED_VCC: C504.1, U501.11 (VCC)

Notes on the sheet:
06 | LED boost channel (LM3429, one channel)
J501/J502/J503 are parallel outputs AFTER R502: one 69 W-class LED channel, ~1.444 A TOTAL at ~48 V (1.235 V x 1k / (5.7k x 0.15 R)). LM3429 VIN senses the actual 24 V input. RCT is fed from SW through 82k + 6k2, CT 1 nF C0G: 25 / (88.2k x 1 nF) = 283.45 kHz nominal (EU-0.1 LED1 used 56k = 402 kHz)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

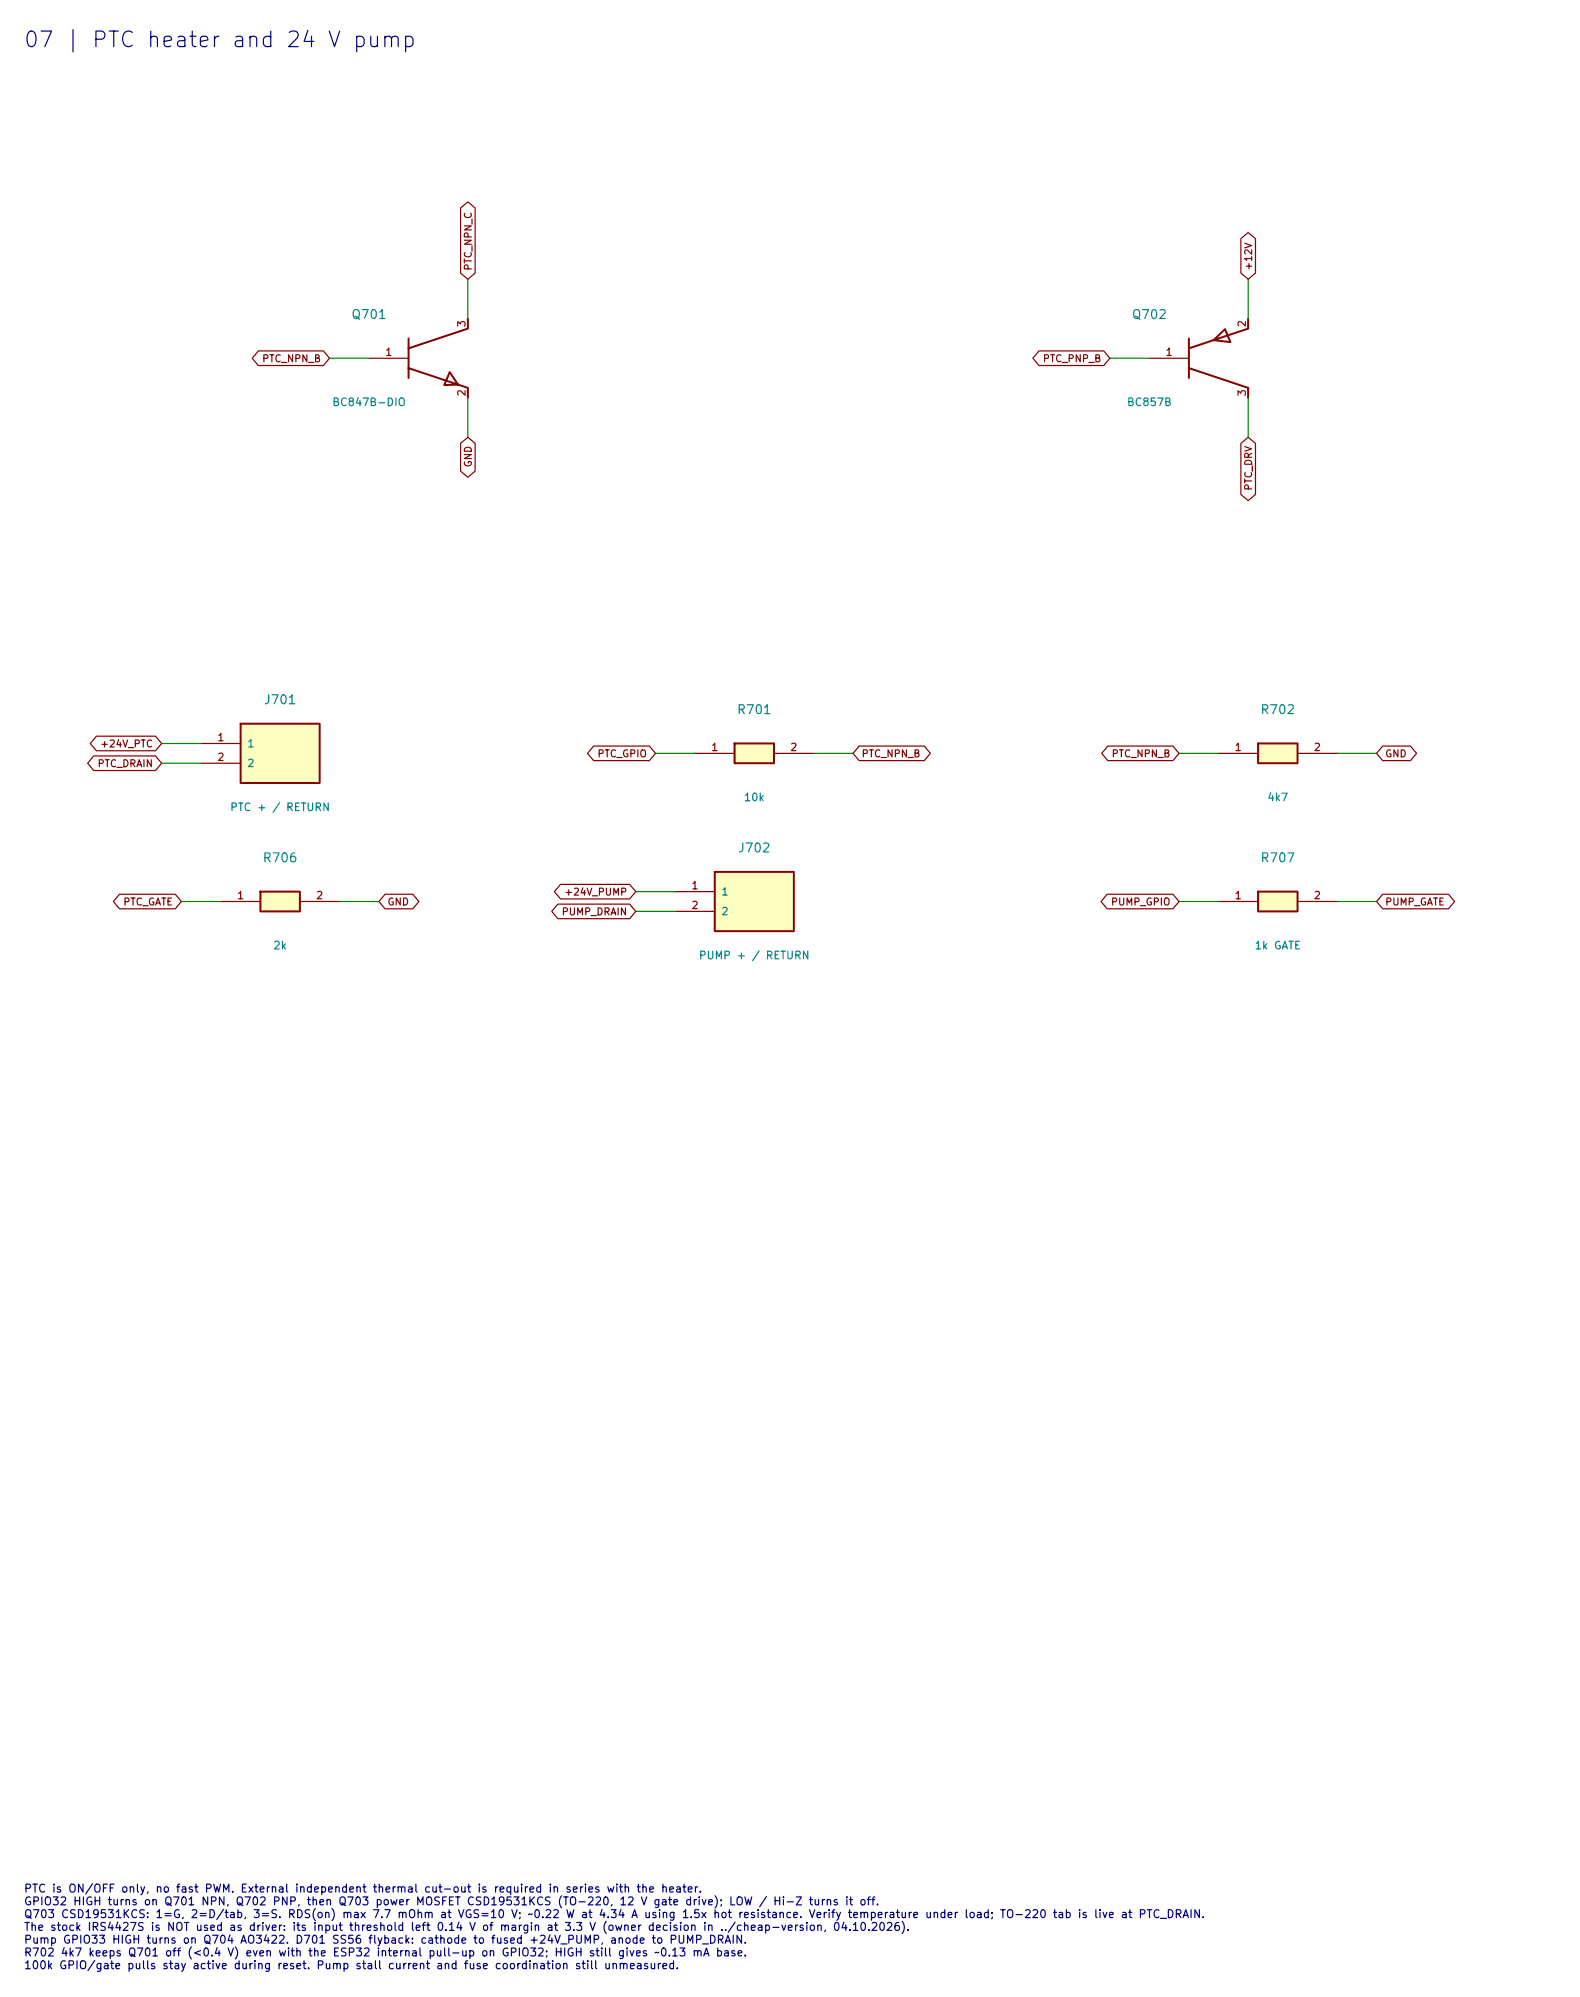
[picture p14: schematic Loads.kicad_sch, 07 | PTC heater and 24 V pump, part in row 1, column 1]

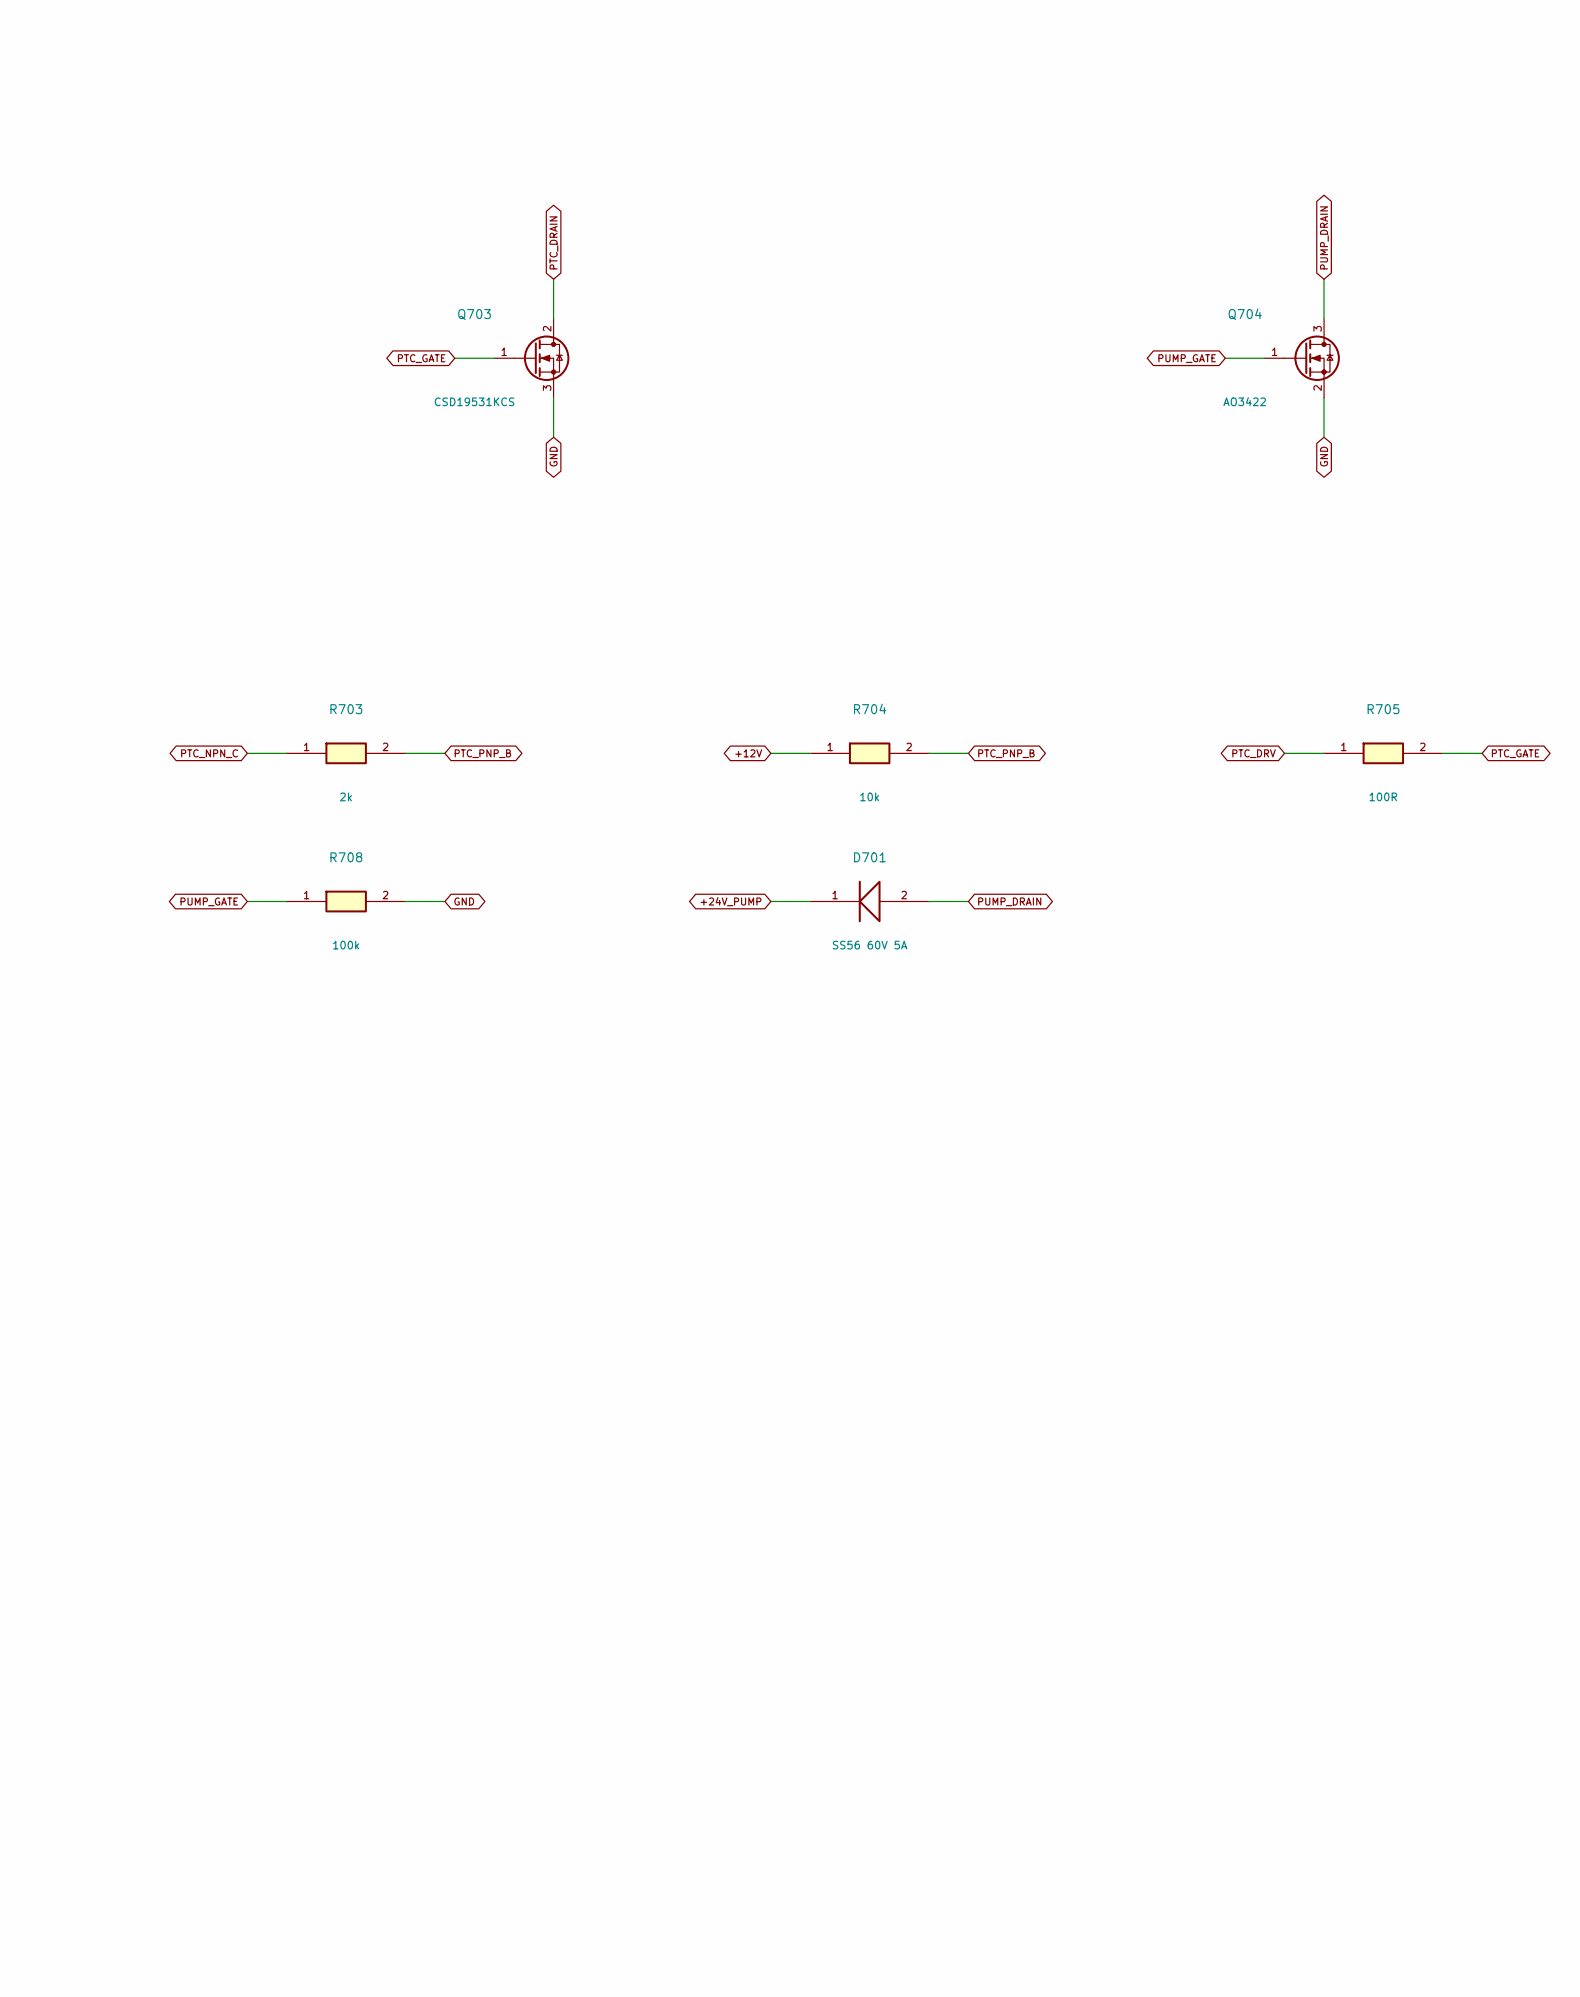
[picture p15: schematic Loads.kicad_sch, 07 | PTC heater and 24 V pump, part in row 1, column 2]

Parts:
D701: SS56 60V 5A; D_SMC; MPN SS56
J701: PTC + / RETURN; TerminalBlock_Phoenix_MKDS-1,5-2_1x02_P5.00mm_Horizontal; MPN KF301-5.0-2P
J702: PUMP + / RETURN; TerminalBlock_Phoenix_MKDS-1,5-2_1x02_P5.00mm_Horizontal; MPN KF301-5.0-2P
Q701: BC847B-DIO; SOT-23; MPN BC847B-DIO
Q702: BC857B; SOT-23; MPN BC857B
Q703: CSD19531KCS; TO-220-3_Vertical; MPN CSD19531KCS
Q704: AO3422; SOT-23; MPN AO3422
R701, R704: 10k; R_0805_2012Metric; MPN Резистор SMD 10 кОм, ±5%
R702: 4k7; R_0805_2012Metric; MPN Резистор SMD 4,7 кОм, ±5%
R703, R706: 2k; R_1206_3216Metric; MPN Резистор SMD 2 кОм, ±5%
R705: 100R; R_0805_2012Metric; MPN Резистор SMD 100 Ом, ±5%
R707: 1k GATE; R_0603_1608Metric; MPN RC0603FR-071KL
R708: 100k; R_0603_1608Metric; MPN RC0603FR-07100KL

Connections:
+12V: Q702.2 (E), R704.1; also elsewhere on the board
+24V_PTC: J701.1; also elsewhere on the board
+24V_PUMP: D701.1 (K), J702.1; also elsewhere on the board
GND: Q701.2 (E), Q703.3 (S), Q704.2 (S), R702.2, R706.2, R708.2; also elsewhere on the board
PTC_DRAIN: J701.2, Q703.2 (D)
PTC_DRV: Q702.3 (C), R705.1
PTC_GATE: Q703.1 (G), R705.2, R706.1
PTC_GPIO: R701.1; also elsewhere on the board
PTC_NPN_B: Q701.1 (B), R701.2, R702.1
PTC_NPN_C: Q701.3 (C), R703.1
PTC_PNP_B: Q702.1 (B), R703.2, R704.2
PUMP_DRAIN: D701.2 (A), J702.2, Q704.3 (D)
PUMP_GATE: Q704.1 (G), R707.2, R708.1
PUMP_GPIO: R707.1; also elsewhere on the board

Notes on the sheet:
07 | PTC heater and 24 V pump
PTC is ON/OFF only, no fast PWM. External independent thermal cut-out is required in series with the heater. GPIO32 HIGH turns on Q701 NPN, Q702 PNP, then Q703 power MOSFET CSD19531KCS (TO-220, 12 V gate drive); LOW / Hi-Z turns it off. Q703 CSD19531KCS: 1=G, 2=D/tab, 3=S. RDS(on) max 7.7 mOhm at V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

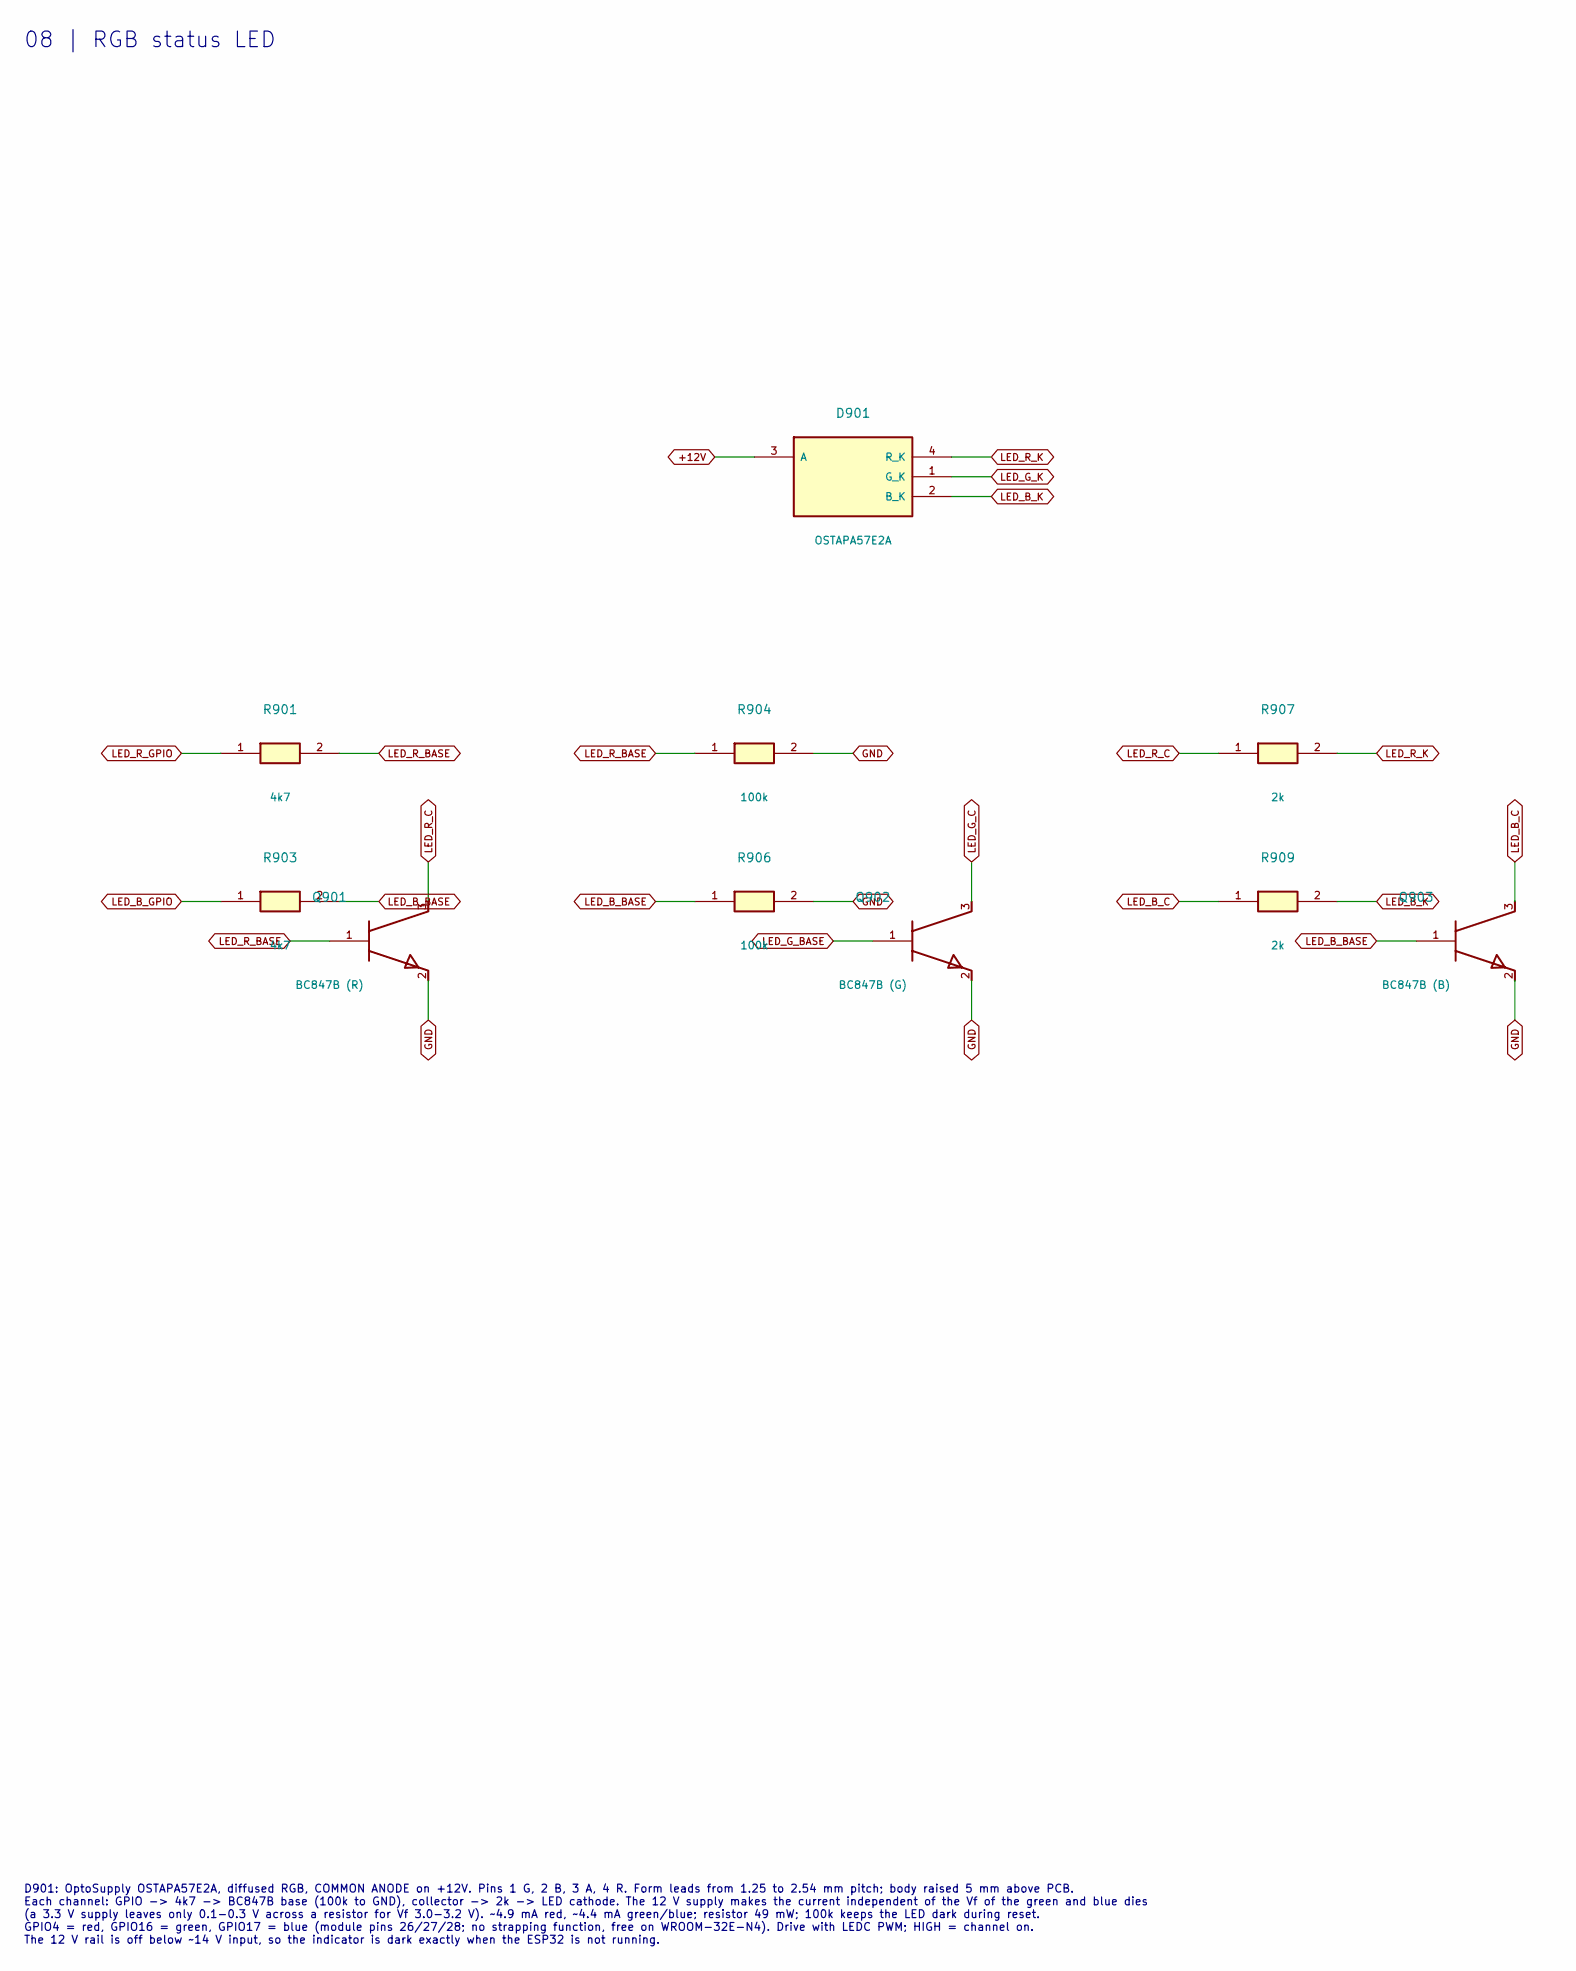
[picture p16: schematic Status.kicad_sch, 08 | RGB status LED, part in row 1, column 1]

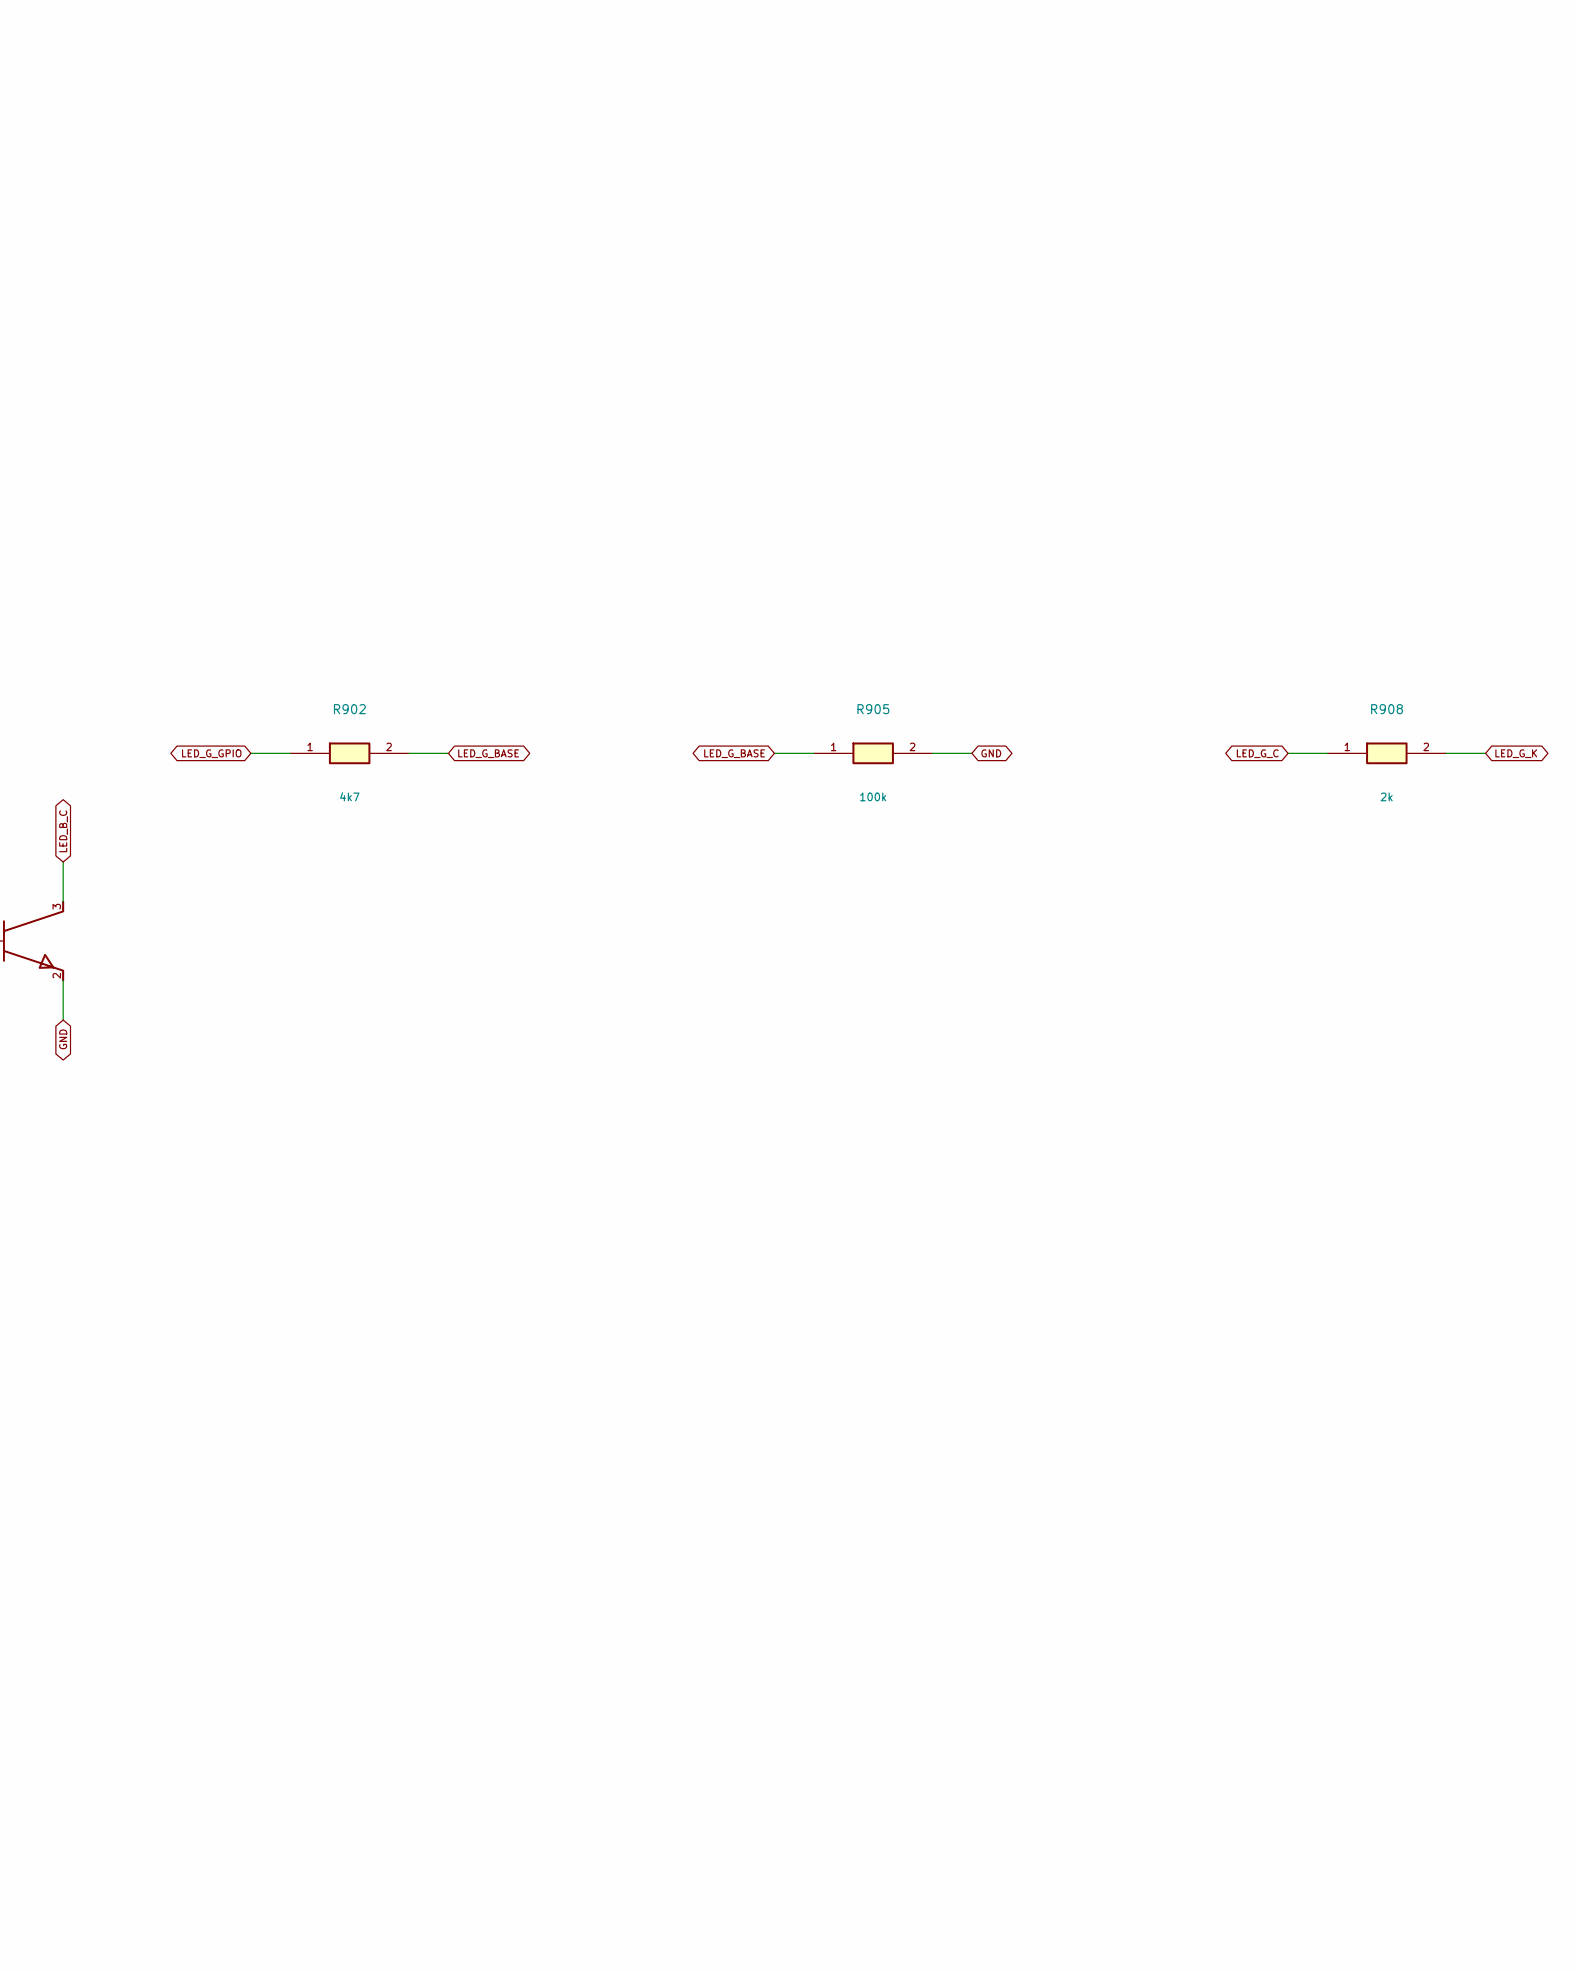
[picture p17: schematic Status.kicad_sch, 08 | RGB status LED, part in row 1, column 2]

Parts:
D901: OSTAPA57E2A; LED_OSTAPA57E2A_Formed_P2.54mm; MPN OSTAPA57E2A
Q901: BC847B (R); SOT-23; MPN BC847B-DIO
Q902: BC847B (G); SOT-23; MPN BC847B-DIO
Q903: BC847B (B); SOT-23; MPN BC847B-DIO
R901, R902, R903: 4k7; R_0805_2012Metric; MPN Резистор SMD 4,7 кОм, ±5%
R904, R905, R906: 100k; R_0805_2012Metric; MPN Резистор SMD 100 кОм, ±5%
R907, R908, R909: 2k; R_1206_3216Metric; MPN Резистор SMD 2 кОм, ±5%

Connections:
+12V: D901.3 (A); also elsewhere on the board
GND: Q901.2 (E), Q902.2 (E), Q903.2 (E), R904.2, R905.2, R906.2; also elsewhere on the board
LED_B_BASE: Q903.1 (B), R903.2, R906.1
LED_B_C: Q903.3 (C), R909.1
LED_B_GPIO: R903.1; also elsewhere on the board
LED_B_K: D901.2 (B_K), R909.2
LED_G_BASE: Q902.1 (B), R902.2, R905.1
LED_G_C: Q902.3 (C), R908.1
LED_G_GPIO: R902.1; also elsewhere on the board
LED_G_K: D901.1 (G_K), R908.2
LED_R_BASE: Q901.1 (B), R901.2, R904.1
LED_R_C: Q901.3 (C), R907.1
LED_R_GPIO: R901.1; also elsewhere on the board
LED_R_K: D901.4 (R_K), R907.2

Notes on the sheet:
08 | RGB status LED
D901: OptoSupply OSTAPA57E2A, diffused RGB, COMMON ANODE on +12V. Pins 1 G, 2 B, 3 A, 4 R. Form leads from 1.25 to 2.54 mm pitch; body raised 5 mm above PCB. Each channel: GPIO -> 4k7 -> BC847B base (100k to GND), collector -> 2k -> LED cathode. The 12 V supply makes the current independent of the 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
