nikolajevs/MicroGarden_V1/hardware/PCB_EU_LITE/PCB_EU_LITE.kicad_pcb

## KiCad design hardware/PCB_EU_LITE/PCB_EU_LITE.kicad_pcb (continued)

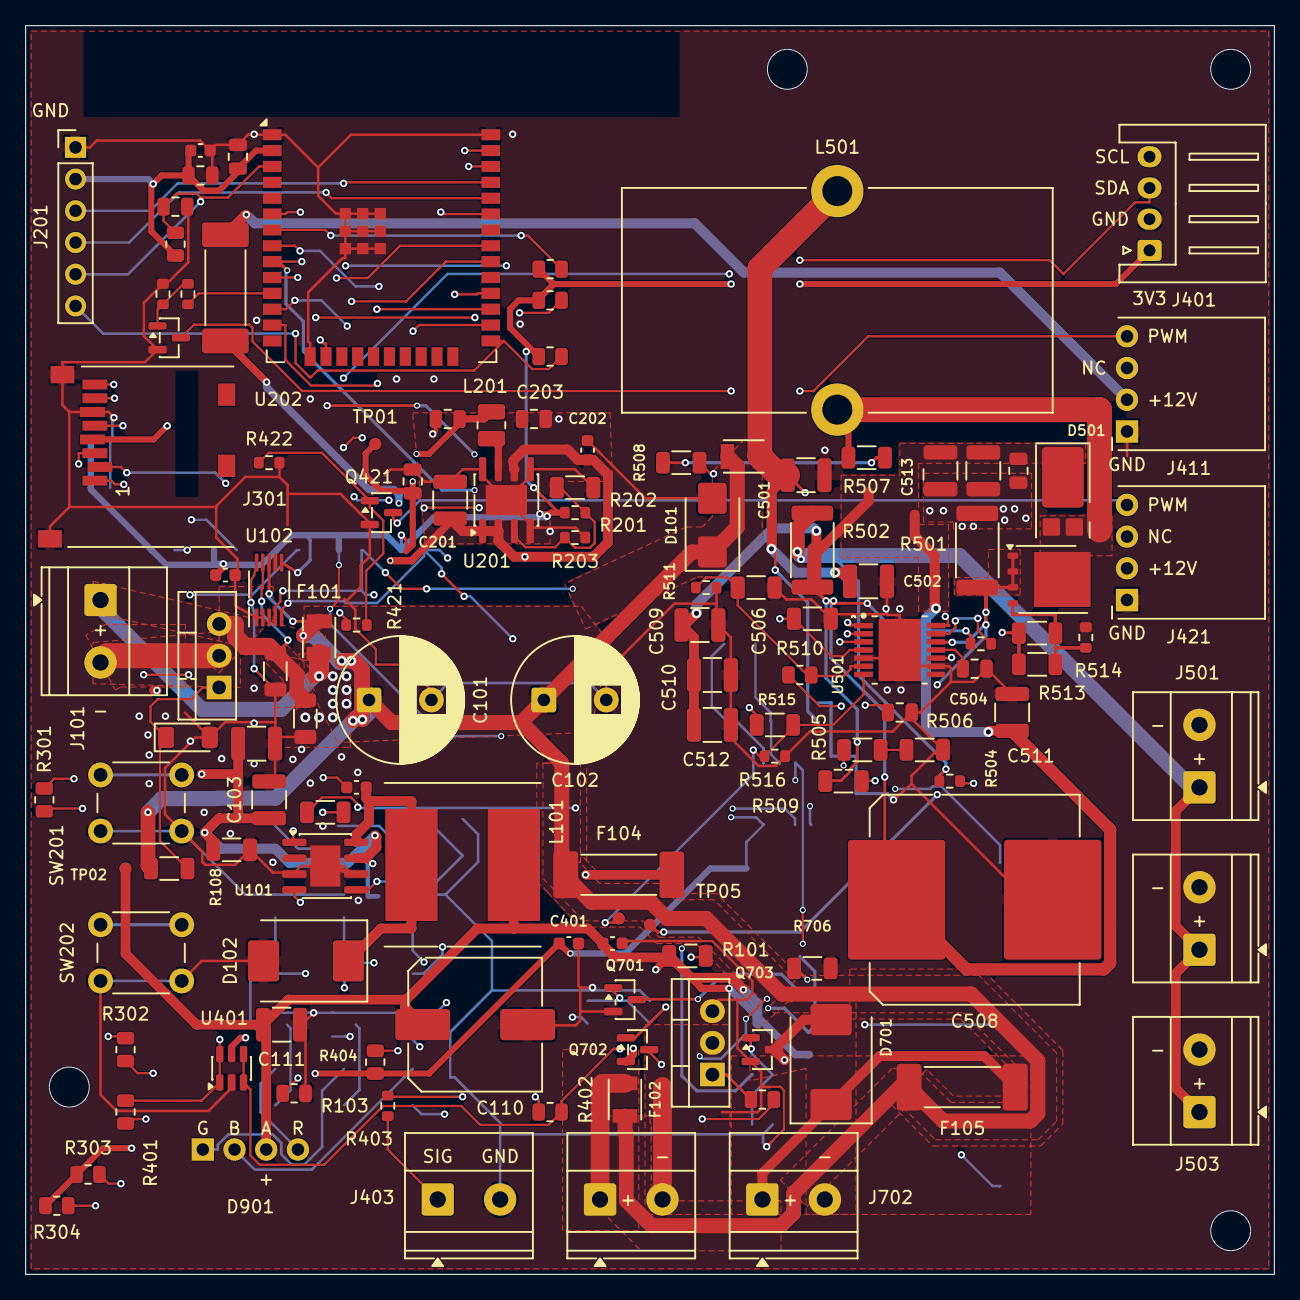
[picture p18: board PCB_EU_LITE.kicad_pcb from above]

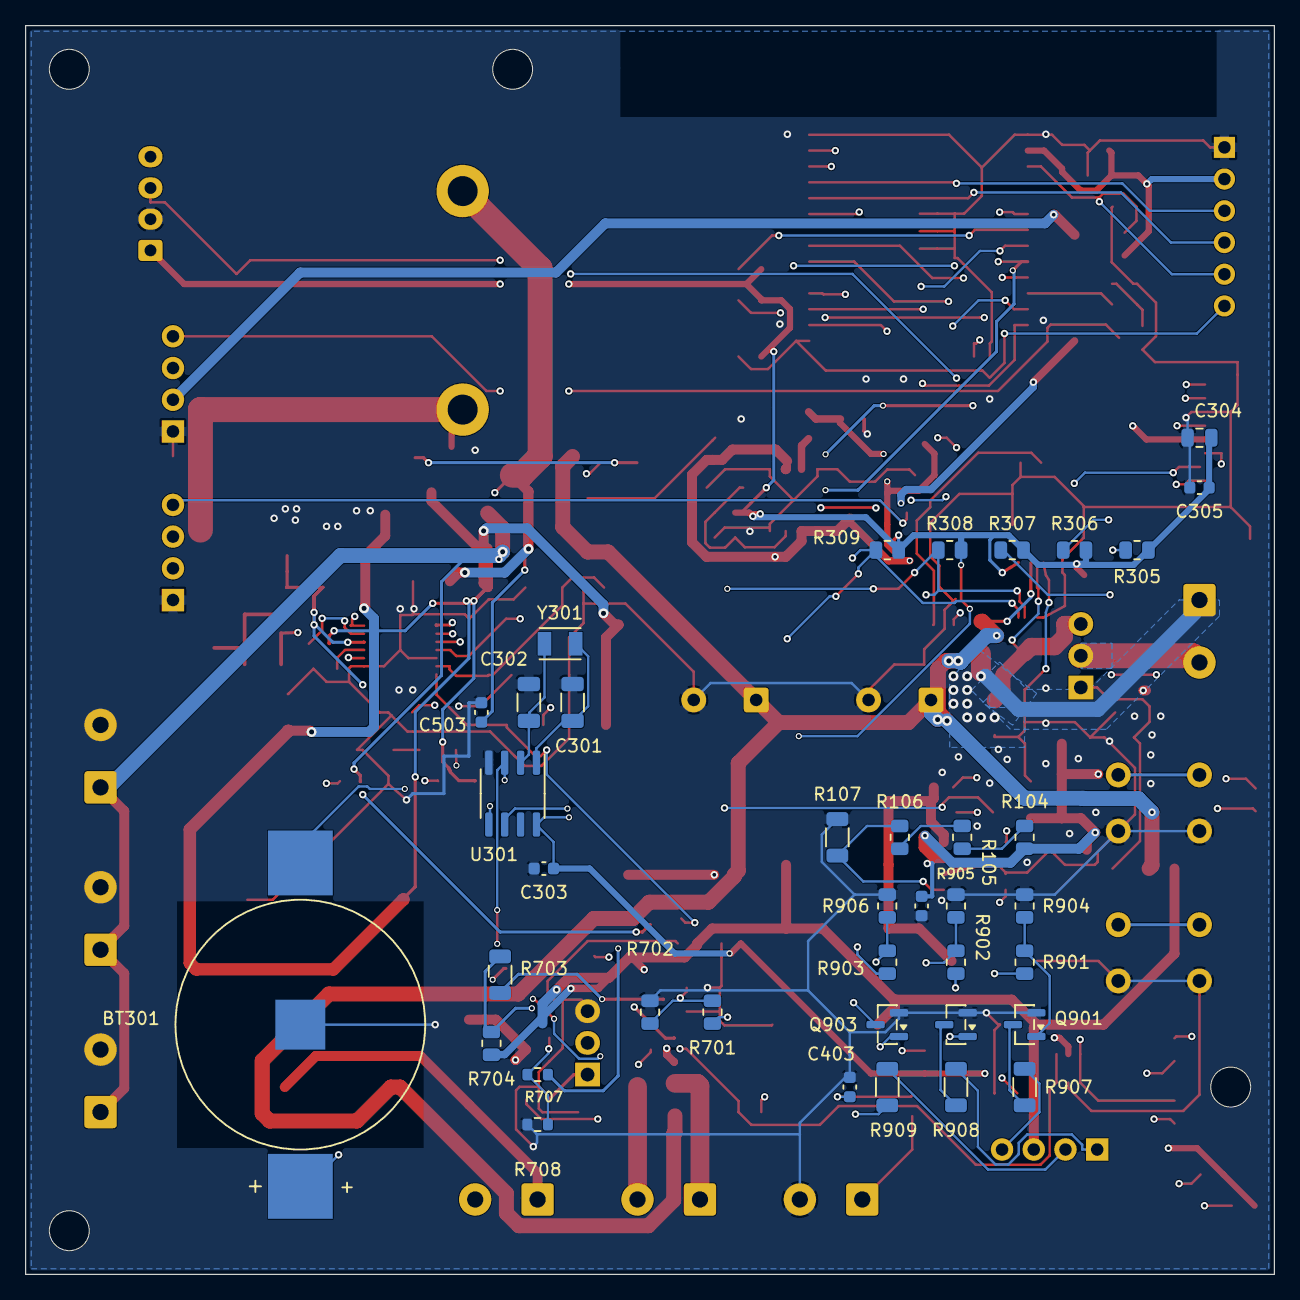
[picture p19: board PCB_EU_LITE.kicad_pcb from below]

Board: 4 copper layers, 100.0 x 100.0 mm, 167 parts (38 on the bottom side), 91 nets.

Other parts of the board:
H1, H2, H3, H4: M3 NPTH 3.2 / proposed
