nikolajevs/MicroGarden_V1/firmware/DashCA.h

#pragma once
// ISRG Root X1 (Let's Encrypt), корень цепочки сертификатов dash.dvinsk.lat.
// Сертификат выпускает Traefik на хосте 93.127.143.133; цепочка leaf <- YR1 <- Root YR <- ISRG Root X1
// проверена `openssl s_client -CAfile` (27.10.2026). Срок действия корня: до 04.06.2035.
// https://letsencrypt.org/certs/isrgrootx1.pem  SHA-256: 96:BC:EC:06:26:49:76:F3:74:60:77:9A:CF:28:C5:A7:CF:E8:A3:C0:AA:E1:1A:8F:FC:EE:05:C0:BD:DF:08:C6
static const char DASH_ROOT_CA[] = R"PEM(-----BEGIN CERTIFICATE-----
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
-----END CERTIFICATE-----
)PEM";
