nikolajevs/MicroGarden_V1/(commit log)

2026-10-26 Import standalone EU-LITE hardware and finalize project documentation
    [Aux12V.kicad_sch, BOM_allocated.csv, InputPower.kicad_sch, Interfaces.kicad_sch, LED.kicad_sch, Loads.kicad_sch, MCU.kicad_sch, PCB_EU_LITE.kicad_pcb]
2026-10-27 Fix slow first telemetry run and WDT-resetting fatal halts
    Первый выход в облако шёл только через 2 минуты после включения: сон
    стоял в начале цикла задачи Ubidots. Теперь первый заход через 5 с, а
    сохранение настроек Wi-Fi/Ubidots будит задачу уведомлением, не дожидаясь
    конца сна.
    Фатальные ошибки инициализации (NVS) останавливались в while(true)
    delay(1000) без сброса WDT и перезагружали плату каждые 15 с. Все такие
    места сведены в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
    [firmware.ino]
2026-10-27 Reduce status LED palette to six high-contrast colours
    Оранжевый (зелёный на 1/3 яркости) и белый убраны: на глаз они путались
    с жёлтым и ярким голубым. Остались шесть цветов, где каждый канал либо
    полностью включён, либо выключен — красный, зелёный, синий, голубой,
    пурпурный, жёлтый.
    Нагреватель переведён с оранжевого на жёлтую вспышку, отправка телеметрии
    с белого на пурпурную. Правило чтения: ровный или м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
2026-10-27 Drop process flashes from the status LED
    Вспышки помпы, нагревателя и отправки телеметрии убраны — ход работы
    виден в веб-интерфейсе, индикатор отвечает только за неисправности.
    Остались пять состояний: красный, пурпурный, мигающий синий, жёлтый и
    зелёный. Голубой из палитры убран, вместе со вспышками ушли параметры
    heater/pump/activity у statusColor() и атомик rgb_activity_ms с обеими
    точками записи.
    Compile-time проверки пе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
2026-10-27 Drop the Wi-Fi blink from the status LED
    Отсутствие связи с роутером индикатором больше не показывается — это
    видно в веб-интерфейсе. Вместе с миганием ушли параметры now и wifiOk
    у statusColor() и аргумент nowMs у updateStatusLed(): мигание было
    единственным, чему требовалось время.
    Индикатор светится ровно: красный, пурпурный, жёлтый, зелёный. Синий
    остался за setup() как признак идущей инициализации, поэтому в палитре
    о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
2026-10-27 Remove Ubidots telemetry from firmware and UI
    Из прошивки убраны токен, device label, UbidotsCA.h, WiFiClientSecure,
    HTTPClient, SNTP-синхронизация UTC и сборка JSON-полезной нагрузки.
    Из настроек ушли поля ubidots_token и device_label вместе с ограничениями
    TOKEN_MAX/LABEL_MAX.
    Подключение к роутеру сохранено: vUbidotsTask заменена на vWifiTask,
    которая держит STA-соединение, чтобы веб-интерфейс был доступен из
    домашней сети. Стек задачи уменьшен с 12 КБ до 4 КБ — 12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
2026-10-27 Release verified r3 Gerber package and align F103 value
    [PCB_EU_LITE-B_Cu.gbl, PCB_EU_LITE-B_Mask.gbs, PCB_EU_LITE-B_Silkscreen.gbo, PCB_EU_LITE-Edge_Cuts.gm1, PCB_EU_LITE-F_Cu.gtl, PCB_EU_LITE-F_Mask.gts, PCB_EU_LITE-F_Silkscreen.gto, PCB_EU_LITE-NPTH.drl]
2026-10-27 Document 275 kHz transition and current-margin blocker
2026-10-27 Revise LED transition to 70 W and 285 kHz
2026-10-27 Use standard 82k and 1k LED setting resistors
2026-10-27 Apply the 283 kHz LED transition to sources, model and docs
    Set R507 to 82k and R506 to 1k in the generator, regenerate the schematic,
    design.json and BOM, and carry the new operating point (283.45 kHz,
    1.444 A, 69.3 W) through verify.py, the power-stage model and the docs.
    Only the Value fields of R506/R507 change on the board; geometry, nets and
    silkscreen are untouched.
    The procurement blocker is resolved: 82k is already in the 2026-10-23
    catalogue snapshot and is now bought twice (R101 + R507); the 1k 1206 line
    is added from the Salvats product page read on 2026-10-27 and preserved on
    refresh through snapshot_prices.SITE_QUOTES. Purchase total is unchanged at
    38.49 EUR with no unpriced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
    [BOM_allocated.csv, LED.kicad_sch, PCB_EU_LITE.kicad_pcb]
2026-10-27 Add telemetry dashboard server and page for dash.dvinsk.lat
    Замена Ubidots: сервер приёма телеметрии платы и страница с графиками и
    сообщениями из Serial.
    - dashboard/server.py: приём POST /api/ingest (токен), SQLite, API просмотра
    под HTTP Basic, выгрузка CSV, ограничение подбора пароля, CSP. Только
    стандартная библиотека Python.
    - Журнал платы приходит порциями со смещением и номером запуска: повтор
    безопасен, пропуски и перезагрузки помечают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
2026-10-27 Return real booleans in dashboard status
    Флаги лежали в last_sample как 0/1, а страница сравнивает их с false, поэтому
    отказ датчика и неверные часы не показывались. Теперь /api/status отдаёт
    true/false, страница на всякий случай понимает и 0.
2026-10-27 Retry the nginx check in enable-nginx.sh after reload
    Сразу после systemctl reload первые запросы обслуживают старые рабочие
    процессы, и проверка получала 404 от хоста по умолчанию, хотя хост
    подключился правильно. Проверка теперь повторяется до 10 секунд.
2026-10-27 Send telemetry and console log to the dashboard server
    Плата раз в минуту отправляет показания и новые строки журнала на сервер
    панели (dashboard/, по умолчанию https://dash.dvinsk.lat/api/ingest) по
    контракту из dashboard/README.md.
    - Telemetry.h: чистые функции выбора порции журнала (только целые строки,
    без разрыва символа UTF-8, пропуск затёртой части кольцевого буфера),
    проверка адреса, имени платы и токена, правило записи итога в журнал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
2026-10-27 Keep the LED on when the INA238 power meter is silent
    Раньше любой пропущенный отсчёт INA238 мгновенно гасил свет («нет достоверных
    данных питания»). Теперь решение зависит от того, что именно известно:
    - измеренное напряжение ниже 21,6 В по-прежнему выключает свет, повторное
    включение от 22,5 В;
    - одиночный пропущенный отсчёт решение не меняет, холодный пуск ждёт первого
    измерения;
    - измеритель не отвечает со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
2026-10-27 Accept log text cut in the middle of a UTF-8 character
    Строгое чтение тела запроса давало 400 на каждый повтор, если прошивка
    отправила порцию с обрезанной русской буквой, и приём журнала вставал
    насовсем. Битые байты теперь заменяются знаком подстановки.
2026-10-27 Water and light on the software clock when the RTC is silent
    Раньше при молчащем RTC полив выключался, даже если время было известно
    (RTC работал и отказал, либо владелец ввёл время вручную). Теперь есть
    понятие «время пригодно» (clock_usable): RTC достоверен, либо программный
    таймер выставлен настоящим источником с момента запуска. Дефолтная дата
    при мёртвом RTC источником не считается.
    - Расписание полива и отметка по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
2026-10-27 Add RGB indicator brightness and night mode settings
    Яркость индикатора была зашита константой, а ночью он светил в тёмный
    период растений. Теперь на странице настроек (вкладка «Общее») есть:
    - яркость 0-100 %, 0 выключает индикатор; по умолчанию 19 % = 48 из 255,
    то есть прежняя яркость;
    - ночной режим: как днём (по умолчанию), только неисправности (зелёный
    гаснет, красный, пурпурный и жёлтый остаются) или выключен.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
2026-10-27 Add a colour legend for the RGB indicator to the settings page
    Рядом с настройками индикатора (вкладка «Общее») появилась расшифровка
    цветов: красный, пурпурный, жёлтый, зелёный, синий и «не светится», с
    порядком приоритета. Тест сверяет список цветов в легенде с StatusColor
    в LiteControl.h, чтобы они не разошлись при добавлении нового цвета.
2026-10-27 Add an alerts bell with a counter to the main page
    В шапке главной страницы появился колокольчик с числом активных оповещений
    и список по нажатию. Оповещения — текущие неисправности из /api/status,
    они пропадают, когда причина устранена: датчик SHT4x, часы RTC (красное без
    времени, жёлтое на программном таймере), низкое питание, молчащий
    измеритель питания, пустой бак, пропущенный полив, нет SD-карты, нет связи
    с п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
2026-10-27 Remove the clock warning banner from the main page header
    Полоса «Часы RTC не отвечают — ... полив выключен» в шапке главной страницы
    дублировала колокольчик: то же оповещение (с теми же двумя уровнями — без
    времени красное, на программном таймере жёлтое) уже собирает alerts.js.
    Элемент clock-warning и код, который его заполнял, удалены; README описывает,
    где теперь смотреть неисправность часов.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
2026-10-27 Do not switch the LED off when the temperature sensor is silent
    Когда измеритель питания не отвечает, свет раньше гасился, если не отвечал
    и датчик SHT4x. Датчик температуры не причина оставлять растения в темноте:
    теперь условие для света при молчащем измерителе — только известное время
    (иначе неизвестно, день или ночь). Если датчик SHT4x тоже молчит, свет идёт
    на минимальном уровне по аварийному режиму климата (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
2026-10-27 Show the heater run time for the day on the main page card
    В карточке «Обогреватель» появилась строка «Сегодня: 2 ч 05 мин»: сколько
    нагреватель проработал за сутки платы. Счёт идёт на каждом проходе loop()
    по реальному времени между проходами и начинается заново в полночь по часам
    платы или при переводе часов на другой день. Как и энергия за сутки, он не
    хранится в NVS и после перезагрузки идёт с запуска платы.
    - S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
2026-10-28 Keep the lamp at full power below target, watch humidity at night
    Growing climate, owner decision of 2026-10-28:
    - Below the target the lamp stays at maximum and the fans at minimum; the
    heater only adds heat (on at target - delta, off at target). Above the
    target the lamp dims and the fans speed up, reaching the limits at
    target + delta. Previously both curves started at target - delta, so the
    lamp dimmed while heating and the fans jumped to mid-range the moment the
    heater switched off.
    - At night the fans also follow humidity: new settings hum_target_night
    (default 70 %) and hum_band_night (default 10 %); the larger demand wins,
    also while heating. 100 % disables it. Daytime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
2026-10-28 Default night humidity 55 %, heater hard limit 40 C
    Owner decisions of 2026-10-28:
    - hum_target_night defaults to 55 % (band stays 10 %). Boards that never
    saved this setting pick up the new default.
    - HEATER_HARD_LIMIT_C lowered from 60 to 40 C: the heater switches off at
    40 C whatever the settings say. Regression and docs updated.
    Claude-Session: https://claude.ai/code/session_01YbDYdNjnRkwv3bcN8oKJ6M
2026-10-28 Cap temperature targets at the 40 C heater limit
    Day, night and drying targets now accept at most HEATER_HARD_LIMIT_C, both
    in SETTING_DEFS and in the settings page. A higher value saved by an older
    build is clamped to 40 C when loaded. A Node test keeps the page maximum,
    the firmware table and Board.h in step.
    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
2026-10-28 Default night target 17 C and drying target 16 C
    Owner decision of 2026-10-28. Boards that already saved these settings keep
    their stored values. A Node test pins the climate defaults.
    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
2026-10-28 Stitch the shunt ground and tighten the LED commutation loop
    The GND pads of the INA238 shunts R111/R112 had no via to the inner
    ground plane, so the whole return current climbed to F.Cu through a
    SW201 pin and narrow pour necks (up to 33 A/mm in a DC model). Add 19
    GND vias at the shunts and across their F.Cu ground island.
    Rebuild the LED boost cell: D501 sits on the Q501 drain, C515 and two
    4.7 uF capacitors (C514/C513 moved from the end of the output column)
    run from the D501 cathode to a local ground shared with R501, the
    inductor feed reaches the switch node from outside the loop, and the
    gate resistors move under Q501. Give C508 a 1 mm feed instead of the
    0.25 mm trace, and sync the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
    [PCB_EU_LITE.kicad_pcb]
2026-10-28 Release the r4 Gerber package and mark r3 as superseded
    Full fabricate.py profile on the fixed board: ERC, DRC with schematic
    parity (0 issues, 0 unconnected, 35 silk-only library warnings),
    placement, power paths, Kelvin isolation, silkscreen, verify.py and
    an independent gerbonara CAM import. Run on KiCad 10.0.5 with
    --allow-other-version, so the manifest records the 10.0.7 target as
    not verified.
    Update the hardware README, DESIGN and the release index: r3 lacks the
    shunt ground vias and must not be ordered.
    [PCB_EU_LITE-B_Cu.gbl, PCB_EU_LITE-B_Mask.gbs, PCB_EU_LITE-B_Silkscreen.gbo, PCB_EU_LITE-Edge_Cuts.gm1, PCB_EU_LITE-F_Cu.gtl, PCB_EU_LITE-F_Mask.gts, PCB_EU_LITE-F_Silkscreen.gto, PCB_EU_LITE-NPTH.drl]
2026-10-29 Add an alerts bell to the telemetry dashboard and drop the status badges
    В шапке панели появился колокольчик с числом оповещений и списком по
    нажатию, как на главной странице платы. Оповещения — то, что требует
    внимания сейчас: нет связи с платой (пока молчит, её последние показания
    помечаются «по последним данным»), датчик SHT4x, часы, питание, пустой бак,
    пропущенный полив, SD-карта и свежие ошибки журнала за последн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
2026-10-29 Send clock_usable, water_skipped and op_mode in telemetry
    Панель считает оповещения теми же правилами, что и главная страница платы,
    а для них нужны три поля, которых в телеметрии не было: есть ли пригодное
    время, пропущен ли последний полив и режим работы (выращивание или сушка).
    Старый сервер незнакомые поля отбрасывает, поэтому порядок обновления
    панели и прошивки значения не имеет.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
2026-10-29 Show the router WiFi state and the board IP in the settings UI
    Страница настроек, вкладка «WiFi», показывает состояние подключения к роутеру
    и IP-адрес, который роутер выдал плате, со ссылкой на интерфейс по этому адресу
    и уровнем сигнала.
    - /api/status отдаёт wifi_state, wifi_ip, wifi_rssi и ap_ip. Состояние выбирает
    constexpr wifiState() из LiteControl.h, таблица истинности проверяется
    в SafetyTests.h. Адрес читается один раз, «подключено» только с нас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
2026-10-29 Show the board IP in the main page header
    Адрес платы в сети роутера теперь виден и в шапке главной страницы: значок
    «📶 192.168.1.57» рядом с фазой цикла. Он есть, только пока плата подключена
    к роутеру; при попытке подключения, обрыве и незаданной сети его нет. Если
    страница перестала получать ответы платы, значок убирается: адрес мог смениться.
    - Format.routerAddress() в format.js выбирает адрес из /api/status и пропускает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
2026-11-01 Add a WiFi signal strength setting for the board access point
    Страница настроек, вкладка «WiFi», в форме точки доступа получила список «Сила сигнала»:
    слабый (7 дБм), средний (13 дБм), сильный (19,5 дБм, по умолчанию).
    - Настройка wifi_power в таблице SETTING_DEFS (ключ NVS wifi_power). Без сохранённого значения
    плата остаётся на сильной мощности, как у SDK, поэтому у прошитых плат ничего не меняется.
    - wifiPowerQuarterDbm() в LiteControl.h и static_assert в SafetyT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
2026-11-01 Fit the main page header in one row
    Шапка главной страницы теперь занимает одну строку на любой ширине экрана,
    в том числе на телефоне: слева время, значок цикла и адрес платы, справа
    колокольчик и кнопка-шестерёнка вместо слова «Настройки».
    - Значок цикла стал короче: фазу суток передаёт значок ☀️ или 🌙, текст —
    «День 160» вместо «День · День цикла: 160». В сушке «🍂 Сушка», без времени
    «🕓 Нет вре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
2026-11-01 Add a board registry and per-board tokens to the dashboard
    Панель телеметрии получила страницу «Платы» (/boards): плату регистрируют,
    и она получает свой токен приёма. Править .env и ходить по ssh для этого
    больше не нужно.
    - Реестр плат (таблица boards) и токены (таблица tokens). В базе только
    SHA-256 токена, сам токен виден один раз при создании.
    - Токен привязан к плате; данные принимаются только от зарегистрированных
    плат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
2026-11-01 Add people accounts with open registration to the dashboard
    Люди регистрируются на сайте сами (/register), входят по имени и паролю и
    добавляют свои платы: у каждой платы свой токен, человек видит только свои
    платы и их данные. Администратор (имя и пароль из .env) видит всех и управляет
    людьми на странице /admin.
    - Таблицы users и sessions. Пароли хранятся только как scrypt, сессия лежит
    в cookie (HttpOnly, SameSite=Lax, за HTTPS ещё Secure), в базе её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
2026-11-01 Let the firmware apply settings requested from the dashboard
    Плата сообщает панели свои настройки в каждой отправке (раздел cfg) и
    применяет запрос на их изменение из ответа сервера, если владелец поставил
    галочку на самой плате. По умолчанию галочка выключена.
    - CloudSettings.h: список настроек, которые можно менять издалека (28),
    строгий разбор ответа сервера и проверка значений; всё чистые функции,
    проверяются stati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
2026-11-01 Add board settings to the dashboard: page, API and request queue
    Страница /settings показывает настройки, которые плата сообщила сама, и
    ставит в очередь их изменение. Плата забирает запрос в ответе на очередную
    отправку данных и подтверждает его в следующей.
    - Таблицы device_cfg (то, что плата сообщила) и cfg_changes (запросы и их
    история: кто, когда, что, итог). Раздел cfg в приёме разбирается строго,
    негодные значения отбрас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
2026-11-01 Hide board settings that do not work in the current mode
    В режиме сушки свет и полив выключены, поэтому страница «Настройки платы»
    больше не показывает их поля. Так же устроена страница самой платы.
    - В сушке спрятаны: климат при выращивании, освещение, автополив, цикл
    выращивания. В выращивании спрятан климат сушки. Остальное видно всегда.
    - Какая группа в каком режиме работает, задаёт поле modes у групп в
    CF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
2026-11-01 Redesign the boards page: compact cards and far less text
    Страница «Платы» была перегружена пояснениями и однообразными блоками. Теперь
    карточка платы короткая и читается с одного взгляда.
    - Карточка: цветная полоса по связи, название и имя платы, значки «Онлайн»,
    «Нет связи · N мин назад» или «Нет данных», версия прошивки, токены одной
    строкой (название, начало, когда использовался), кнопки «Токен»,
    «Нас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
2026-11-01 Show only the start hint on the main page until a board sends data
    Пока ни одна плата не прислала замеров, на главной странице остаются шапка и
    подсказка, как подключить плату. Показания, графики, журнал и подвал, которые
    всё равно были пустыми, спрятаны.
    - Дашборд обёрнут в #dash; app.js переключает его вместе с подсказкой и
    показывает раньше, чем на нём рисуются графики (у скрытого блока нулевая
    ширина). Как придёт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
2026-11-01 Add email confirmation, password recovery and mail settings to the dashboard
    Панель умеет отправлять письма через внешний SMTP-сервис: подтверждение
    адреса при регистрации и восстановление пароля по ссылке. Почта
    необязательна: пока в .env не заданы DASH_SMTP_HOST, DASH_MAIL_FROM и
    DASH_PUBLIC_URL, всё работает как раньше.
    - Регистрация просит адрес и шлёт ссылку; подтверждает только нажатие
    кнопки на странице /verify. Платы без подтверждён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
2026-11-02 Add Google sign-in to the dashboard
    Кнопка «Войти через Google» на страницах входа и регистрации (OpenID
    Connect, код авторизации с PKCE). Включается настройками
    DASH_GOOGLE_CLIENT_ID, DASH_GOOGLE_CLIENT_SECRET и DASH_PUBLIC_URL;
    запрашиваются только openid и email.
    - Новый человек получает запись без пароля с уже подтверждённой почтой
    (платы можно добавлять сразу); запись с таким же подтверждённым адресом
    связывается с аккаунтом Google; повто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
2026-11-02 Harden the configure scripts and the .env loader against stray bytes
    При первом вводе ключей Google на VPS в адрес сайта попал одинокий байт
    0xD0: скрипт упал на записи .env с трассировкой Python (сам файл не
    менялся). Теперь:
    - env-lib.sh: ответы принимаются только латиницей и обычными знаками
    (явный диапазон от пробела до «~», а не класс [[:print:]]: в Git Bash он
    пропускает байты выше 0x7F); вопрос повторяется, после трёх попыток выход
    бе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
2026-11-02 Make the Google buttons light and add the Google icon
    Кнопки «Войти через Google» и «Зарегистрироваться через Google» были
    синим текстом по тёмному фону и плохо читались. Теперь они светлые в
    любой теме (тёмный текст по белому, серая рамка) и с фирменной «G» в
    четыре цвета. Значок нарисован прямо в странице (SVG), поэтому внешние
    картинки и CSP не затрагиваются; для экрана он скрыт, подпись остаётся
    текстом. На телеф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
2026-11-02 Remove V1 and the telemetry tagline from the page headers
    По просьбе владельца: заголовок главной страницы теперь «MicroGarden»
    без V1, а подпись «Телеметрия платы» (на страницах входа, регистрации и
    восстановления: «Телеметрия плат») убрана полностью.
    - Строка под названием на главной остаётся только для данных платы
    («Плата …, прошивка, Wi-Fi, время работы»): пока замеров нет, она
    скрыта и пуста, а не показывает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
2026-11-02 Add footer links, privacy policy, terms and self-service data erasure
    Подвал со ссылками на всех страницах панели, политика конфиденциальности
    и условия, удаление данных и аккаунта самим человеком (GDPR, статья 17).
    - Подвал: политика, условия, cookie, «Удалить данные и аккаунт», контакты,
    исходный код. Разметка одинаковая на всех 12 страницах, это проверяет тест.
    - /privacy и /terms открыты всем, в том числе вошедшему. Сервер по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
2026-11-02 Remove the source code link and mention from the pages
    По просьбе владельца страницы больше не упоминают исходный код: из подвала
    всех 12 страниц убрана ссылка «Исходный код», из политики конфиденциальности
    фраза об открытом коде сервера.
    - В подвале остались пять ссылок, все внутри сайта.
    - Тест подвала проверяет, что на страницах нет github.com, «исходный код»
    и «репозиторий»; проверка «нет V1» на главной сно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
2026-11-02 Prune the -wal and -shm tails together with old backup copies
    При проверке на VPS выяснилось, что рядом с каждой копией базы лежат файлы
    -wal и -shm (SQLite создаёт их, когда копию открывают для проверки
    целостности), а prune-backups.sh их не замечал: после удаления копии они
    оставались бы на диске.
    - Скрипт ищет копии и их хвосты -wal и -shm; хвосты удаляемой копии уходят
    вместе с ней, даже если моложе срока; хвост без копии удаляе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
